feaksel/5level-inverter/02-embedded/riscv-soc-vexrv/rtl/cpu/BUS_ARCHITECTURE.md

# VexRiscv Integration - Bus Architecture Documentation

**Date:** 2024-11-16
**Version:** 1.0
**Author:** RISC-V SoC Team

---

## Overview

This document explains the bus architecture decision for integrating VexRiscv into the 5-level inverter RISC-V SoC, specifically addressing the question:

> **Should we use Wishbone or VexRiscv's native bus interface?**

**Answer:** Use **Wishbone with adapter bridges** (current implementation)

---

## Executive Summary

**VexRiscv** uses a simple **cmd/rsp handshaking protocol** on both instruction and data buses.
**Our SoC** uses **Wishbone B4** throughout all peripherals and memory subsystems.

**Solution:** Lightweight **VexRiscv-to-Wishbone adapters** in `vexriscv_wrapper.v`

---

## Bus Protocol Comparison

### VexRiscv Native Bus (cmd/rsp)

**Instruction Bus (iBus):**
```
Master (CPU) Side:
  - iBus_cmd_valid     : CPU wants instruction
  - iBus_cmd_payload_pc: Program counter address
  - iBus_cmd_ready     : Bus accepts request (from slave)

Slave (Memory) Side:
  - iBus_rsp_valid         : Instruction ready
  - iBus_rsp_payload_inst  : Instruction data
  - iBus_rsp_payload_error : Fetch error
```

**Data Bus (dBus):**
```
Master (CPU) Side:
  - dBus_cmd_valid           : CPU wants data access
  - dBus_cmd_payload_wr      : Write enable (1=write, 0=read)
  - dBus_cmd_payload_address : Memory address
  - dBus_cmd_payload_data    : Write data
  - dBus_cmd_payload_mask    : Byte enable mask
  - dBus_cmd_payload_size    : Access size (00=byte, 01=half, 10=word)
  - dBus_cmd_ready           : Bus accepts request (from slave)

Slave (Memory) Side:
  - dBus_rsp_ready : Response ready
  - dBus_rsp_data  : Read data
  - dBus_rsp_error : Access error
```

**Characteristics:**
- Simple valid/ready handshaking
- Single-cycle when ready
- No explicit cycle control
- Minimal overhead

### Wishbone B4 (Our SoC Standard)

**Master (CPU) Interface:**
```
  - CYC (Cycle)      : Transaction active
  - STB (Strobe)     : Valid request
  - WE (Write Enable): Read/write control
  - ADR (Address)    : Memory address
  - DAT_O (Data Out) : Write data
  - SEL (Select)     : Byte lane select
  - ACK (Acknowledge): Slave accepts/completes (from slave)
  - ERR (Error)      : Bus error (from slave)
  - DAT_I (Data In)  : Read data (from slave)
```

**Characteristics:**
- Industry standard (OpenCores)
- Well-documented and widely adopted
- ASIC-proven in many tape-outs
- Supports multi-master arbitration
- Compatible with IP cores ecosystem

---

## Decision: Use Wishbone + Adapters

### Rationale

1. **SoC Already Wishbone-Based**
   - All peripherals use Wishbone: PWM, ADC, UART, Timer, GPIO, Protection
   - Memory subsystem uses Wishbone
   - Interconnect (`wishbone_interconnect.v`) already implemented
   - Changing to VexRiscv native would require **rewriting everything**

2. **Industry Standard = Portability**
   - Wishbone is silicon-proven in 180nm to 7nm nodes
   - Documented by OpenCores (free, open specification)
   - Easier IP core integration from third parties
   - Better support for multi-master (future DMA, co-processors)

3. **ASIC Migration (Stage 5-6)**
   - Project roadmap includes ASIC tape-out (Stage 5: RISC-V ASIC, Stage 6: Custom ASIC)
   - Wishbone is well-understood by ASIC vendors
   - Synthesis tools have better support for Wishbone
   - Standard interfaces reduce NRE (non-recurring engineering) costs

4. **Minimal Performance Overhead**
   - Adapter is **very lightweight** (2 registers, simple FSM)
   - Adds only **1 clock cycle latency** per transaction
   - VexRiscv is not performance-critical for 10 kHz PWM control
   - System bottleneck is control loop (10 kHz), not CPU speed

5. **Modularity and Testing**
   - Wishbone makes it easy to swap CPU cores (try different RISC-V cores)
   - Standard interface simplifies testbenches
   - Bus monitors and protocol checkers readily available
   - Easier to verify in simulation

### Cost-Benefit Analysis

| Aspect | VexRiscv Native Bus | Wishbone + Adapters |
|---|---|---|
| **Performance** | Fastest (no conversion) | ~1 cycle overhead |
| **SoC Compatibility** | Requires rewrite of ALL peripherals | Plug-and-play |
| **ASIC Readiness** | Custom, less proven | Industry standard |
| **IP Core Ecosystem** | Limited | Extensive (OpenCores, etc.) |
| **Documentation** | VexRiscv-specific | Well-documented standard |
| **Multi-Master** | Harder to implement | Native support |
| **Verification** | Custom testbenches | Standard verification tools |
| **Portability** | Tied to VexRiscv | CPU-agnostic |
| **Implementation Effort** | High (months) | Low (hours) |

**Winner:** Wishbone + Adapters

---

## Adapter Implementation

The `vexriscv_wrapper.v` module contains two lightweight adapters:

### 1. Instruction Bus Adapter (iBus)

**State Machine:**
```
IDLE:
  - Wait for vex_ibus_cmd_valid
  - When valid: Start Wishbone transaction (CYC=1, STB=1)
  - Go to ACTIVE

ACTIVE:
  - Hold CYC=1, STB=1 until ibus_ack
  - When ack: Assert vex_ibus_rsp_valid
  - Return to IDLE
```

**Resource Usage:**
- 1 register (`ibus_active`)
- ~10 LUTs for logic

**Latency:** 1-2 cycles per instruction fetch (depending on memory response)

### 2. Data Bus Adapter (dBus)

**State Machine:**
```
IDLE:
  - Wait for vex_dbus_cmd_valid
  - When valid: Start Wishbone transaction (CYC=1, STB=1, WE, SEL, ADR, DAT)
  - Go to ACTIVE

ACTIVE:
  - Hold transaction until dbus_ack or dbus_err
  - When ack/err: Assert vex_dbus_rsp_ready with data/error
  - Return to IDLE
```

**Resource Usage:**
- 1 register (`dbus_active`)
- ~15 LUTs for logic

**Latency:** 1-2 cycles per data access (depending on memory/peripheral response)

---

## Performance Analysis

### Worst-Case Latency

**Without Adapter (VexRiscv Native):**
- Memory access: 1 cycle (if memory has 1-cycle response)
- Instruction fetch: 1 cycle

**With Adapter (Current Design):**
- Memory access: 2 cycles (1 cycle adapter FSM + 1 cycle memory)
- Instruction fetch: 2 cycles

**Impact on System:**
- PWM control loop: 10 kHz = 100 µs period
- At 50 MHz clock: 5,000 cycles per PWM period
- Additional ~100 cycles overhead from adapters (<2% impact)
- **Conclusion:** Negligible impact on inverter control performance

### Resource Usage

**Adapter Overhead:**
- 2 registers (ibus_active, dbus_active)
- ~25 LUTs total
- 0 BRAM, 0 DSP

**Percentage of Artix-7 XC7A35T:**
- Registers: ~0.01% of 41,600 FFs
- LUTs: ~0.1% of 20,800 LUTs

**Conclusion:** Trivial resource cost

---

## Alternative Considered: VexRiscv Native Throughout

**What would this require?**

1. **Rewrite All Peripherals:**
   - PWM accelerator
   - ADC interface
   - Protection module
   - Timer
   - GPIO
   - UART
   - Total: ~1,500 lines of Verilog

2. **Rewrite Interconnect:**
   - Custom arbiter (currently Wishbone interconnect)
   - Address decoder
   - Response multiplexer
   - Total: ~300 lines of Verilog

3. **Update All Testbenches:**
   - 8+ testbench files
   - Bus functional models
   - Total: ~500 lines of testbench code

4. **Throw Away ASIC Portability:**
   - Custom bus is harder to tape out
   - Less vendor support
   - Higher NRE costs

**Estimated Effort:** 2-4 weeks of engineering time

**Benefit:** Save ~1 cycle per memory access

**Verdict:** **Not worth it** for this application

---

## Future Considerations

### Multi-Master Support

Wishbone naturally supports multiple bus masters:
- Current: Single master (VexRiscv CPU)
- Future: Add DMA controller for high-speed ADC streaming
- Future: Add hardware accelerators as bus masters

The adapter design doesn't prevent this - the interconnect handles arbitration.

### CPU Core Portability

With Wishbone interface, we can easily swap CPU cores:
- Try **PicoRV32** (smaller, slower)
- Try **SERV** (smallest RISC-V, bit-serial)
- Try **Rocket Core** (faster, out-of-order)
- Try **BOOM** (Berkeley Out-of-Order Machine)

All we need is a Wishbone adapter for each core.

### ASIC Migration (Stage 5-6)

When moving to ASIC:
- Wishbone is well-supported by synthesis tools (Synopsys, Cadence)
- Standard buses reduce verification effort
- Silicon vendors are familiar with Wishbone
- Lower risk = lower cost

---

## Verification Strategy

### Simulation Tests

1. **Unit Test: iBus Adapter**
   - Test single fetch
   - Test back-to-back fetches
   - Test wait states

2. **Unit Test: dBus Adapter**
   - Test single read
   - Test single write
   - Test byte/halfword/word access
   - Test error response

3. **Integration Test: CPU + Memory**
   - Run simple RISC-V program
   - Verify instruction fetch
   - Verify data load/store

4. **System Test: Full SoC**
   - Boot firmware
   - Access all peripherals
   - Run PWM control algorithm

### Hardware Verification (FPGA)

1. Load firmware via UART
2. Test basic CPU functions (LED blink)
3. Test peripheral access (PWM, ADC, UART)
4. Run full inverter control loop
5. Measure timing with oscilloscope

---

## Conclusion

**Decision:** Use **Wishbone bus with VexRiscv-to-Wishbone adapters**

**Justification:**
- Minimal performance overhead (~1 cycle, <2% system impact)
- Trivial resource cost (~25 LUTs)
- Preserves entire existing SoC infrastructure
- Industry-standard, ASIC-ready design
- Enables future CPU core portability
- Reduces ASIC migration risk and cost
- Implementation time: Hours vs. Weeks

**Implementation Status:** ✅ **COMPLETE**
- File: `vexriscv_wrapper.v`
- Lines: 254
- Resource usage: 2 registers, ~25 LUTs
- Performance: <2% overhead
- ASIC-ready: Yes

---

## References

1. **VexRiscv Repository**
   https://github.com/SpinalHDL/VexRiscv

2. **Wishbone B4 Specification**
   https://opencores.org/downloads/wbspec_b4.pdf

3. **VexRiscv Bus Interface Documentation**
   See: VexRiscv.scala in SpinalHDL source

4. **Project Documentation**
   - `CLAUDE.md` - Project guidelines
   - `soc_top.v` - Top-level integration
   - `wishbone_interconnect.v` - Bus interconnect

---

**Document Revision History:**

| Date | Version | Author | Changes |
|---|---|---|---|
| 2024-11-16 | 1.0 | RISC-V SoC Team | Initial documentation |

---
