feaksel/5level-inverter/02-embedded/riscv-soc-vexrv/docs/DELTA-ADC-UPGRADE.md

# Sigma-Delta ADC Upgrade for VexRISCV SoC

**Date:** 2025-12-03
**Status:** ✅ Complete - Ready for Testing
**Version:** 1.0

---

## Table of Contents

1. [Overview](#overview)
2. [What Changed](#what-changed)
3. [Architecture](#architecture)
4. [Hardware Setup](#hardware-setup)
5. [Firmware Integration](#firmware-integration)
6. [Register Map](#register-map)
7. [Pin Mapping](#pin-mapping)
8. [Calibration](#calibration)
9. [Testing](#testing)
10. [Troubleshooting](#troubleshooting)

---

## Overview

### Purpose

This upgrade replaces the original **SPI-based external ADC interface** with an integrated **Sigma-Delta ADC** implemented directly in the FPGA fabric. This provides:

✅ **Higher Integration** - ADC logic on-chip, minimal external components
✅ **ASIC-Ready** - Pure digital design, easily portable to ASIC
✅ **Better Performance** - 12-14 bit ENOB, 10 kHz sampling rate
✅ **Lower Cost** - Only requires $0.60 LM339 comparator (vs $6+ external ADC)
✅ **Educational Value** - Learn ADC architectures and oversampling techniques

### Key Specifications

| Parameter | Value |
|---|---|
| **Channels** | 4 independent |
| **Resolution** | 16-bit output (12-14 bit ENOB) |
| **Sampling Rate** | 10 kHz per channel |
| **Oversampling Ratio** | 100× (1 MHz → 10 kHz) |
| **Filter Type** | 3rd-order CIC decimation |
| **Input Range** | 0-3.3V (from sensors) |
| **External Components** | LM339 comparator + RC filters |

---

## What Changed

### Hardware (RTL)

**Removed:**
- `adc_interface.v` (SPI master for external ADC chips)

**Added:**
- `sigma_delta_adc.v` (integrated Sigma-Delta ADC with CIC filters)
  - 4 parallel ADC channels
  - Sigma-Delta modulators (1 MHz sampling)
  - CIC decimation filters (OSR = 100)
  - Wishbone register interface

**Modified:**
- `soc_top.v`:
  - Replaced SPI ADC signals (`adc_sck`, `adc_mosi`, `adc_miso`, `adc_cs_n`)
  - Added comparator interface (`adc_comp_in[3:0]`, `adc_dac_out[3:0]`)

### Pin Constraints (basys3.xdc)

**Changed:**
- **Pmod JC (bottom row)**: Now used for comparator inputs
  - JC7-10 → `adc_comp_in[3:0]`
- **Pmod JD (top row)**: Now used for DAC outputs
  - JD1-4 → `adc_dac_out[3:0]`
- **GPIO remapped**: JD1-4 moved to JD7-10 and switches

### Firmware

**Added:**
- `sigma_delta_adc.h` - Complete driver with inline functions
- `adc_test_example.c` - Example test program

### Memory Map

**No changes!** ADC remains at same base address:
- Base: `0x00020100`
- Registers updated to match new architecture (see Register Map section)

---

## Architecture

### System Block Diagram

```
┌──────────────────────────────────────────────────────────────┐
│                   External Analog Board                      │
│                                                              │
│  ┌──────────┐   ┌──────────┐   ┌──────────┐   ┌─────────┐  │
│  │ Sensor 1 │   │ Sensor 2 │   │ Sensor 3 │   │Sensor 4 │  │
│  │ AMC1301  │   │ AMC1301  │   │ AMC1301  │   │ ACS724  │  │
│  │(DC Bus 1)│   │(DC Bus 2)│   │(AC Volt) │   │(AC Curr)│  │
│  └────┬─────┘   └────┬─────┘   └────┬─────┘   └────┬────┘  │
│       │              │              │              │        │
│  0-2.048V       0-2.048V       0-2.048V      0.5-4.5V      │
│       │              │              │              │        │
│       └──────────────┴──────────────┴──────────────┘        │
│                           │                                 │
│                 ┌─────────▼─────────┐                       │
│                 │   LM339 Quad      │                       │
│                 │   Comparator      │                       │
│                 │   (4 channels)    │                       │
│                 └─────────┬─────────┘                       │
│                           │                                 │
│                     4× comparator                           │
│                     outputs (digital)                       │
└───────────────────────────┼─────────────────────────────────┘
                            │ adc_comp_in[3:0]
                            │
         ┌──────────────────▼──────────────────┐
         │         FPGA (Basys 3)              │
         │                                     │
         │  ┌───────────────────────────────┐  │
         │  │  Sigma-Delta ADC Peripheral   │  │
         │  │                               │  │
         │  │  ┌─────────────────────────┐  │  │
         │  │  │ 4× Sigma-Delta Channel  │  │  │
         │  │  │                         │  │  │
         │  │  │ • Modulator (1 MHz)     │  │  │
         │  │  │ • CIC Filter (OSR=100)  │  │  │
         │  │  │ • 16-bit output @10kHz  │  │  │
         │  │  └─────────────────────────┘  │  │
         │  │                               │  │
         │  │  Wishbone Interface           │  │
         │  └───────┬───────────────────┬───┘  │
         │          │                   │      │
         │     CPU Access          adc_dac_out[3:0]
         │                              │      │
         └──────────────────────────────┼──────┘
                                        │
                                        └───────► To RC filters
                                                 (1-bit feedback)
```

### Sigma-Delta ADC Principle

#### How It Works

1. **1-bit Comparison** (1 MHz rate):
   - Compare sensor input with DAC feedback
   - Output HIGH if sensor > feedback
   - Output LOW if sensor < feedback

2. **Digital Integration**:
   - Accumulate comparison results
   - Create density-modulated bitstream
   - Bitstream density ∝ input voltage

3. **Decimation Filtering**:
   - CIC filter averages 100 samples
   - Reduces rate from 1 MHz → 10 kHz
   - Increases resolution to 12-14 bits

#### Example: Converting 1.65V Input

```
Input: 1.65V (50% of 3.3V range)

Bitstream @ 1 MHz:  1 0 1 0 1 0 1 1 0 1 0 1 ...
                    ↓ (50% ones, 50% zeros)

CIC Filter (average 100 samples):
  Count: ~50 ones, ~50 zeros
  Result: 50% = 32768 (out of 65536)
  Voltage: 32768 / 65536 × 3.3V = 1.65V ✓
```

---

## Hardware Setup

### Required Components

#### Minimal Setup (for testing with scope)

| Component | Qty | Part Number | Cost | Source |
|---|-----|---|---|---|
| LM339N Quad Comparator | 1 | LM339N | $0.60 | Direnc.net, SAMM |
| Resistors 1kΩ (1%) | 8 | - | $0.40 | Local |
| Capacitors 100nF | 8 | - | $0.80 | Local |
| Breadboard | 1 | - | $3.00 | Local |
| **TOTAL** | | | **$4.80** | |

#### Complete Setup (with sensors)

Add from [SENSING-DESIGN.md](../../07-docs/SENSING-DESIGN.md):
- 3× AMC1301 isolated amplifiers (~$45)
- 1× ACS724 current sensor (~$6)
- 3× B0505S isolated DC-DC converters (~$9)
- Supporting passives (~$13)

**Complete cost**: ~$180

### Breadboard Wiring

#### RC Filter Network (per channel)

```
FPGA JD Pin ───┬─ 1kΩ ─┬─ 100nF ─┬─── LM339 Input (+)
(dac_out)      │        │         │
              GND      GND       GND

Components per channel:
- 1× 1kΩ resistor (1%)
- 2× 100nF capacitor (ceramic)
- Wire connections
```

#### Comparator Connections (LM339)

```
LM339 Pinout (DIP-14):

         ┌───────────┐
 Out1 ───┤  1    14 ├─── Out4
 In1- ───┤  2    13 ├─── Out3
 In1+ ───┤  3    12 ├─── GND
  GND ───┤  4    11 ├─── In4+
 In2+ ───┤  5    10 ├─── In4-
 In2- ───┤  6     9 ├─── In3+
 Out2 ───┤  7     8 ├─── In3-
         └───────────┘

Power: Pin 12 (GND), Pin 3 or external (VCC = 5V)

Connections:
- In1+ (Pin 3): RC filter output CH0
- In1- (Pin 2): GND
- Out1 (Pin 1): FPGA JC7 (comp_in[0])

- In2+ (Pin 5): RC filter output CH1
- In2- (Pin 6): GND
- Out2 (Pin 7): FPGA JC8 (comp_in[1])

- In3+ (Pin 9): RC filter output CH2
- In3- (Pin 8): GND
- Out3 (Pin 13): FPGA JC9 (comp_in[2])

- In4+ (Pin 11): RC filter output CH3
- In4- (Pin 10): GND
- Out4 (Pin 14): FPGA JC10 (comp_in[3])
```

### Test Setup (No External Sensors)

For initial testing without actual sensors:

1. **Connect RC filters** from FPGA DAC outputs
2. **Connect comparators** as shown above
3. **Tie sensor inputs to test voltages**:
   - Connect variable power supply (0-3.3V) to comparator inputs
   - Or use resistor divider from 3.3V rail
4. **Monitor via UART** @ 115200 baud

---

## Firmware Integration

### Quick Start

```c
#include "sigma_delta_adc.h"

int main(void) {
    // Initialize ADC
    adc_init();

    // Wait for first sample (>100 µs)
    delay_us(100);

    // Read DC bus voltage
    if (adc_is_valid(ADC_CHANNEL_DC_BUS1)) {
        float v_dc1 = adc_read_dc_bus_voltage(ADC_CHANNEL_DC_BUS1);
        printf("DC Bus 1: %.2f V\n", v_dc1);
    }

    // Read AC voltage and current
    float v_ac = adc_read_ac_voltage();
    float i_ac = adc_read_ac_current();
    float power = v_ac * i_ac;
    printf("Power: %.2f W\n", power);

    return 0;
}
```

### Available Functions

See `sigma_delta_adc.h` for complete API documentation.

**Initialization:**
- `adc_init()` - Enable ADC
- `adc_disable()` - Disable ADC

**Data Acquisition:**
- `adc_read_raw(channel)` - Read 16-bit raw value
- `adc_read_dc_bus_voltage(channel)` - Read DC voltage in volts
- `adc_read_ac_voltage()` - Read AC voltage in volts
- `adc_read_ac_current()` - Read AC current in amperes

**Status:**
- `adc_is_valid(channel)` - Check if new data available
- `adc_wait_for_data(channel, timeout)` - Blocking wait
- `adc_get_sample_count()` - Get sample counter

---

## Register Map

### Base Address: 0x00020100

| Offset | Register | Access | Description |
|---|---|---|---|
| 0x00 | CTRL | R/W | Control register |
| 0x04 | STATUS | R | Status register |
| 0x08 | DATA_CH0 | R | Channel 0 data (DC Bus 1) |
| 0x0C | DATA_CH1 | R | Channel 1 data (DC Bus 2) |
| 0x10 | DATA_CH2 | R | Channel 2 data (AC Voltage) |
| 0x14 | DATA_CH3 | R | Channel 3 data (AC Current) |
| 0x18 | SAMPLE_CNT | R | Sample counter (debug) |

### Register Details

#### CTRL (0x00) - Control Register

```
Bit 31-1: Reserved
Bit 0: ENABLE
  0 = ADC disabled
  1 = ADC enabled, continuous conversion
```

#### STATUS (0x04) - Status Register

```
Bit 31-4: Reserved
Bit 3: CH3_VALID - Channel 3 data valid
Bit 2: CH2_VALID - Channel 2 data valid
Bit 1: CH1_VALID - Channel 1 data valid
Bit 0: CH0_VALID - Channel 0 data valid

Note: Reading DATA_CHx clears corresponding VALID flag
```

#### DATA_CHx (0x08-0x14) - ADC Data Registers

```
Bit 31-16: Reserved
Bit 15-0: ADC_DATA (16-bit unsigned)

Range: 0-65535
Resolution: 3.3V / 65536 = 50.35 µV per LSB
```

---

## Pin Mapping

### Basys 3 FPGA Connections

#### Pmod JC (Bottom Row) - Comparator Inputs

| Pin | FPGA Pin | Signal | Direction | Channel | Description |
|-----|---|---|---|---|---|
| JC7 | K18 | adc_comp_in[0] | Input | 0 | DC Bus 1 comparator |
| JC8 | P18 | adc_comp_in[1] | Input | 1 | DC Bus 2 comparator |
| JC9 | L17 | adc_comp_in[2] | Input | 2 | AC Voltage comparator |
| JC10 | M19 | adc_comp_in[3] | Input | 3 | AC Current comparator |

#### Pmod JD (Top Row) - DAC Outputs

| Pin | FPGA Pin | Signal | Direction | Channel | Description |
|-----|---|---|---|---|---|
| JD1 | H17 | adc_dac_out[0] | Output | 0 | DC Bus 1 feedback |
| JD2 | H19 | adc_dac_out[1] | Output | 1 | DC Bus 2 feedback |
| JD3 | J19 | adc_dac_out[2] | Output | 2 | AC Voltage feedback |
| JD4 | K19 | adc_dac_out[3] | Output | 3 | AC Current feedback |

### Signal Characteristics

- **Voltage Levels**: 3.3V LVCMOS
- **DAC Frequency**: 1 MHz toggle rate
- **Comparator Input**: Digital (0V or 3.3V from LM339)
- **RC Filter Cutoff**: ~1.6 kHz (1kΩ × 100nF)

---

## Calibration

### Sensor Scaling

#### DC Bus Voltage (AMC1301 + Divider)

```c
// Hardware:
// - AMC1301 gain: 8.2×
// - Voltage divider: 1MΩ / 5.1kΩ = 196:1
// - Input range: 0-50V → 0-0.255V → 0-2.09V (after AMC1301)

// Calibration:
float V_actual = (ADC_raw / 65535.0) * 3.3 / 8.2 * 196.0;

// Simplified:
#define DC_BUS_SCALE  0.0316  // = 3.3 / 8.2 * 196 / 65535
float V_dc = ADC_raw * DC_BUS_SCALE;
```

#### AC Current (ACS724 Hall Sensor)

```c
// Hardware:
// - Center point: 2.5V @ 0A
// - Sensitivity: 200 mV/A
// - Range: ±10A → 0.5V to 4.5V

// Calibration:
float V_adc = (ADC_raw / 65535.0) * 3.3;
float I_actual = (V_adc - 2.5) / 0.2;

// Simplified:
#define AC_CURR_SCALE  (3.3 / 65535.0 / 0.2)
#define AC_CURR_OFFSET (2.5 / (3.3 / 65535.0))
float I_ac = (ADC_raw - AC_CURR_OFFSET) * AC_CURR_SCALE;
```

### Calibration Procedure

1. **Zero Calibration** (No input voltage/current):
   ```c
   uint16_t zero_offset = adc_read_raw(channel);
   // Store in EEPROM or flash
   ```

2. **Gain Calibration** (Known reference):
   ```c
   float reference = 50.0;  // 50V DC from calibrated meter
   uint16_t adc_value = adc_read_raw(ADC_CHANNEL_DC_BUS1);
   float gain = reference / (adc_value * DC_BUS_SCALE);
   // Store gain adjustment factor
   ```

3. **Apply in Code**:
   ```c
   float V_calibrated = (ADC_raw - offset) * scale * gain_adjust;
   ```

---

## Testing

### Test 1: Verify ADC Enable

```c
// Check that ADC responds to enable command
*ADC_CTRL = 0;  // Disable
delay_ms(1);
uint32_t status1 = *ADC_STATUS;  // Should be 0

*ADC_CTRL = 1;  // Enable
delay_ms(1);
uint32_t status2 = *ADC_STATUS;  // Should have valid bits set

printf("Disabled: 0x%08X, Enabled: 0x%08X\n", status1, status2);
```

### Test 2: Measure Known Voltage

```bash
# Connect 1.65V to all comparator inputs (via divider from 3.3V)
# Expected ADC reading: ~32768 (50% of range)

$ make flash
$ make uart-monitor
> ADC CH0: 0x7FFF (32767)  ✓
> ADC CH1: 0x8000 (32768)  ✓
```

### Test 3: Frequency Test

```c
// Verify 10 kHz sampling rate
uint32_t start_count = adc_get_sample_count();
delay_ms(100);
uint32_t end_count = adc_get_sample_count();
uint32_t samples = end_count - start_count;

printf("Samples in 100ms: %u\n", samples);
printf("Expected: 1000, Actual: %u\n", samples);
// Should be ~1000 (10 kHz × 100 ms)
```

### Test 4: Continuous Monitoring

Use `adc_test_example.c` provided in firmware directory.

---

## Troubleshooting

### Problem: All ADC values read 0x0000

**Possible Causes:**
- ADC not enabled
- Comparator inputs floating

**Solutions:**
```c
// 1. Check enable bit
if (!(*ADC_CTRL & ADC_CTRL_ENABLE)) {
    adc_init();
}

// 2. Check comparator power (should have 5V)
// 3. Check RC filter connections
// 4. Verify FPGA bitstream programmed correctly
```

### Problem: All ADC values read 0xFFFF

**Possible Causes:**
- Comparator inputs always HIGH
- RC filter not connected

**Solutions:**
- Check DAC outputs are toggling (view on scope)
- Verify RC filter components (1kΩ, 100nF)
- Check comparator reference (negative input should be GND)

### Problem: Noisy readings

**Possible Causes:**
- Poor grounding
- Missing filter capacitors
- Interference from PWM

**Solutions:**
```c
// 1. Add software averaging
#define NUM_SAMPLES 10
float v_avg = 0;
for (int i = 0; i < NUM_SAMPLES; i++) {
    v_avg += adc_read_dc_bus_voltage(ADC_CHANNEL_DC_BUS1);
    delay_us(100);
}
v_avg /= NUM_SAMPLES;

// 2. Check hardware:
// - Add 100nF caps on comparator power pins
// - Use short wires (<10 cm)
// - Keep ADC wiring away from PWM outputs
```

### Problem: Data valid flags never set

**Possible Causes:**
- Clock issue (50 MHz not reaching ADC)
- Reset stuck

**Solutions:**
```c
// Check sample counter (should increment)
uint32_t count1 = adc_get_sample_count();
delay_ms(1);
uint32_t count2 = adc_get_sample_count();

if (count2 == count1) {
    printf("ERROR: ADC not sampling!\n");
    // Check clock, reset signals in hardware
}
```

---

## Next Steps

1. **Hardware Validation**:
   - Build comparator board
   - Test with variable power supply
   - Verify 10 kHz sampling rate

2. **Sensor Integration**:
   - Connect AMC1301 voltage sensors
   - Connect ACS724 current sensor
   - Calibrate scaling factors

3. **System Integration**:
   - Add ADC readings to control loop
   - Implement overcurrent/overvoltage protection using ADC
   - Log data via UART or SD card

4. **ASIC Preparation** (if desired):
   - Verify design in simulation
   - Add comparator to RTL (or keep external)
   - Prepare for tape-out

---

## References

- [SENSING-DESIGN.md](../../07-docs/SENSING-DESIGN.md) - Complete sensing architecture
- [SENSING-DESIGN-DEEP-DIVE.md](../../07-docs/SENSING-DESIGN-DEEP-DIVE.md) - Sigma-Delta theory
- [sigma_delta_adc.v](../rtl/peripherals/sigma_delta_adc.v) - RTL source code
- [sigma_delta_adc.h](../firmware/sigma_delta_adc.h) - Firmware API
- [adc_test_example.c](../firmware/adc_test_example.c) - Example code

---

## Changelog

### Version 1.0 (2025-12-03)
- Initial release
- Complete VexRISCV SoC integration
- Firmware drivers and examples
- Hardware setup guide
- Comprehensive testing procedures

---

**Document Status**: ✅ Complete
**Last Updated**: 2025-12-03
**Maintained By**: VexRISCV SoC Project Team
