feaksel/5level-inverter/02-embedded/riscv-soc-vexrv/docs/PWM_SIGNAL_FLOW.md

# PWM Signal Flow Diagram

This document explains how PWM signals flow from the hardware generator to physical FPGA pins and ultimately to the H-bridge gate drivers.

---

## 🔄 Signal Flow Overview

```
RISC-V CPU → Wishbone Bus → PWM Accelerator → 8 PWM Channels → FPGA Pins → Gate Drivers → H-Bridge Switches
```

---

## 📊 Detailed Signal Flow

### 1. CPU Control (Firmware)

**Firmware writes PWM configuration:**
```
Base Address: 0x00020000

Register Writes:
  [0x04] FREQ_DIV  = 5000    → 5 kHz carrier
  [0x08] MOD_INDEX = 16384   → 50% modulation
  [0x10] SINE_FREQ = 100     → 76 kHz sine
  [0x14] DEADTIME  = 50      → 1 μs dead-time
  [0x00] CTRL      = 1       → Enable, Auto Sine mode
```

### 2. PWM Accelerator Internal Processing

```
┌─────────────────────────────────────────────────────────────┐
│                    PWM ACCELERATOR                          │
│                  (rtl/peripherals/pwm_accelerator.v)        │
├─────────────────────────────────────────────────────────────┤
│                                                             │
│  ┌──────────────────┐         ┌──────────────────┐         │
│  │ Carrier Generator│         │  Sine Generator  │         │
│  │  (carrier_gen)   │         │   (sine_gen)     │         │
│  └────────┬─────────┘         └────────┬─────────┘         │
│           │                            │                   │
│           │ carrier1: -32768 to -1     │ sine_ref          │
│           │ carrier2: 0 to +32767      │ -32768 to +32767  │
│           │                            │                   │
│           └────────────┬───────────────┘                   │
│                        ▼                                   │
│         ┌──────────────────────────────┐                   │
│         │    4× PWM Comparators        │                   │
│         │  (pwm_comp1..pwm_comp4)      │                   │
│         │  with Dead-time Insertion    │                   │
│         └──────────────┬───────────────┘                   │
│                        │                                   │
│                        ▼                                   │
│              pwm_out[7:0] (8 channels)                     │
│                                                             │
└─────────────────────────────────────────────────────────────┘
```

### 3. PWM Comparator Details

**Each comparator generates complementary pair with dead-time:**

```
┌─────────────────────────────────────────┐
│       PWM Comparator Instance           │
├─────────────────────────────────────────┤
│                                         │
│  Inputs:                                │
│    - reference (sine_ref)               │
│    - carrier (carrier1 or carrier2)     │
│    - deadtime (50 cycles)               │
│                                         │
│  Logic:                                 │
│    raw_pwm = (reference > carrier)      │
│                                         │
│    pwm_high = raw_pwm & !dead_time      │
│    pwm_low  = !raw_pwm & !dead_time     │
│                                         │
│  Outputs:                               │
│    - pwm_high (high-side switch)        │
│    - pwm_low  (low-side switch)         │
│                                         │
└─────────────────────────────────────────┘
```

### 4. Channel Assignment

```
┌────────────────────────────────────────────────────────────────┐
│                   PWM Channel Mapping                          │
├────┬──────┬────────┬──────────┬──────┬──────┬─────────────────┤
│Bit │Signal│Switch  │H-Bridge  │ Leg  │ Side │ Carrier Used    │
├────┼──────┼────────┼──────────┼──────┼──────┼─────────────────┤
│ 0  │ S1   │High    │    1     │  1   │ High │ carrier1        │
│ 1  │ S1'  │Low     │    1     │  1   │ Low  │ carrier1        │
│ 2  │ S3   │High    │    1     │  2   │ High │ carrier1        │
│ 3  │ S3'  │Low     │    1     │  2   │ Low  │ carrier1        │
│ 4  │ S5   │High    │    2     │  1   │ High │ carrier2        │
│ 5  │ S5'  │Low     │    2     │  1   │ Low  │ carrier2        │
│ 6  │ S7   │High    │    2     │  2   │ High │ carrier2        │
│ 7  │ S7'  │Low     │    2     │  2   │ Low  │ carrier2        │
└────┴──────┴────────┴──────────┴──────┴──────┴─────────────────┘
```

### 5. SOC Top-Level Connection

```
┌─────────────────────────────────────────┐
│        soc_top.v                        │
│                                         │
│  ┌───────────────────────────────────┐  │
│  │  pwm_peripheral (PWM Accelerator) │  │
│  │                                   │  │
│  │  .pwm_out[7:0] ──────────────────┼──┼──→ pwm_out[7:0]
│  │                                   │  │     (top-level output)
│  └───────────────────────────────────┘  │
│                                         │
└─────────────────────────────────────────┘
```

### 6. FPGA Pin Assignment (constraints/basys3.xdc)

```
┌────────────────────────────────────────────────────────────┐
│                  Basys 3 Pin Mapping                       │
├──────────┬─────────┬────────────┬───────────┬─────────────┤
│ Signal   │  Bit    │ Pmod Pin   │ FPGA Pin  │ Gate Driver │
├──────────┼─────────┼────────────┼───────────┼─────────────┤
│ pwm_out[0] (S1 )  │  JA1       │   J1      │  Driver 1+  │
│ pwm_out[1] (S1') │  JA2       │   L2      │  Driver 1-  │
│ pwm_out[2] (S3 )  │  JA3       │   J2      │  Driver 2+  │
│ pwm_out[3] (S3') │  JA4       │   G2      │  Driver 2-  │
│ pwm_out[4] (S5 )  │  JB1       │   A14     │  Driver 3+  │
│ pwm_out[5] (S5') │  JB2       │   A16     │  Driver 3-  │
│ pwm_out[6] (S7 )  │  JB3       │   B15     │  Driver 4+  │
│ pwm_out[7] (S7') │  JB4       │   B16     │  Driver 4-  │
└──────────┴─────────┴────────────┴───────────┴─────────────┘
```

---

## 🔌 Physical Connection Diagram

```
Basys 3 FPGA                 Pmod Connectors              Gate Drivers              H-Bridge Modules
┌─────────────┐              ┌──────────┐               ┌──────────┐              ┌──────────────┐
│             │              │  Pmod JA │               │          │              │  H-Bridge 1  │
│  pwm_out[0] ├─────────────►│   JA1    ├──────────────►│ Driver 1+├─────────────►│    Leg 1     │
│  (Pin J1)   │              │          │               │          │              │    S1 (High) │
│             │              │          │               │          │              │              │
│  pwm_out[1] ├─────────────►│   JA2    ├──────────────►│ Driver 1-├─────────────►│    S1' (Low) │
│  (Pin L2)   │              │          │               │          │              │              │
│             │              │          │               │          │              ├──────────────┤
│  pwm_out[2] ├─────────────►│   JA3    ├──────────────►│ Driver 2+├─────────────►│    Leg 2     │
│  (Pin J2)   │              │          │               │          │              │    S3 (High) │
│             │              │          │               │          │              │              │
│  pwm_out[3] ├─────────────►│   JA4    ├──────────────►│ Driver 2-├─────────────►│    S3' (Low) │
│  (Pin G2)   │              └──────────┘               └──────────┘              └──────────────┘
│             │
│             │              ┌──────────┐               ┌──────────┐              ┌──────────────┐
│             │              │  Pmod JB │               │          │              │  H-Bridge 2  │
│  pwm_out[4] ├─────────────►│   JB1    ├──────────────►│ Driver 3+├─────────────►│    Leg 1     │
│  (Pin A14)  │              │          │               │          │              │    S5 (High) │
│             │              │          │               │          │              │              │
│  pwm_out[5] ├─────────────►│   JB2    ├──────────────►│ Driver 3-├─────────────►│    S5' (Low) │
│  (Pin A16)  │              │          │               │          │              │              │
│             │              │          │               │          │              ├──────────────┤
│  pwm_out[6] ├─────────────►│   JB3    ├──────────────►│ Driver 4+├─────────────►│    Leg 2     │
│  (Pin B15)  │              │          │               │          │              │    S7 (High) │
│             │              │          │               │          │              │              │
│  pwm_out[7] ├─────────────►│   JB4    ├──────────────►│ Driver 4-├─────────────►│    S7' (Low) │
│  (Pin B16)  │              └──────────┘               └──────────┘              └──────────────┘
└─────────────┘
```

---

## ⚡ Signal Characteristics

### Timing Waveforms

```
Time (μs)      0        50       100      150      200
               │        │        │        │        │
carrier1    ───┘▔▔▔▔▔▔▔▔▔────────────────────▔▔▔▔▔▔▔▔▔───
               -32768   -1  -32768  -1  -32768   -1

carrier2    ───────────────▔▔▔▔▔▔▔▔▔────────────▔▔▔▔▔▔▔▔▔─
                     0    32767  0    32767  0   32767

sine_ref    ───▁▁▁▁▁▁▁▁▁▁▁▔▔▔▔▔▔▔▔▔▁▁▁▁▁▁▁▁▁▁▁▔▔▔▔▔▔▔▔▔───
               (76 kHz sinusoidal modulation)

S1 (bit 0)  ▔▔▔▔▁▁▁▁▁▁▔▔▔▔▔▔▔▔▔▔▁▁▁▁▁▁▔▔▔▔▔▔▔▔▔▔▁▁▁▁▁▁▔▔▔
               (PWM switching with varying duty cycle)

S1' (bit 1) ▁▁▁▁▔▔▔▔▔▔▁▁▁▁▁▁▁▁▁▁▔▔▔▔▔▔▁▁▁▁▁▁▁▁▁▁▔▔▔▔▔▔▁▁▁
               (Complementary to S1, with dead-time)
                  ↑
                  └─── Dead-time gap (1 μs)
```

### Level-Shifted Carriers Explained

**Why two carriers?**

For 5-level cascaded H-bridge inverters, we need phase-shifted PWM signals:
- **H-Bridge 1:** Uses carrier1 (-32768 to -1)
- **H-Bridge 2:** Uses carrier2 (0 to +32767)

This creates a **180° phase shift** between bridge modules, resulting in 5 distinct output voltage levels when combined.

```
Output Levels:
  +2V  = Both bridges positive
  +1V  = One bridge positive, one zero
   0V  = Both bridges zero
  -1V  = One bridge negative, one zero
  -2V  = Both bridges negative
```

---

## 🔧 Dead-Time Mechanism

Dead-time prevents **shoot-through** (both switches in one leg conducting simultaneously).

```
Without Dead-Time (DANGEROUS!):
────────────────────────────────
S1  (High) ▔▔▔▔▔▔▁▁▁▁▁▁▔▔▔▔▔▔    ← Switches instantly
S1' (Low)  ▁▁▁▁▁▁▔▔▔▔▔▔▁▁▁▁▁▁    ← OVERLAP! Short circuit!
              ↑↑ ← Both ON at same time!

With Dead-Time (SAFE):
────────────────────────────────
S1  (High) ▔▔▔▔▔▁▁▁▁▁▁▁▁▔▔▔▔▔▔   ← Turns OFF early
S1' (Low)  ▁▁▁▁▁▁▁▁▁▔▔▔▔▁▁▁▁▁▁   ← Turns ON late
              └──┘ ← Dead-time gap (50 cycles = 1 μs)
```

---

## 📈 Signal Verification

### Verilog Simulation Results

```
Channel Transitions in 100,000 clock cycles (2 ms @ 50 MHz):

CH0 (S1 ): 164 transitions  ✓ Switching
CH1 (S1'): 158 transitions  ✓ Complementary
CH2 (S3 ): 164 transitions  ✓ Switching
CH3 (S3'): 158 transitions  ✓ Complementary
CH4 (S5 ): 160 transitions  ✓ Switching
CH5 (S5'): 161 transitions  ✓ Complementary
CH6 (S7 ): 160 transitions  ✓ Switching
CH7 (S7'): 161 transitions  ✓ Complementary

PWM State Changes: 0x05 → 0xa5 → 0xa0 → 0x05 → ...
   Binary breakdown:
   0x05 = 00000101  (S1=1, S3=1, others=0)
   0xa5 = 10100101  (S1=1, S3=1, S5'=1, S7=1)
   0xa0 = 10100000  (S5'=1, S7=1, others=0)
```

### Expected Oscilloscope Measurements

When connected to actual hardware, you should observe:

**Carrier Frequency:**
- Period: 200 μs
- Frequency: 5 kHz

**PWM Switching:**
- Varying duty cycle following sine modulation
- Dead-time: ~1 μs visible between complementary transitions

**Complementary Pairs:**
- S1 and S1' never both high
- Dead-time gap visible at transitions

---

## 🎯 Summary

**Signal Path:**
1. CPU writes configuration → Wishbone registers
2. Carrier generator → Creates 5 kHz triangle wave
3. Sine generator → Creates 76 kHz modulation reference
4. PWM comparators → Generate 8 PWM channels with dead-time
5. FPGA pins (Pmod JA/JB) → Output 3.3V LVCMOS signals
6. Gate drivers → Isolate and amplify to gate voltage
7. H-bridge switches → Switch power to load

**Key Features:**
- ✅ 8 complementary channels with hardware dead-time
- ✅ Level-shifted carriers for 5-level output
- ✅ Hardware sine generation (no CPU intervention)
- ✅ Configurable via Wishbone registers
- ✅ Verified in Verilog simulation

**All signals are continuously cycling and ready for hardware deployment!**
