feaksel/5level-inverter/02-embedded/riscv/docs/THERMAL_MONITORING_GUIDE.md

# MOSFET Thermal Monitoring Implementation Guide

**Project:** 5-Level Cascaded H-Bridge Inverter
**Target Platform:** RISC-V Custom SoC
**Document Version:** 1.0
**Last Updated:** 2025-12-09
**Author:** Project Team

---

## Table of Contents

1. [Overview](#1-overview)
2. [Why Thermal Monitoring is Critical](#2-why-thermal-monitoring-is-critical)
3. [Hardware Design](#3-hardware-design)
4. [RTL Modifications](#4-rtl-modifications)
5. [Firmware Implementation](#5-firmware-implementation)
6. [Integration and Testing](#6-integration-and-testing)
7. [Calibration Procedures](#7-calibration-procedures)
8. [Troubleshooting](#8-troubleshooting)
9. [Performance Analysis](#9-performance-analysis)
10. [Appendix](#10-appendix)

---

## 1. Overview

### 1.1 Purpose

This document provides complete implementation instructions for adding MOSFET thermal monitoring to the 5-level inverter RISC-V control system. Thermal monitoring prevents catastrophic MOSFET failures due to overheating.

### 1.2 What Gets Added

**Hardware Components:**
- 2× NTC thermistors (one per H-bridge)
- 2× voltage divider circuits
- 1× dual comparator IC (optional but recommended)
- Supporting resistors and connections

**RTL Changes:**
- Expand ADC interface from 4 to 6 channels
- Add 2 thermal fault bits to protection module
- Wire thermal inputs to top-level SoC

**Firmware:**
- Temperature conversion algorithms (Steinhart-Hart equation)
- Thermal fault detection with hysteresis
- Integration with control loop ISR

### 1.3 Design Approach

We use a **hybrid dual-layer protection** approach:

1. **Layer 1: Hardware Comparator (Fast)**
   - External analog comparator monitors thermistor voltage
   - Triggers fault immediately when temperature exceeds threshold
   - Response time: <10 µs
   - Does not require CPU intervention

2. **Layer 2: Software Monitoring (Intelligent)**
   - ADC samples thermistor voltage every control cycle
   - CPU calculates precise temperature using Steinhart-Hart equation
   - Implements warning levels, trend analysis, and logging
   - Response time: ~100 µs (1 control cycle)

**Why Both?**
- Hardware layer provides fail-safe protection even if CPU crashes
- Software layer provides precise temperature readings and predictive warnings
- Redundancy is critical for safety-critical applications

### 1.4 Implementation Checklist

- [ ] Order components (see BOM in Section 3.2)
- [ ] Modify RTL files (Section 4)
- [ ] Synthesize and test in simulation
- [ ] Solder hardware circuits (Section 3.3)
- [ ] Write firmware (Section 5)
- [ ] Perform calibration (Section 7)
- [ ] Test with controlled heating (Section 6.4)
- [ ] Validate fault response times
- [ ] Document final threshold values

**Estimated Time:** 4-6 hours total (first-time implementation)

---

## 2. Why Thermal Monitoring is Critical

### 2.1 MOSFET Thermal Failure Modes

**Problem:** Power MOSFETs generate significant heat during operation:

```
P_loss = P_conduction + P_switching

P_conduction = I²_rms × R_ds(on)
P_switching = V_ds × I_ds × (t_rise + t_fall) × f_sw / 2

For our application:
- I_rms ≈ 7A (5A load + ripple)
- R_ds(on) ≈ 0.1Ω @ 25°C
- Switching: 100V × 5A × 1µs × 10kHz / 2 = 2.5W
- Conduction: 7² × 0.1 = 4.9W
- TOTAL: ~7.4W per MOSFET
```

**Thermal Runaway Process:**

1. **Initial Heating** (0-30 seconds)
   - Junction temperature rises from 25°C → 60°C
   - R_ds(on) increases by ~30% (positive temp coefficient)
   - Power dissipation increases slightly

2. **Accelerated Heating** (30-90 seconds)
   - Junction temp: 60°C → 100°C
   - R_ds(on) increases by ~75%
   - Power dissipation increases significantly
   - Thermal resistance from junction to heatsink matters

3. **Catastrophic Failure** (>90 seconds without protection)
   - Junction temp: >125°C (max rating)
   - Wire bond liftoff, die cracking, or package delamination
   - Permanent device failure
   - **Cost:** $2-5 per MOSFET + downtime + reputation

### 2.2 Current Protection Gaps

Your existing protection module has:

✅ **Overcurrent protection** - Catches electrical faults
✅ **Overvoltage protection** - Prevents insulation breakdown
✅ **E-stop** - Emergency shutdown
✅ **Watchdog** - Catches software hangs

❌ **Missing: Thermal monitoring**

**Why Existing Protection Isn't Enough:**

- **Overcurrent doesn't catch thermal issues:**
  - MOSFETs can overheat at normal currents with poor heatsinking
  - Ambient temperature variations (25°C vs 45°C room temp)
  - Aging effects (thermal paste degradation over time)

- **Watchdog doesn't help:**
  - Thermal failures are gradual (30-90 seconds)
  - CPU continues running normally during thermal buildup

### 2.3 Cost-Benefit Analysis

| Metric | Without Thermal Monitoring | With Thermal Monitoring |
|---|---|---|
| **MOSFET Failure Rate** | ~5-10% per year (estimated) | <0.1% per year |
| **Failure Cost** | $50-100 per incident | $0 (prevented) |
| **Implementation Cost** | $0 | $1.22 BOM + 4 hours labor |
| **ROI Period** | N/A | <1 failure prevented |
| **Safety Rating** | Moderate risk | High safety |

**Verdict:** Return on investment after preventing just ONE MOSFET failure. Essential for production systems.

---

## 3. Hardware Design

### 3.1 Thermistor Selection

**Recommended Part:** Murata NCP15XH103F03RC

**Specifications:**
```
Resistance @ 25°C:  10kΩ ±1%
β-parameter:        3380K ±1%
Operating range:    -40°C to +125°C
Thermal time const: ~5 seconds (in air)
Power dissipation:  0.15mW @ 25°C (self-heating negligible)
Package:            Radial leaded, 2.5mm diameter
Cost:               ~$0.30 USD (qty 100)
```

**Why This Part?**
- **10kΩ nominal:** Standard value, easy to design voltage divider
- **High β-value (3380K):** Good sensitivity in 25-100°C range
- **±1% tolerance:** Accurate readings without individual calibration
- **Small thermal mass:** Fast response to temperature changes
- **Leaded package:** Easy to attach to heatsink with thermal paste

**Alternative Parts:**
- Vishay NTCLE100E3103JB0: Similar specs, slightly cheaper
- TDK B57891M0103K000: Higher power rating, slower response
- Generic 10kΩ NTC: Works but requires individual calibration

### 3.2 Bill of Materials

| Qty | Component | Part Number | Description | Unit Cost | Total |
|-----|---|---|---|---|---|
| 2 | NTC Thermistor | NCP15XH103F03RC | 10kΩ @ 25°C, β=3380K | $0.30 | $0.60 |
| 2 | Resistor | Generic 10kΩ 1% | 0805 SMD, voltage divider | $0.02 | $0.04 |
| 1 | Comparator IC | LM393DR (dual) | Dual comparator, SOT-8 | $0.25 | $0.25 |
| 4 | Resistor | Generic 10kΩ | Comparator hysteresis | $0.02 | $0.08 |
| 2 | Resistor | Generic 1kΩ | Comparator pull-up | $0.02 | $0.04 |
| 2 | Capacitor | Generic 100nF | Noise filtering, 0805 | $0.02 | $0.04 |
| 1 | Voltage Reference | TL431 | 2.5V reference (optional) | $0.15 | $0.15 |
| - | Thermal Paste | Arctic MX-4 | For thermistor mounting | - | $0.02 |
| **TOTAL** | | | | | **$1.22** |

**Where to Buy:**
- Mouser, Digikey, LCSC (for small quantities)
- Alibaba/Taobao (for production volumes >1000)

### 3.3 Hardware Circuit Design

#### 3.3.1 Voltage Divider for ADC

**Circuit per H-Bridge:**

```
                    ADC Input to SoC
                    (CH4 or CH5)
                         ↓
    +3.3V ───┬──────────┼───────────┐
             │          │           │
          [R1: 10kΩ]    │        [C1: 100nF]  ← Noise filter
             │          │           │
             ├──────────┘           │
             │                      │
        [NTC: 10kΩ]                GND
             │     ↑ Thermal paste
             │     │ On MOSFET heatsink
            GND
```

**Design Equations:**

```
V_adc = V_ref × (R_ntc / (R1 + R_ntc))

Where:
- V_ref = 3.3V (system voltage)
- R1 = 10kΩ (fixed resistor)
- R_ntc = Temperature-dependent resistance

At key temperatures:
┌──────────┬────────────┬─────────────┬────────────┐
│ Temp (°C)│ R_ntc (Ω)  │ V_adc (V)   │ ADC Counts │
├──────────┼────────────┼─────────────┼────────────┤
│   0      │   32,600   │   2.52      │   50,000   │
│  25      │   10,000   │   1.65      │   32,768   │
│  50      │    3,600   │   0.87      │   17,500   │
│  60      │    2,490   │   0.66      │   13,000   │
│  75      │    1,390   │   0.40      │    8,000   │
│ 100      │      606   │   0.19      │    3,700   │
│ 125      │      289   │   0.09      │    1,800   │
└──────────┴────────────┴─────────────┴────────────┘

Note: ADC counts assume 16-bit ADC with 3.3V reference
```

**Component Tolerances:**

- R1 tolerance: Use 1% resistor for accuracy
- NTC tolerance: 1% (specified by manufacturer)
- Combined error: ~±2% = ±1-2°C error

**Self-Heating Check:**

```
Power in NTC = V² / R
At 25°C: P = (1.65V)² / 10kΩ = 0.27 mW
Self-heating: 0.27mW × 1°C/mW = 0.27°C ← Negligible ✓
```

#### 3.3.2 Hardware Comparator Circuit (Optional but Recommended)

**Circuit per H-Bridge:**

```
                          +3.3V
                            │
                         [1kΩ] Pull-up
                            │
                            ├──→ fault_thermal_hX (to FPGA)
                            │
                         LM393
                         Comparator
                            │
    V_divider ──────→ (+)  │
                            │
    V_threshold ────→ (-)  │
                         [OUT]

    Threshold Generation (using voltage divider):

    +3.3V ───┬───────→ V_threshold (to comparator -)
             │
          [10kΩ]
             │
             ├─────── Adjustable (or fixed)
             │
          [10kΩ]
             │
            GND

    For 75°C threshold:
    - V_adc @ 75°C = 0.40V (from table above)
    - Set V_threshold = 0.40V using divider
    - When temp > 75°C: V_adc < 0.40V → Comparator output goes HIGH
```

**Hysteresis for Stability:**

```
Add positive feedback resistor:

             +3.3V
               │
            [100kΩ] ← Hysteresis resistor
               │
               ├──────→ To comparator (+)
               │
          [Comparator OUT]

Hysteresis amount: ~5°C
- Turns ON at 75°C
- Turns OFF at 70°C (prevents oscillation)
```

**Why Hardware Comparator?**
- **Independence:** Works even if CPU crashes or firmware hangs
- **Speed:** <10 µs response time (vs 100 µs for software)
- **Simplicity:** No software bugs can disable it
- **Redundancy:** Second layer of protection

**Cost vs Benefit:**
- Added cost: $0.25 (LM393) + $0.15 (resistors)
- Added complexity: Minimal (simple analog circuit)
- Safety improvement: Significant (independent protection layer)
- **Recommendation: Include for production systems**

### 3.4 Physical Mounting

#### 3.4.1 Thermistor Placement

**Option A: Direct Die Contact (Best Accuracy)**

```
                   [Thermistor]
                        ↓
                   Thermal Paste
    ┌─────────────────────────────────┐
    │    [MOSFET Die Inside Package]  │  ← Measure here
    └─────────────────────────────────┘
              [PCB Copper]
```

**Method:**
1. Clean MOSFET package surface with isopropyl alcohol
2. Apply thin layer of thermal paste (Arctic MX-4)
3. Press thermistor body onto package
4. Secure with Kapton tape or small zip tie
5. Ensure electrical insulation (Kapton tape between thermistor and PCB)

**Option B: Heatsink Mounting (Easier, Slightly Slower)**

```
         [Heatsink Fin]
              ↓
         [Thermistor] ← Drill 2.5mm hole for thermistor body
              ↓
         Thermal Paste
              ↓
    ┌─────────────────────┐
    │  [MOSFET Package]   │
    └─────────────────────┘
         [PCB]
```

**Method:**
1. Drill 2.5mm hole in heatsink near MOSFET mounting area
2. Insert thermistor body into hole
3. Apply thermal paste around thermistor
4. Secure with thermal epoxy or retaining clip
5. Response time: ~10 seconds (vs ~5 seconds for direct mounting)

#### 3.4.2 Wiring

**Twisted-Pair Cable:**
- Use 24-28 AWG wire (low current, voltage sensing only)
- Twist wires together to reduce EMI pickup
- Keep cable length <20 cm to minimize noise

**Routing Guidelines:**
- Route AWAY from switching nodes (gate drive signals)
- Run parallel to ground plane if possible
- Add 100nF capacitor at ADC input (already in circuit above)
- Use shielded cable if EMI issues persist (shield to ground)

**Connector:**
- JST-XH 2.54mm pitch connector (standard, cheap)
- Pin 1: +3.3V (red wire)
- Pin 2: Thermistor sense (white wire)
- Note: One pin of NTC is connected to GND directly on PCB

#### 3.4.3 Installation Photos (Reference)

```
Top View of H-Bridge PCB:
┌─────────────────────────────────────┐
│  [Q1]    [Q2]      [Q3]    [Q4]    │
│   │       │         │       │       │
│  [Thermistor A]   [Thermistor B]   │ ← One per H-bridge
│         ↓               ↓           │
│   H-Bridge 1      H-Bridge 2       │
└─────────────────────────────────────┘

Each thermistor placed between high-side and low-side MOSFETs
(hottest location during operation)
```

---

## 4. RTL Modifications

### 4.1 Overview

Three files need modification:

1. **adc_interface.v** - Expand from 4 to 6 channels
2. **protection.v** - Add 2 thermal fault bits
3. **Top-level SoC** - Wire thermal inputs

**Total Changes:**
- Lines added: ~40
- Lines modified: ~20
- New signals: 2 (fault_thermal_h1, fault_thermal_h2)

### 4.2 ADC Interface Modifications

**File:** `02-embedded/riscv/rtl/peripherals/adc_interface.v`

**Changes Required:**

```verilog
// ============================================================================
// CHANGE 1: Module documentation (add to header comment)
// ============================================================================
/**
 * Register Map (Base: 0x00020100):
 * 0x00: CTRL        - Control register (enable, start conversion)
 * 0x04: CLK_DIV     - SPI clock divider
 * 0x08: CH_SELECT   - Channel selection (0-5)  ← Changed from (0-3)
 * 0x0C: DATA_CH0    - Channel 0 ADC data
 * 0x10: DATA_CH1    - Channel 1 ADC data
 * 0x14: DATA_CH2    - Channel 2 ADC data
 * 0x18: DATA_CH3    - Channel 3 ADC data
 * 0x1C: DATA_CH4    - Channel 4 ADC data (THERMAL H1) ← NEW
 * 0x20: DATA_CH5    - Channel 5 ADC data (THERMAL H2) ← NEW
 * 0x24: STATUS      - Status register (busy, valid flags) ← Address changed
 */

// ============================================================================
// CHANGE 2: Control registers (around line 70)
// ============================================================================

// OLD:
//     reg [1:0]  channel_select;
//     reg [15:0] adc_data [0:3];
//     reg [3:0]  data_valid;

// NEW:
    reg [2:0]  channel_select;      // 3 bits for 0-5 channels
    reg [15:0] adc_data [0:5];      // 6 channels instead of 4
    reg [5:0]  data_valid;          // 6 valid flags

// ============================================================================
// CHANGE 3: Initialization block (around line 76)
// ============================================================================

// OLD:
//     initial begin
//         ...
//         channel_select = 2'd0;
//         adc_data[0] = 16'd0;
//         adc_data[1] = 16'd0;
//         adc_data[2] = 16'd0;
//         adc_data[3] = 16'd0;
//         data_valid = 4'h0;
//         ...
//     end

// NEW:
    initial begin
        enable = 1'b0;
        start = 1'b0;
        auto_mode = 1'b0;
        clk_div = DEFAULT_CLK_DIV;
        channel_select = 3'd0;          // 3-bit initialization
        adc_data[0] = 16'd0;
        adc_data[1] = 16'd0;
        adc_data[2] = 16'd0;
        adc_data[3] = 16'd0;
        adc_data[4] = 16'd0;            // NEW
        adc_data[5] = 16'd0;            // NEW
        data_valid = 6'h0;              // 6-bit initialization
        spi_sck = 1'b0;
        spi_mosi = 1'b0;
        spi_cs_n = 1'b1;
        irq = 1'b0;
    end

// ============================================================================
// CHANGE 4: Command byte generation (around line 140)
// ============================================================================

// OLD:
//     tx_shift_reg <= {1'b1, channel_select, 5'b00000};

// NEW:
    // Prepare command byte: 0b1CCCxxxx where CCC is 3-bit channel (0-5)
    // Bit allocation: [7]=start, [6:4]=channel, [3:0]=don't care
    tx_shift_reg <= {1'b1, 1'b0, channel_select, 3'b000};

// ============================================================================
// CHANGE 5: Wishbone write logic (around line 254)
// ============================================================================

// OLD:
//     6'h02: channel_select <= wb_dat_i[1:0];

// NEW:
    6'h02: channel_select <= wb_dat_i[2:0];  // 3-bit channel select

// ============================================================================
// CHANGE 6: Wishbone read logic (around line 259)
// ============================================================================

// OLD:
//     case (wb_addr[7:2])
//         6'h00: wb_dat_o <= {29'd0, auto_mode, start, enable};
//         6'h01: wb_dat_o <= {24'd0, clk_div};
//         6'h02: wb_dat_o <= {30'd0, channel_select};
//         6'h03: wb_dat_o <= {16'd0, adc_data[0]};
//         6'h04: wb_dat_o <= {16'd0, adc_data[1]};
//         6'h05: wb_dat_o <= {16'd0, adc_data[2]};
//         6'h06: wb_dat_o <= {16'd0, adc_data[3]};
//         6'h07: wb_dat_o <= {24'd0, data_valid, 3'd0, spi_busy};
//         default: wb_dat_o <= 32'h0;
//     endcase

// NEW:
    case (wb_addr[7:2])
        6'h00: wb_dat_o <= {29'd0, auto_mode, start, enable};  // CTRL
        6'h01: wb_dat_o <= {24'd0, clk_div};                   // CLK_DIV
        6'h02: wb_dat_o <= {29'd0, channel_select};            // CH_SELECT (3-bit)
        6'h03: wb_dat_o <= {16'd0, adc_data[0]};               // DATA_CH0
        6'h04: wb_dat_o <= {16'd0, adc_data[1]};               // DATA_CH1
        6'h05: wb_dat_o <= {16'd0, adc_data[2]};               // DATA_CH2
        6'h06: wb_dat_o <= {16'd0, adc_data[3]};               // DATA_CH3
        6'h07: wb_dat_o <= {16'd0, adc_data[4]};               // DATA_CH4 (NEW)
        6'h08: wb_dat_o <= {16'd0, adc_data[5]};               // DATA_CH5 (NEW)
        6'h09: wb_dat_o <= {26'd0, data_valid, 2'd0, spi_busy}; // STATUS
        default: wb_dat_o <= 32'h0;
    endcase
```

**Summary of Changes:**
- `channel_select`: 2-bit → 3-bit
- `adc_data` array: 4 elements → 6 elements
- `data_valid`: 4-bit → 6-bit
- Register map: Added 0x1C (CH4) and 0x20 (CH5)
- STATUS register moved from 0x1C to 0x24

### 4.3 Protection Module Modifications

**File:** `02-embedded/riscv/rtl/peripherals/protection.v`

**Changes Required:**

```verilog
// ============================================================================
// CHANGE 1: Module documentation (update header comment)
// ============================================================================
/**
 * FAULT_STATUS bits:
 * [0]: OCP (overcurrent protection)
 * [1]: OVP (overvoltage protection)
 * [2]: E-STOP
 * [3]: Watchdog timeout
 * [4]: Thermal H-bridge 1  ← NEW
 * [5]: Thermal H-bridge 2  ← NEW
 * [31:6]: Reserved         ← Updated
 */

// ============================================================================
// CHANGE 2: Module ports (add thermal inputs)
// ============================================================================

module protection #(
    parameter ADDR_WIDTH = 8,
    parameter WATCHDOG_DEFAULT = 50_000_000
)(
    // ... existing ports ...

    // External fault inputs (active HIGH)
    input  wire                    fault_ocp,
    input  wire                    fault_ovp,
    input  wire                    estop_n,
    input  wire                    fault_thermal_h1,    // NEW
    input  wire                    fault_thermal_h2,    // NEW

    // ... rest of ports ...
);

// ============================================================================
// CHANGE 3: Fault bit definitions (around line 61)
// ============================================================================

// OLD:
//     localparam FAULT_OCP       = 0;
//     localparam FAULT_OVP       = 1;
//     localparam FAULT_ESTOP     = 2;
//     localparam FAULT_WATCHDOG  = 3;

// NEW:
    localparam FAULT_OCP        = 0;
    localparam FAULT_OVP        = 1;
    localparam FAULT_ESTOP      = 2;
    localparam FAULT_WATCHDOG   = 3;
    localparam FAULT_THERMAL_H1 = 4;  // NEW
    localparam FAULT_THERMAL_H2 = 5;  // NEW

// ============================================================================
// CHANGE 4: Register declarations (around line 70)
// ============================================================================

// OLD:
//     reg [3:0]  fault_enable;
//     reg [3:0]  fault_status;
//     reg [3:0]  fault_latch;

// NEW:
    reg [5:0]  fault_enable;        // Expanded to 6 bits
    reg [5:0]  fault_status;        // Expanded to 6 bits
    reg [5:0]  fault_latch;         // Expanded to 6 bits

// ============================================================================
// CHANGE 5: Initialization (around line 78)
// ============================================================================

// OLD:
//     initial begin
//         fault_enable = 4'hF;
//         fault_status = 4'h0;
//         fault_latch = 4'h0;
//         ...
//     end

// NEW:
    initial begin
        fault_enable = 6'h3F;  // All 6 faults enabled (0b111111)
        fault_status = 6'h0;
        fault_latch = 6'h0;
        watchdog_timeout = WATCHDOG_DEFAULT;
        watchdog_counter = 0;
        watchdog_expired = 1'b0;
        irq = 1'b0;
    end

// ============================================================================
// CHANGE 6: Fault detection logic (around line 93)
// ============================================================================

// OLD:
//     always @(posedge clk or negedge rst_n) begin
//         if (!rst_n) begin
//             fault_status <= 4'h0;
//         end else begin
//             fault_status[FAULT_OCP]      <= fault_ocp && fault_enable[FAULT_OCP];
//             fault_status[FAULT_OVP]      <= fault_ovp && fault_enable[FAULT_OVP];
//             fault_status[FAULT_ESTOP]    <= !estop_n && fault_enable[FAULT_ESTOP];
//             fault_status[FAULT_WATCHDOG] <= watchdog_expired && fault_enable[FAULT_WATCHDOG];
//         end
//     end

// NEW:
    always @(posedge clk or negedge rst_n) begin
        if (!rst_n) begin
            fault_status <= 6'h0;  // 6-bit reset
        end else begin
            fault_status[FAULT_OCP]        <= fault_ocp && fault_enable[FAULT_OCP];
            fault_status[FAULT_OVP]        <= fault_ovp && fault_enable[FAULT_OVP];
            fault_status[FAULT_ESTOP]      <= !estop_n && fault_enable[FAULT_ESTOP];
            fault_status[FAULT_WATCHDOG]   <= watchdog_expired && fault_enable[FAULT_WATCHDOG];
            fault_status[FAULT_THERMAL_H1] <= fault_thermal_h1 && fault_enable[FAULT_THERMAL_H1];  // NEW
            fault_status[FAULT_THERMAL_H2] <= fault_thermal_h2 && fault_enable[FAULT_THERMAL_H2];  // NEW
        end
    end

// ============================================================================
// CHANGE 7: Fault latching (around line 105)
// ============================================================================

// OLD:
//     always @(posedge clk or negedge rst_n) begin
//         if (!rst_n) begin
//             fault_latch <= 4'h0;
//         end else begin
//             if (fault_status[FAULT_OCP])      fault_latch[FAULT_OCP] <= 1'b1;
//             if (fault_status[FAULT_OVP])      fault_latch[FAULT_OVP] <= 1'b1;
//             if (fault_status[FAULT_ESTOP])    fault_latch[FAULT_ESTOP] <= 1'b1;
//             if (fault_status[FAULT_WATCHDOG]) fault_latch[FAULT_WATCHDOG] <= 1'b1;
//         end
//     end

// NEW:
    always @(posedge clk or negedge rst_n) begin
        if (!rst_n) begin
            fault_latch <= 6'h0;  // 6-bit reset
        end else begin
            if (fault_status[FAULT_OCP])        fault_latch[FAULT_OCP] <= 1'b1;
            if (fault_status[FAULT_OVP])        fault_latch[FAULT_OVP] <= 1'b1;
            if (fault_status[FAULT_ESTOP])      fault_latch[FAULT_ESTOP] <= 1'b1;
            if (fault_status[FAULT_WATCHDOG])   fault_latch[FAULT_WATCHDOG] <= 1'b1;
            if (fault_status[FAULT_THERMAL_H1]) fault_latch[FAULT_THERMAL_H1] <= 1'b1;  // NEW
            if (fault_status[FAULT_THERMAL_H2]) fault_latch[FAULT_THERMAL_H2] <= 1'b1;  // NEW
        end
    end

// ============================================================================
// CHANGE 8: Wishbone interface (around line 152)
// ============================================================================

// OLD:
//     always @(posedge clk or negedge rst_n) begin
//         if (!rst_n) begin
//             fault_enable <= 4'hF;
//             ...
//         end else begin
//             ...
//             if (wb_stb && wb_we && !wb_ack) begin
//                 case (wb_addr[7:2])
//                     6'h01: fault_enable <= wb_dat_i[3:0];
//                     6'h02: fault_latch <= fault_latch & ~wb_dat_i[3:0];
//                     ...
//                 endcase
//             end else if (wb_stb && !wb_we && !wb_ack) begin
//                 case (wb_addr[7:2])
//                     6'h00: wb_dat_o <= {28'd0, fault_status};
//                     6'h01: wb_dat_o <= {28'd0, fault_enable};
//                     6'h05: wb_dat_o <= {28'd0, fault_latch};
//                     ...
//                 endcase
//             end
//         end
//     end

// NEW:
    always @(posedge clk or negedge rst_n) begin
        if (!rst_n) begin
            fault_enable <= 6'h3F;  // 6-bit initialization
            watchdog_timeout <= WATCHDOG_DEFAULT;
            wb_ack <= 1'b0;
            wb_dat_o <= 32'd0;
        end else begin
            wb_ack <= wb_stb && !wb_ack;

            if (wb_stb && wb_we && !wb_ack) begin
                // Write
                case (wb_addr[7:2])
                    6'h01: fault_enable <= wb_dat_i[5:0];                    // 6-bit write
                    6'h02: fault_latch <= fault_latch & ~wb_dat_i[5:0];     // 6-bit clear
                    6'h03: watchdog_timeout <= wb_dat_i;
                    6'h04: begin
                        watchdog_counter <= 0;
                        watchdog_expired <= 1'b0;
                    end
                endcase
            end else if (wb_stb && !wb_we && !wb_ack) begin
                // Read
                case (wb_addr[7:2])
                    6'h00: wb_dat_o <= {26'd0, fault_status};      // 6-bit read
                    6'h01: wb_dat_o <= {26'd0, fault_enable};      // 6-bit read
                    6'h03: wb_dat_o <= watchdog_timeout;
                    6'h05: wb_dat_o <= {26'd0, fault_latch};       // 6-bit read
                    default: wb_dat_o <= 32'h0;
                endcase
            end
        end
    end
```

**Summary of Changes:**
- Added 2 thermal fault input ports
- Added 2 thermal fault bit definitions (4 and 5)
- Expanded fault registers from 4-bit to 6-bit
- Updated initialization to 6'h3F (all 6 faults enabled)
- Added thermal fault detection and latching
- Updated Wishbone read data width from 28'd0 to 26'd0

### 4.4 Top-Level SoC Integration

**File:** `02-embedded/riscv/rtl/soc_top.v` (or similar)

**Changes Required:**

```verilog
// ============================================================================
// CHANGE 1: Add thermal fault inputs to module ports
// ============================================================================

module soc_top (
    input  wire        clk,
    input  wire        rst_n,

    // ... existing ports ...

    // Protection inputs
    input  wire        fault_ocp,
    input  wire        fault_ovp,
    input  wire        estop_n,
    input  wire        fault_thermal_h1,    // NEW
    input  wire        fault_thermal_h2,    // NEW

    // ... rest of ports ...
);

// ============================================================================
// CHANGE 2: Connect thermal inputs to protection module instance
// ============================================================================

// OLD:
//     protection u_protection (
//         .clk(clk),
//         .rst_n(rst_n),
//         .wb_addr(wb_addr_prot),
//         .wb_dat_i(wb_dat_i),
//         .wb_dat_o(wb_dat_o_prot),
//         .wb_we(wb_we),
//         .wb_sel(wb_sel),
//         .wb_stb(wb_stb_prot),
//         .wb_ack(wb_ack_prot),
//         .fault_ocp(fault_ocp),
//         .fault_ovp(fault_ovp),
//         .estop_n(estop_n),
//         .pwm_disable(pwm_disable),
//         .irq(irq_protection)
//     );

// NEW:
    protection u_protection (
        .clk(clk),
        .rst_n(rst_n),
        .wb_addr(wb_addr_prot),
        .wb_dat_i(wb_dat_i),
        .wb_dat_o(wb_dat_o_prot),
        .wb_we(wb_we),
        .wb_sel(wb_sel),
        .wb_stb(wb_stb_prot),
        .wb_ack(wb_ack_prot),
        .fault_ocp(fault_ocp),
        .fault_ovp(fault_ovp),
        .estop_n(estop_n),
        .fault_thermal_h1(fault_thermal_h1),    // NEW
        .fault_thermal_h2(fault_thermal_h2),    // NEW
        .pwm_disable(pwm_disable),
        .irq(irq_protection)
    );
```

**Pin Assignment Considerations:**
- Route thermal fault inputs to dedicated FPGA pins
- Use pins close to ADC interface pins if possible (shared I/O bank)
- Ensure pins have pull-down capability (faults should be active-high)
- Consider using differential inputs if long cable runs (>50cm)

### 4.5 Verification Checklist

After making RTL changes, verify:

- [ ] Syntax check passes: `iverilog -t null -Wall adc_interface.v`
- [ ] Protection module compiles: `iverilog -t null -Wall protection.v`
- [ ] Top-level instantiation correct (port widths match)
- [ ] Register map documented in header comments
- [ ] Simulation testbench updated (if exists)
- [ ] Lint check passes: `verilator --lint-only soc_top.v`

---

## 5. Firmware Implementation

### 5.1 File Structure

Create the following new files:

```
02-embedded/riscv/firmware/
├── thermal_monitor.h       ← Header file (new)
├── thermal_monitor.c       ← Implementation (new)
└── main.c                  ← Modify to integrate thermal monitoring
```

### 5.2 Header File

**File:** `02-embedded/riscv/firmware/thermal_monitor.h`

```c
/**
 * @file thermal_monitor.h
 * @brief MOSFET thermal monitoring interface
 *
 * Provides temperature sensing for H-bridge MOSFETs using NTC thermistors.
 * Implements both hardware-triggered faults (via comparator) and software
 * monitoring with precise temperature calculation.
 */

#ifndef THERMAL_MONITOR_H
#define THERMAL_MONITOR_H

#include <stdint.h>

//=============================================================================
// Configuration Constants
//=============================================================================

// NTC Thermistor Parameters (Murata NCP15XH103F03RC)
#define THERMAL_NTC_BETA        3380.0f     ///< β-parameter (K)
#define THERMAL_NTC_R25         10000.0f    ///< Resistance @ 25°C (Ω)
#define THERMAL_T25_KELVIN      298.15f     ///< 25°C in Kelvin
#define THERMAL_SERIES_R        10000.0f    ///< Fixed resistor (Ω)

// ADC Configuration
#define THERMAL_ADC_VREF        3.3f        ///< ADC reference voltage (V)
#define THERMAL_ADC_RESOLUTION  65535.0f    ///< 16-bit ADC full scale

// ADC Channel Assignments
#define THERMAL_ADC_CH_H1       4           ///< H-bridge 1 temperature
#define THERMAL_ADC_CH_H2       5           ///< H-bridge 2 temperature

// Temperature Thresholds (°C)
#define THERMAL_TEMP_WARNING    60.0f       ///< Warning level
#define THERMAL_TEMP_CRITICAL   75.0f       ///< Critical (shutdown)
#define THERMAL_TEMP_MAX        85.0f       ///< Absolute maximum
#define THERMAL_TEMP_HYSTERESIS 5.0f        ///< Hysteresis for fault clearing

// Error Codes
#define THERMAL_ERROR_OPEN      150.0f      ///< Thermistor open/disconnected
#define THERMAL_ERROR_SHORT     -40.0f      ///< Thermistor shorted

//=============================================================================
// Data Structures
//=============================================================================

/**
 * @brief Thermal status for one H-bridge
 */
typedef struct {
    float    temperature_c;      ///< Current temperature (°C)
    uint16_t adc_raw;            ///< Raw ADC reading
    uint8_t  warning_active;     ///< 1 if temp > WARNING threshold
    uint8_t  critical_active;    ///< 1 if temp > CRITICAL threshold
    uint8_t  fault_latched;      ///< 1 if fault has been latched
    uint32_t fault_timestamp;    ///< Time when fault occurred (ms)
} thermal_status_t;

/**
 * @brief Overall thermal monitoring state
 */
typedef struct {
    thermal_status_t h1;         ///< H-bridge 1 status
    thermal_status_t h2;         ///< H-bridge 2 status
    uint8_t          system_fault; ///< 1 if any critical fault
} thermal_monitor_t;

//=============================================================================
// Function Prototypes
//=============================================================================

/**
 * @brief Initialize thermal monitoring system
 *
 * Sets up ADC channels for temperature sensing and initializes thresholds.
 * Must be called once at system startup before thermal_monitor_update().
 */
void thermal_init(void);

/**
 * @brief Update thermal monitoring (call from ISR)
 *
 * Reads ADC channels, calculates temperatures, and checks thresholds.
 * Should be called every control cycle (10 kHz).
 *
 * @param monitor Pointer to thermal monitor state structure
 * @return 1 if critical fault detected, 0 otherwise
 */
int thermal_update(thermal_monitor_t *monitor);

/**
 * @brief Convert ADC reading to temperature
 *
 * Uses Steinhart-Hart equation to convert voltage divider reading
 * to temperature in degrees Celsius.
 *
 * @param adc_raw 16-bit ADC value
 * @return Temperature in °C (or error code if out of range)
 */
float thermal_adc_to_celsius(uint16_t adc_raw);

/**
 * @brief Clear latched thermal faults
 *
 * Clears both software and hardware fault latches. Use after
 * fault condition has been resolved and user acknowledges.
 */
void thermal_clear_faults(void);

/**
 * @brief Get thermal status string (for debugging)
 *
 * @param monitor Pointer to thermal monitor state
 * @param buffer Output buffer (min 128 bytes)
 */
void thermal_get_status_string(thermal_monitor_t *monitor, char *buffer);

#endif // THERMAL_MONITOR_H
```

### 5.3 Implementation File

**File:** `02-embedded/riscv/firmware/thermal_monitor.c`

```c
/**
 * @file thermal_monitor.c
 * @brief MOSFET thermal monitoring implementation
 */

#include "thermal_monitor.h"
#include "adc_interface.h"
#include "protection.h"
#include "uart.h"
#include <math.h>
#include <stdio.h>

//=============================================================================
// Private Variables
//=============================================================================

static thermal_monitor_t g_thermal_state;

//=============================================================================
// Public Functions
//=============================================================================

void thermal_init(void) {
    // Initialize state structure
    g_thermal_state.h1.temperature_c = 25.0f;
    g_thermal_state.h1.adc_raw = 0;
    g_thermal_state.h1.warning_active = 0;
    g_thermal_state.h1.critical_active = 0;
    g_thermal_state.h1.fault_latched = 0;
    g_thermal_state.h1.fault_timestamp = 0;

    g_thermal_state.h2.temperature_c = 25.0f;
    g_thermal_state.h2.adc_raw = 0;
    g_thermal_state.h2.warning_active = 0;
    g_thermal_state.h2.critical_active = 0;
    g_thermal_state.h2.fault_latched = 0;
    g_thermal_state.h2.fault_timestamp = 0;

    g_thermal_state.system_fault = 0;

    // ADC initialization is done in adc_interface.c
    // Just verify channels 4 and 5 are configured

    uart_puts("Thermal monitoring initialized\r\n");
}

float thermal_adc_to_celsius(uint16_t adc_raw) {
    // Step 1: ADC counts → Voltage
    float v_adc = ((float)adc_raw / THERMAL_ADC_RESOLUTION) * THERMAL_ADC_VREF;

    // Step 2: Voltage divider → NTC resistance
    // Circuit: +Vref --[R_series]-- V_adc --[NTC]-- GND
    // V_adc = V_ref × (R_ntc / (R_series + R_ntc))
    // Solving for R_ntc:
    // R_ntc = (V_adc × R_series) / (V_ref - V_adc)

    // Check for sensor faults
    if (v_adc >= THERMAL_ADC_VREF * 0.99f) {
        // V_adc ≈ V_ref means NTC has very high resistance
        // Either disconnected or temperature < -40°C
        return THERMAL_ERROR_OPEN;
    }

    if (v_adc <= 0.01f) {
        // V_adc ≈ 0V means NTC has very low resistance
        // Either shorted or temperature > 150°C (unlikely)
        return THERMAL_ERROR_SHORT;
    }

    float r_ntc = (v_adc * THERMAL_SERIES_R) / (THERMAL_ADC_VREF - v_adc);

    // Step 3: Apply Steinhart-Hart equation (simplified β-parameter form)
    // 1/T = 1/T₀ + (1/β) × ln(R/R₀)
    // Where:
    //   T = Temperature in Kelvin
    //   T₀ = Reference temperature (25°C = 298.15K)
    //   R = Current NTC resistance
    //   R₀ = NTC resistance at T₀ (10kΩ)
    //   β = Beta parameter (3380K)

    float ln_ratio = logf(r_ntc / THERMAL_NTC_R25);
    float inv_temp = (1.0f / THERMAL_T25_KELVIN) + (ln_ratio / THERMAL_NTC_BETA);
    float temp_kelvin = 1.0f / inv_temp;
    float temp_celsius = temp_kelvin - 273.15f;

    return temp_celsius;
}

/**
 * @brief Check thresholds for one H-bridge
 */
static int thermal_check_thresholds(thermal_status_t *status, float temp, uint32_t timestamp) {
    int fault_occurred = 0;

    // Critical temperature check (with hysteresis)
    if (temp > THERMAL_TEMP_CRITICAL) {
        if (!status->critical_active) {
            // Fault just occurred
            status->critical_active = 1;
            status->fault_latched = 1;
            status->fault_timestamp = timestamp;
            fault_occurred = 1;
        }
    } else if (temp < (THERMAL_TEMP_CRITICAL - THERMAL_TEMP_HYSTERESIS)) {
        // Temperature dropped below threshold (with hysteresis)
        status->critical_active = 0;
    }

    // Warning temperature check
    if (temp > THERMAL_TEMP_WARNING) {
        status->warning_active = 1;
    } else if (temp < (THERMAL_TEMP_WARNING - THERMAL_TEMP_HYSTERESIS)) {
        status->warning_active = 0;
    }

    return fault_occurred;
}

int thermal_update(thermal_monitor_t *monitor) {
    // Read ADC channels
    uint16_t adc_h1 = adc_read_channel(THERMAL_ADC_CH_H1);
    uint16_t adc_h2 = adc_read_channel(THERMAL_ADC_CH_H2);

    // Store raw ADC values
    monitor->h1.adc_raw = adc_h1;
    monitor->h2.adc_raw = adc_h2;

    // Convert to temperature
    float temp_h1 = thermal_adc_to_celsius(adc_h1);
    float temp_h2 = thermal_adc_to_celsius(adc_h2);

    monitor->h1.temperature_c = temp_h1;
    monitor->h2.temperature_c = temp_h2;

    // Get current timestamp (implement get_time_ms() in your system)
    extern uint32_t get_time_ms(void);
    uint32_t timestamp = get_time_ms();

    // Check thresholds
    int fault_h1 = thermal_check_thresholds(&monitor->h1, temp_h1, timestamp);
    int fault_h2 = thermal_check_thresholds(&monitor->h2, temp_h2, timestamp);

    // Update system fault flag
    monitor->system_fault = monitor->h1.critical_active || monitor->h2.critical_active;

    // Log new faults
    if (fault_h1) {
        char msg[64];
        sprintf(msg, "THERMAL FAULT H1: %.1f°C\r\n", temp_h1);
        uart_puts(msg);
    }

    if (fault_h2) {
        char msg[64];
        sprintf(msg, "THERMAL FAULT H2: %.1f°C\r\n", temp_h2);
        uart_puts(msg);
    }

    // Return 1 if any critical fault active
    return monitor->system_fault;
}

void thermal_clear_faults(void) {
    // Clear software fault latches
    g_thermal_state.h1.fault_latched = 0;
    g_thermal_state.h2.fault_latched = 0;
    g_thermal_state.system_fault = 0;

    // Clear hardware fault latches in protection module
    // Read-modify-write to FAULT_CLEAR register (0x00020208)
    volatile uint32_t *fault_clear_reg = (uint32_t *)0x00020208;
    *fault_clear_reg = (1 << 4) | (1 << 5);  // Clear thermal fault bits

    uart_puts("Thermal faults cleared\r\n");
}

void thermal_get_status_string(thermal_monitor_t *monitor, char *buffer) {
    sprintf(buffer,
        "Thermal Status:\r\n"
        "  H1: %.1f°C (ADC: %u) %s%s\r\n"
        "  H2: %.1f°C (ADC: %u) %s%s\r\n",
        monitor->h1.temperature_c,
        monitor->h1.adc_raw,
        monitor->h1.warning_active ? "[WARN]" : "",
        monitor->h1.critical_active ? "[CRIT]" : "",
        monitor->h2.temperature_c,
        monitor->h2.adc_raw,
        monitor->h2.warning_active ? "[WARN]" : "",
        monitor->h2.critical_active ? "[CRIT]" : ""
    );
}

//=============================================================================
// Lookup Table Alternative (for MCUs without FPU)
//=============================================================================

#ifdef USE_LOOKUP_TABLE

// Pre-calculated temperature lookup table (faster, no floating-point math)
// Index: ADC value / 256 (8-bit lookup)
// Value: Temperature in tenths of degrees (e.g., 250 = 25.0°C)
static const int16_t thermal_lut[256] = {
    -400, -350, -300, -250, -200, -150, -100,  -50,    0,   50,
     100,  150,  200,  250,  300,  350,  400,  450,  500,  550,
     600,  650,  700,  750,  800,  850,  900,  950, 1000, 1050,
    // ... (full table would have 256 entries)
    // Generate using: temp = thermal_adc_to_celsius(adc * 256)
};

float thermal_adc_to_celsius_lut(uint16_t adc_raw) {
    uint8_t index = adc_raw >> 8;  // Divide by 256
    return (float)thermal_lut[index] / 10.0f;
}

#endif // USE_LOOKUP_TABLE
```

### 5.4 Integration with Control Loop

**File:** `02-embedded/riscv/firmware/main.c`

Modify your existing ISR to include thermal monitoring:

```c
#include "thermal_monitor.h"

// Global thermal state
static thermal_monitor_t g_thermal;

/**
 * @brief Main initialization
 */
int main(void) {
    // ... existing initialization ...

    // Initialize thermal monitoring
    thermal_init();

    // ... rest of initialization ...

    while (1) {
        // Main loop

        // Optional: Print thermal status every second
        static uint32_t last_print = 0;
        uint32_t now = get_time_ms();
        if (now - last_print > 1000) {
            char status[128];
            thermal_get_status_string(&g_thermal, status);
            uart_puts(status);
            last_print = now;
        }
    }
}

/**
 * @brief 10 kHz control loop ISR
 *
 * Timing budget: 50 µs @ 50 MHz = 2500 cycles
 */
void pwm_isr(void) __attribute__((interrupt));

void pwm_isr(void) {
    // 1. Read ADC (4 channels: current, voltage)
    //    Time: ~0.4 µs (20 cycles)
    uint16_t adc_i1 = adc_read_channel(0);
    uint16_t adc_i2 = adc_read_channel(1);
    uint16_t adc_v_out = adc_read_channel(2);
    uint16_t adc_v_dc = adc_read_channel(3);

    // 2. Convert to engineering units
    //    Time: ~4 µs (200 cycles)
    float i1 = adc_to_current(adc_i1);
    float i2 = adc_to_current(adc_i2);
    float v_out = adc_to_voltage(adc_v_out);
    float v_dc = adc_to_dc_voltage(adc_v_dc);

    // 3. Digital filtering
    //    Time: ~8 µs (400 cycles)
    i1 = lowpass_filter(&lpf_i1, i1);
    i2 = lowpass_filter(&lpf_i2, i2);

    // 4. Safety checks
    //    Time: ~3 µs (150 cycles)
    if (fabs(i1) > MAX_CURRENT || fabs(i2) > MAX_CURRENT) {
        pwm_disable_all();
        return;
    }

    // 5. **NEW: Thermal monitoring**
    //    Time: ~5 µs (250 cycles) - includes ADC read + conversion
    int thermal_fault = thermal_update(&g_thermal);
    if (thermal_fault) {
        // Critical thermal fault - shutdown immediately
        pwm_disable_all();
        uart_puts("THERMAL SHUTDOWN\r\n");
        return;
    }

    // Optional: Reduce power if warning level reached
    float power_derating = 1.0f;
    if (g_thermal.h1.warning_active || g_thermal.h2.warning_active) {
        // Reduce to 80% power to cool down
        power_derating = 0.8f;
    }

    // 6. Generate reference
    //    Time: ~4 µs (200 cycles)
    float ref = generate_sine_reference(frequency, time);
    ref *= power_derating;  // Apply derating if needed

    // 7. PR controller
    //    Time: ~12 µs (600 cycles)
    float control_output = pr_controller(&pr, ref, i1 + i2);

    // 8. 5-level modulation
    //    Time: ~8 µs (400 cycles)
    five_level_modulator(control_output, duty_cycles);

    // 9. Update PWM
    //    Time: ~0.6 µs (30 cycles)
    pwm_update_duty_cycles(duty_cycles);

    // 10. Logging
    //     Time: ~2 µs (100 cycles)
    log_data(i1, v_out, g_thermal.h1.temperature_c);

    // TOTAL: ~47 µs (within 50 µs budget) ✓
}
```

**Timing Analysis with Thermal Monitoring:**

```
Component               | Cycles | Time @ 50MHz | Cumulative
------------------------|--------|--------------|------------
ADC read (4 ch)         |     20 |      0.4 µs |      0.4 µs
Engineering units       |    200 |      4.0 µs |      4.4 µs
Digital filtering       |    400 |      8.0 µs |     12.4 µs
Safety checks           |    150 |      3.0 µs |     15.4 µs
THERMAL MONITORING NEW  |    250 |      5.0 µs |     20.4 µs  ← Added
Generate reference      |    200 |      4.0 µs |     24.4 µs
PR controller           |    600 |     12.0 µs |     36.4 µs
5-level modulation      |    400 |      8.0 µs |     44.4 µs
Update PWM              |     30 |      0.6 µs |     45.0 µs
Logging                 |    100 |      2.0 µs |     47.0 µs
------------------------|--------|--------------|------------
TOTAL                   |  2,350 |     47.0 µs |  (94% of budget)
```

**Verdict:** Thermal monitoring adds 5 µs to ISR, still within 50 µs budget ✅

---

## 6. Integration and Testing

### 6.1 Build System Updates

**File:** `02-embedded/riscv/firmware/Makefile`

Add thermal_monitor.c to source list:

```makefile
# Source files
SRCS = main.c \
       startup.s \
       adc_interface.c \
       pwm_control.c \
       protection.c \
       uart.c \
       thermal_monitor.c

# ... rest of Makefile ...
```

### 6.2 Simulation Testing

Before hardware testing, verify in simulation:

**File:** `02-embedded/riscv/testbench/tb_thermal.v`

```verilog
`timescale 1ns/1ps

module tb_thermal;
    reg clk;
    reg rst_n;

    // Thermal fault signals
    reg fault_thermal_h1;
    reg fault_thermal_h2;

    // Instantiate protection module
    wire pwm_disable;
    wire irq;

    protection #(
        .WATCHDOG_DEFAULT(1000)
    ) dut (
        .clk(clk),
        .rst_n(rst_n),
        .fault_thermal_h1(fault_thermal_h1),
        .fault_thermal_h2(fault_thermal_h2),
        .pwm_disable(pwm_disable),
        .irq(irq),
        // ... other ports ...
    );

    // Clock generation
    initial clk = 0;
    always #10 clk = ~clk;  // 50 MHz

    // Test sequence
    initial begin
        $dumpfile("thermal_test.vcd");
        $dumpvars(0, tb_thermal);

        // Reset
        rst_n = 0;
        fault_thermal_h1 = 0;
        fault_thermal_h2 = 0;
        #100;
        rst_n = 1;
        #100;

        // Test 1: No fault
        $display("Test 1: Normal operation");
        #1000;
        assert(pwm_disable == 0) else $error("PWM should be enabled");

        // Test 2: H1 thermal fault
        $display("Test 2: H1 thermal fault");
        fault_thermal_h1 = 1;
        #20;
        assert(pwm_disable == 1) else $error("PWM should be disabled");
        assert(irq == 1) else $error("IRQ should be raised");
        #100;
        fault_thermal_h1 = 0;
        #20;
        assert(pwm_disable == 1) else $error("Fault should be latched");

        // Test 3: Clear fault
        $display("Test 3: Clear fault");
        // Write to FAULT_CLEAR register (simulate via bus write)
        // ... (implement Wishbone write transaction) ...

        $display("All tests passed!");
        $finish;
    end
endmodule
```

Run simulation:
```bash
cd 02-embedded/riscv/testbench
iverilog -o thermal_test tb_thermal.v ../rtl/peripherals/protection.v
vvp thermal_test
gtkwave thermal_test.vcd
```

### 6.3 Bench Testing Without Power

**Test 1: Room Temperature Reading**

1. Power up FPGA/SoC
2. Connect thermistor circuits (at room temp ~25°C)
3. Run firmware
4. Check UART output:

```
Expected output:
Thermal Status:
  H1: 24.8°C (ADC: 32500)
  H2: 25.2°C (ADC: 32900)
```

**Troubleshooting:**
- If temp shows 150°C: Thermistor disconnected (check solder joints)
- If temp shows -40°C: Thermistor shorted (check for solder bridges)
- If temp wildly fluctuates: Add 100nF capacitor at ADC input

**Test 2: Manual Heating**

1. Use soldering iron or heat gun
2. Carefully warm thermistor (don't exceed 100°C!)
3. Watch temperature reading increase
4. Verify fault triggers at 75°C

```
Expected UART output:
Thermal Status:
  H1: 45.2°C (ADC: 22000)
...
Thermal Status:
  H1: 74.8°C (ADC: 8100)
...
THERMAL FAULT H1: 75.3°C
PWM DISABLED
```

### 6.4 Hardware-in-Loop Testing

**Test Setup:**

```
                     [Oscilloscope]
                          ↓
    [FPGA] ──PWM──→ [Gate Driver] ──→ [H-Bridge with NTC]
      ↑                                       ↓
      └────── ADC/Comparator ────────────────┘
```

**Test Procedure:**

1. **Initial Power-Up (5V DC, No Load)**
   - Start with reduced voltage (5V instead of 50V)
   - Enable PWM at 50% duty cycle
   - Monitor temperatures for 1 minute
   - Expected: <30°C rise (minimal power dissipation)

2. **Moderate Power (12V DC, Resistive Load)**
   - Increase to 12V DC input
   - Add resistive load (10Ω, 50W)
   - Run for 5 minutes
   - Expected: 30-50°C rise depending on heatsink

3. **Thermal Fault Injection**
   - Remove heatsink from one H-bridge
   - Enable PWM with moderate load
   - Watch temperature rise
   - Expected: Fault should trigger within 60 seconds

4. **Fault Response Time Measurement**
   - Use oscilloscope to measure time from comparator trip to PWM disable
   - Channel 1: Comparator output
   - Channel 2: PWM output
   - Expected: <10 µs response time

**Acceptance Criteria:**

- [ ] Room temperature reading accurate to ±2°C
- [ ] Temperature increases with load (sanity check)
- [ ] Hardware comparator triggers at 75°C ±3°C
- [ ] Software fault triggers at 75°C ±1°C
- [ ] PWM disables within 10 µs of comparator trip
- [ ] Fault latches until cleared by firmware
- [ ] No false triggers during normal operation (1 hour soak test)

---

## 7. Calibration Procedures

### 7.1 Why Calibration?

Even with 1% tolerance components, real-world accuracy is affected by:
- PCB trace resistance
- ADC non-linearity
- Self-heating effects
- Thermistor tolerance stackup

**Calibration improves accuracy from ±3°C to ±0.5°C.**

### 7.2 Two-Point Calibration Method

**Equipment Needed:**
- Precision thermometer (±0.1°C accuracy)
- Controlled temperature chamber OR ice water + boiling water
- UART terminal for reading ADC values

**Procedure:**

**Point 1: Ice Water (0°C)**
1. Fill container with ice water (let sit 5 min to equilibrate)
2. Insert reference thermometer: should read 0°C ±0.5°C
3. Submerge NTC thermistor in ice water (wait 30 seconds)
4. Record ADC reading from UART: `adc_0c = ?????`

**Point 2: Body Temperature (37°C) or Room Temp (25°C)**
1. For body temp: Hold thermistor between fingers for 1 minute
2. For room temp: Let thermistor sit in stable room for 5 minutes
3. Measure reference temperature with precision thermometer
4. Record ADC reading: `adc_ref = ?????` and `temp_ref = ???`

**Calculate Calibration Factors:**

```c
// Measure these values
#define ADC_AT_0C     50000    // Example value
#define ADC_AT_25C    32768    // Example value

// Calculate calibration
float adc_to_celsius_calibrated(uint16_t adc_raw) {
    // Step 1: Raw ADC to uncalibrated temp
    float temp_uncal = thermal_adc_to_celsius(adc_raw);

    // Step 2: Apply two-point correction
    // Assume linear correction: T_cal = gain × T_uncal + offset
    float temp_cal = temp_uncal * CAL_GAIN + CAL_OFFSET;

    return temp_cal;
}

// Gain and offset calculated from calibration points:
// At 0°C:  temp_uncal_0c  = thermal_adc_to_celsius(ADC_AT_0C)
// At 25°C: temp_uncal_25c = thermal_adc_to_celsius(ADC_AT_25C)
//
// CAL_GAIN = (25 - 0) / (temp_uncal_25c - temp_uncal_0c)
// CAL_OFFSET = 0 - CAL_GAIN × temp_uncal_0c
```

**Store Calibration in Flash:**

See Section 10.3 for flash storage format.

### 7.3 Verification

After calibration, verify accuracy at multiple points:

| Reference Temp | Measured Temp | Error | Acceptance |
|---|---|---|---|
| 0°C (ice) | 0.2°C | +0.2°C | ✓ < 0.5°C |
| 25°C (room) | 24.8°C | -0.2°C | ✓ < 0.5°C |
| 37°C (body) | 37.1°C | +0.1°C | ✓ < 0.5°C |
| 50°C (heater)  | 50.3°C | +0.3°C | ✓ < 0.5°C |

---

## 8. Troubleshooting

### 8.1 Common Hardware Issues

**Problem: Temperature reads 150°C constantly**

**Cause:** Thermistor disconnected or open circuit

**Debug Steps:**
1. Measure resistance of thermistor with multimeter
   - Should read ~10kΩ at room temp
   - If open (infinite resistance): Bad thermistor or broken wire
2. Check ADC voltage at FPGA pin
   - Should read ~1.65V at room temp
   - If reads 3.3V: Open circuit confirmed
3. Check solder joints on thermistor leads

**Fix:** Resolder connections or replace thermistor

---

**Problem: Temperature reads -40°C constantly**

**Cause:** Thermistor shorted to ground

**Debug Steps:**
1. Measure resistance: Should be ~10kΩ, not 0Ω
2. Check for solder bridges on PCB
3. Verify correct polarity (though NTC has no polarity)

**Fix:** Remove solder bridge or replace thermistor

---

**Problem: Temperature fluctuates wildly (±10°C swings)**

**Cause:** EMI pickup on ADC input or insufficient filtering

**Debug Steps:**
1. Check for 100nF capacitor at ADC input
2. Verify twisted-pair wiring
3. Check cable routing (away from switching nodes)
4. Measure ADC voltage with oscilloscope (should be stable)

**Fix:**
- Add/replace filter capacitor
- Use shielded cable
- Add ferrite bead on cable

---

**Problem: Fault triggers immediately at startup**

**Cause:** Comparator threshold set too low or inverted logic

**Debug Steps:**
1. Measure comparator threshold voltage
   - Should be ~0.40V for 75°C trip point
2. Check comparator output logic level
   - Should be LOW during normal operation
   - Should go HIGH when fault occurs
3. Verify FPGA pin is configured as active-high input

**Fix:**
- Adjust threshold voltage divider
- Check comparator connections (+ and - pins)
- Verify FPGA pin polarity

---

**Problem: PWM doesn't disable on thermal fault**

**Cause:** Fault signal not connected or protection module disabled

**Debug Steps:**
1. Check FPGA pin connections with multimeter
2. Verify protection module instantiation in RTL
3. Read FAULT_STATUS register via UART
   - Should show bit [4] or [5] set when fault occurs
4. Check pwm_disable signal reaches PWM peripheral

**Fix:**
- Verify top-level wiring
- Check protection module enable bits
- Verify PWM peripheral respects pwm_disable signal

### 8.2 Common Software Issues

**Problem: `thermal_adc_to_celsius()` returns wrong values**

**Cause:** Incorrect NTC parameters or math errors

**Debug Steps:**
1. Verify NTC part number matches code constants
2. Test with known ADC values from datasheet table
3. Check for integer overflow (use float throughout)

**Example Test:**
```c
// At 25°C, NTC = 10kΩ, voltage divider should give 1.65V
// ADC reading: (1.65 / 3.3) × 65535 = 32768
uint16_t adc_test = 32768;
float temp = thermal_adc_to_celsius(adc_test);
// Should return ~25.0°C
```

**Fix:** Verify constants match your NTC datasheet

---

**Problem: Compilation error "undefined reference to `logf`"**

**Cause:** Math library not linked

**Fix:** Add `-lm` to linker flags in Makefile
```makefile
LDFLAGS = -lm
```

---

**Problem: ISR takes too long (>50 µs)**

**Cause:** Floating-point math is slow without FPU

**Solutions:**
1. **Use lookup table** (see Section 5.3, USE_LOOKUP_TABLE)
2. **Fixed-point math** (convert to integer operations)
3. **Reduce sampling rate** (check thermal every 10th cycle = 1 kHz)

**Example: Reduced Rate**
```c
void pwm_isr(void) {
    static uint8_t thermal_counter = 0;

    // Run thermal check every 10 cycles (1 kHz instead of 10 kHz)
    if (++thermal_counter >= 10) {
        thermal_counter = 0;
        thermal_update(&g_thermal);
    }

    // Rest of ISR...
}
```

### 8.3 Debugging Tools

**UART Debug Commands:**

Implement these commands for runtime debugging:

```c
// In main.c command parser
if (strcmp(cmd, "thermal") == 0) {
    char status[128];
    thermal_get_status_string(&g_thermal, status);
    uart_puts(status);
}

if (strcmp(cmd, "thermal_raw") == 0) {
    // Print raw ADC values
    uint16_t adc_h1 = adc_read_channel(4);
    uint16_t adc_h2 = adc_read_channel(5);
    sprintf(buf, "ADC H1: %u (0x%04X)\r\nADC H2: %u (0x%04X)\r\n",
            adc_h1, adc_h1, adc_h2, adc_h2);
    uart_puts(buf);
}

if (strcmp(cmd, "thermal_test") == 0) {
    // Test temperature calculation with known ADC value
    uint16_t test_adc = 32768;  // Should be ~25°C
    float test_temp = thermal_adc_to_celsius(test_adc);
    sprintf(buf, "Test: ADC %u → %.2f°C\r\n", test_adc, test_temp);
    uart_puts(buf);
}

if (strcmp(cmd, "thermal_clear") == 0) {
    thermal_clear_faults();
}
```

**Oscilloscope Monitoring:**

Monitor these signals during testing:

1. **Thermistor voltage** (at ADC input)
   - Should be stable (small ripple <10mV)
   - Changes slowly with temperature

2. **Comparator output**
   - LOW during normal operation
   - HIGH when temp > 75°C

3. **PWM signals**
   - Should disable within 10 µs of comparator trip

4. **Interrupt signal** (if exposed)
   - Pulse when fault occurs

---

## 9. Performance Analysis

### 9.1 Resource Utilization

**Silicon Area (FPGA/ASIC):**

```
Component             | Gates | LUTs (FPGA) | Impact
----------------------|-------|-------------|--------
ADC expansion (4→6ch) | +200  | +50         | +0.4%
Protection (4→6 bits) | +100  | +30         | +0.2%
Comparator logic      | +50   | +15         | +0.1%
----------------------|-------|-------------|--------
TOTAL                 | +350  | +95         | +0.7%
```

**Memory (RAM):**
- Per-channel state: 12 bytes × 2 = 24 bytes
- Total overhead: <50 bytes

**Code Size (Flash):**
- thermal_monitor.c: ~2 KB compiled
- Math library (logf): ~4 KB (if not already included)
- Total: ~6 KB

### 9.2 Timing Analysis

**ISR Timing Breakdown (50 MHz CPU):**

| Operation | Cycles | Time (µs) | % of Budget |
|---|---|---|---|
| ADC read (2 ch) | 40 | 0.8 | 1.6% |
| Voltage calc | 80 | 1.6 | 3.2% |
| NTC resistance calc | 60 | 1.2 | 2.4% |
| logf() function | 100 | 2.0 | 4.0% |
| Steinhart-Hart | 30 | 0.6 | 1.2% |
| Threshold checks | 40 | 0.8 | 1.6% |
| **TOTAL THERMAL** | **350** | **7.0 µs** | **14%** |

**Note:** logf() dominates timing. Use lookup table if performance critical.

### 9.3 Response Time Analysis

**Hardware Comparator Path:**

```
Temperature increase → NTC resistance decrease → Voltage drop
   → Comparator trip → FPGA fault input → Protection disable PWM

Total: <10 µs (dominated by thermistor thermal time constant)
```

**Software Path:**

```
Temperature increase → ADC sample → CPU read → Calculate temp
   → Compare threshold → Disable PWM → Gate driver off

Total: ~100 µs (one control cycle + gate driver turn-off)
```

**Worst-Case Thermal Runaway:**

Assuming 7W per MOSFET, 1°C/s rise rate without cooling:

```
Time to reach 75°C from 60°C = 15 seconds

With 10 µs response time:
- Temperature overshoot: 15°C / 15s × 10µs = 0.0001°C ← Negligible

Hardware response is effectively instantaneous compared to thermal dynamics.
```

### 9.4 Cost-Benefit Summary

| Metric | Value | Comment |
|---|---|---|
| **Hardware Cost** | $1.22 | Per board (2 H-bridges) |
| **Development Time** | 4-6 hours | One-time effort |
| **Silicon Area** | +350 gates | +0.7% increase |
| **Performance Impact** | +7 µs ISR | Still within budget |
| **MOSFET Failure Prevented** | $50-100 | Per incident |
| **ROI** | <1 failure | Pays for itself |
| **Safety Improvement** | Critical | Prevents fire hazard |

**Conclusion:** Essential addition with minimal cost and excellent ROI.

---

## 10. Appendix

### 10.1 NTC Thermistor Theory

**Steinhart-Hart Equation (Full Form):**

```
1/T = A + B×ln(R) + C×ln³(R)

Where:
  T = Temperature (Kelvin)
  R = Resistance (Ω)
  A, B, C = Steinhart-Hart coefficients (from datasheet)
```

**Simplified β-Parameter Form (Used in Our Code):**

```
1/T = 1/T₀ + (1/β)×ln(R/R₀)

Where:
  T₀ = Reference temperature (298.15K = 25°C)
  R₀ = Resistance at T₀ (10kΩ)
  β = Beta parameter (3380K for our NTC)

This form is accurate to ±1°C over 0-100°C range.
```

**Why β-Parameter is Sufficient:**

Full Steinhart-Hart provides ±0.01°C accuracy but requires:
- Three calibration points
- Solving 3×3 matrix for A, B, C coefficients
- More complex math (ln³ term)

For our application, ±1°C is adequate, so β-parameter form is preferred.

### 10.2 Voltage Divider Design Trade-offs

**Resistor Value Selection:**

| R_series | Pro | Con | Verdict |
|---|-----|-----|---|
| 1kΩ | Less ADC noise | More self-heating, lower sensitivity | ❌ |
| 10kΩ | Good balance | Standard choice | ✅ Recommended |
| 100kΩ | Minimal self-heating | More noise susceptible, high Z | ❌ |

**Our Choice: 10kΩ**
- Self-heating: 0.27 mW → 0.27°C (negligible)
- ADC noise: Acceptable with 100nF filter cap
- Sensitivity: 50 mV/°C @ 25°C (good resolution)

### 10.3 Flash Storage Format

For storing calibration data persistently:

```c
/**
 * @brief Thermal calibration data structure (stored in flash)
 */
typedef struct {
    uint32_t magic;              // 0xCAL1BRA7 (magic number for validation)
    float    cal_gain_h1;        // Calibration gain for H1
    float    cal_offset_h1;      // Calibration offset for H1 (°C)
    float    cal_gain_h2;        // Calibration gain for H2
    float    cal_offset_h2;      // Calibration offset for H2 (°C)
    uint32_t calibration_date;   // Unix timestamp when calibrated
    uint32_t crc32;              // CRC32 checksum for validation
} __attribute__((packed)) thermal_cal_data_t;

// Flash address (last sector of flash)
#define FLASH_CAL_ADDR  0x0000_7C00  // Last 1KB of 32KB flash

/**
 * @brief Load calibration from flash
 */
int thermal_load_calibration(thermal_cal_data_t *cal) {
    // Read from flash
    memcpy(cal, (void*)FLASH_CAL_ADDR, sizeof(thermal_cal_data_t));

    // Validate magic number
    if (cal->magic != 0xCAL1BRA7) {
        // Flash empty or corrupted, use defaults
        cal->cal_gain_h1 = 1.0f;
        cal->cal_offset_h1 = 0.0f;
        cal->cal_gain_h2 = 1.0f;
        cal->cal_offset_h2 = 0.0f;
        return -1;  // No valid calibration
    }

    // Validate CRC
    uint32_t crc_calc = crc32_calculate((uint8_t*)cal,
                                        sizeof(thermal_cal_data_t) - 4);
    if (crc_calc != cal->crc32) {
        return -2;  // CRC mismatch
    }

    return 0;  // Success
}

/**
 * @brief Save calibration to flash
 */
int thermal_save_calibration(thermal_cal_data_t *cal) {
    cal->magic = 0xCAL1BRA7;
    cal->calibration_date = get_unix_time();
    cal->crc32 = crc32_calculate((uint8_t*)cal,
                                 sizeof(thermal_cal_data_t) - 4);

    // Erase flash sector
    flash_erase_sector(FLASH_CAL_ADDR);

    // Write calibration data
    flash_write(FLASH_CAL_ADDR, (uint8_t*)cal, sizeof(thermal_cal_data_t));

    return 0;
}
```

### 10.4 Alternative Thermistor Circuits

**Circuit A: Single-Supply Rail-to-Rail Op-Amp Buffer**

For high-impedance ADC inputs, add buffer:

```
    +3.3V ──[10kΩ]──┬──→ To op-amp (+)
                    │
                  [NTC]     [Op-Amp Buffer]
                    │         ↓
                   GND    →  To ADC
```

Pro: Reduced ADC loading
Con: +$0.20, more components
Use when: ADC input impedance < 10kΩ

---

**Circuit B: Three-Wire Kelvin Connection**

For remote sensing (cable > 1m):

```
    +3.3V ──[10kΩ]──┬───[Wire 1: Force +]───┐
                    │                        │
                    └───[Wire 2: Sense +]───┼──→ To ADC (+)
                                             │
                                          [NTC]
                                             │
                        ┌───[Wire 3: GND]───┘
                        │
                       GND
```

Pro: Eliminates wire resistance errors
Con: Requires 3 wires instead of 2
Use when: Cable length > 1 meter

### 10.5 References and Further Reading

**Datasheets:**
- Murata NCP15XH103F03RC: [https://www.murata.com/ntc](https://www.murata.com/ntc)
- LM393 Comparator: [https://www.ti.com/product/LM393](https://www.ti.com/product/LM393)

**Application Notes:**
- AN3900: "Understanding NTC Thermistors" - Murata
- AN-1087: "Designing with Thermistors" - Analog Devices
- SLVA482: "Comparator Applications" - Texas Instruments

**Academic Papers:**
- Steinhart, J.S. & Hart, S.R. (1968). "Calibration curves for thermistors"
- IEEE Trans. on Power Electronics: "Thermal Management of Power Converters"

**Online Calculators:**
- NTC Thermistor Calculator: [https://www.murata.com/calculator](https://www.murata.com/calculator)
- Steinhart-Hart Coefficient Calculator: [https://www.thinksrs.com/downloads/programs/therm%20calc/ntccalibrator/ntccalculator.html](https://www.thinksrs.com/downloads/programs/therm%20calc/ntccalibrator/ntccalculator.html)

---

**End of Document**

For questions or clarifications, contact the project team or open an issue in the project repository.
