feaksel/5level-inverter/02-embedded/riscv-soc-vexrv/docs/COMPREHENSIVE_GUIDE.md

# RISC-V 5-Level Inverter Control SoC - Comprehensive Guide

**Complete Project Documentation: Architecture, Design Decisions, ASIC Flow, and Firmware Management**

---

## Table of Contents

1. [Project Overview](#1-project-overview)
2. [Complete Architecture Breakdown](#2-complete-architecture-breakdown)
3. [How Everything Connects](#3-how-everything-connects)
4. [Design Decisions and Alternatives](#4-design-decisions-and-alternatives)
5. [Optimization Opportunities](#5-optimization-opportunities)
6. [Modularity and Extensibility](#6-modularity-and-extensibility)
7. [FPGA Development Flow](#7-fpga-development-flow)
8. [ASIC Design Flow](#8-asic-design-flow)
9. [Firmware Management](#9-firmware-management)
10. [Next Steps and Recommendations](#10-next-steps-and-recommendations)

---

## 1. Project Overview

### What Is This Project?

This is a **complete System-on-Chip (SoC)** for controlling a 5-level cascaded H-bridge inverter, designed to convert DC power to high-quality AC power.

**Key Features:**
- **Soft-core CPU:** VexRiscv (RV32IMC) - runs custom firmware
- **Hardware Accelerator:** PWM generation with 4 level-shifted carriers
- **Real-time Control:** 50 MHz operation, 5 kHz PWM switching
- **Complete SoC:** Memory, peripherals, bus interconnect
- **ASIC-ready:** Technology-independent Verilog
- **Production-quality:** All bugs fixed, timing met, verified in simulation

**Target Application:** High-efficiency AC inverters for:
- Solar inverters (DC→AC conversion)
- Motor drives (variable frequency drives)
- UPS systems (uninterruptible power supplies)
- Grid-tied inverters

### Why 5-Level Cascaded H-Bridge?

**Traditional 2-Level Inverter:**
```
Output: +Vdc, 0, -Vdc (3 levels)
Waveform: Square wave
THD: ~40-60% (poor quality)
```

**5-Level Cascaded H-Bridge:**
```
Output: +4Vdc, +3Vdc, +2Vdc, +Vdc, 0, -Vdc, -2Vdc, -3Vdc, -4Vdc (9 levels!)
Waveform: Smooth staircase approximating sine
THD: <5% (excellent quality)
Switching frequency: 5 kHz (vs 50 kHz needed for 2-level)
Efficiency: Higher (lower switching losses)
```

---

## 2. Complete Architecture Breakdown

### System Block Diagram

```
┌─────────────────────────────────────────────────────────────────────┐
│                     RISC-V SoC (soc_top.v)                          │
│                                                                     │
│  ┌───────────────────┐                                             │
│  │ Clock Generation  │  100 MHz → 50 MHz                           │
│  └─────────┬─────────┘                                             │
│            │ clk_50mhz                                              │
│            ▼                                                        │
│  ┌─────────────────────────────────────────────────────────────┐   │
│  │                VexRiscv CPU Core (RV32IMC)                  │   │
│  │  • 32-bit RISC-V processor                                  │   │
│  │  • Instruction bus (IBus) + Data bus (DBus)                 │   │
│  │  • M extension: multiply/divide                             │   │
│  │  • C extension: compressed instructions (16-bit)            │   │
│  └───────────────┬─────────────┬───────────────────────────────┘   │
│                  │ IBus        │ DBus                              │
│                  ▼             ▼                                   │
│  ┌────────────────────────────────────────────────────────────┐   │
│  │           Wishbone Bus Arbiter / Interconnect              │   │
│  │  • Arbitrates IBus and DBus                                │   │
│  │  • Routes transactions to peripherals                      │   │
│  │  • Memory-mapped I/O                                       │   │
│  └───┬────┬────┬────┬────┬────┬────┬────┬─────────────────────┘   │
│      │    │    │    │    │    │    │    │                         │
│  ┌───▼──┐ │    │    │    │    │    │    │                         │
│  │ ROM  │ │    │    │    │    │    │    │   Memory Map:           │
│  │ 32KB │ │    │    │    │    │    │    │   0x00000000: ROM       │
│  └──────┘ │    │    │    │    │    │    │   0x00010000: RAM       │
│  ┌────▼───┐    │    │    │    │    │    │   0x00020000: PWM       │
│  │  RAM   │    │    │    │    │    │    │   0x00020100: ADC       │
│  │  64KB  │    │    │    │    │    │    │   0x00020200: Protection│
│  └────────┘    │    │    │    │    │    │   0x00020300: Timer     │
│  ┌─────────▼───┐    │    │    │    │    │   0x00020400: GPIO      │
│  │PWM Accel    │    │    │    │    │    │   0x00020500: UART      │
│  │• 4 Carriers │    │    │    │    │    │                         │
│  │• Sine Gen   │    │    │    │    │    │                         │
│  │• 8 PWM out  │    │    │    │    │    │                         │
│  └────┬────────┘    │    │    │    │    │                         │
│       │ pwm_out[7:0]│    │    │    │    │                         │
│       └─────────────┼────┼────┼────┼────┼──────────> Pmod JA, JB  │
│  ┌──────────▼───┐   │    │    │    │                              │
│  │ADC Interface │   │    │    │    │                              │
│  │(SPI Master)  ├───┼────┼────┼────┼──────────> ADC chips         │
│  └──────────────┘   │    │    │    │                              │
│  ┌──────────▼───────┐    │    │    │                              │
│  │Protection/Fault  │    │    │    │                              │
│  │• OCP, OVP        │◄───┼────┼────┼──────────< Fault inputs      │
│  │• Watchdog        │    │    │    │                              │
│  └──────────────────┘    │    │    │                              │
│  ┌──────────▼───┐        │    │    │                              │
│  │    Timer     │        │    │    │                              │
│  └──────────────┘        │    │    │                              │
│  ┌──────────▼───┐        │    │    │                              │
│  │    GPIO      ├────────┼────┼────┼──────────> LEDs, switches    │
│  │    32-bit    │        │    │    │                              │
│  └──────────────┘        │    │    │                              │
│  ┌──────────▼───┐        │    │    │                              │
│  │    UART      ├────────┴────┴────┴──────────> USB-UART          │
│  │   115200     │                                                 │
│  └──────────────┘                                                 │
└─────────────────────────────────────────────────────────────────────┘
```

### Component Details

#### A. VexRiscv CPU Core

**What it is:**
- Open-source 32-bit RISC-V processor
- Written in SpinalHDL, generates Verilog
- Configurable (we use RV32IMC variant)

**Why VexRiscv?**
- ✓ Small size (~2000 LUTs on FPGA, ~15k gates for ASIC)
- ✓ Good performance (1.44 DMIPS/MHz)
- ✓ Proven in production (used in many projects)
- ✓ Well-documented
- ✓ Free and open-source (MIT license)

**Alternatives Considered:**
- **PicoRV32:** Smaller but slower (0.86 DMIPS/MHz)
- **Ibex (lowRISC):** Larger, more complex, 2-stage pipeline
- **SERV:** Smallest (200 LUTs) but very slow (0.15 DMIPS/MHz)
- **Custom CPU:** Too much work, reinventing the wheel

**ISA Extensions:**
- **RV32I:** Base 32-bit integer instructions
- **M:** Multiply/divide (needed for control algorithms)
- **C:** Compressed 16-bit instructions (saves ROM space)

#### B. PWM Accelerator

**Architecture:**
```
┌───────────────────────────────────────────────────────────┐
│          PWM Accelerator (pwm_accelerator.v)              │
├───────────────────────────────────────────────────────────┤
│                                                           │
│  ┌──────────────────┐         ┌─────────────────────┐    │
│  │ Wishbone Regs    │         │  Carrier Generator  │    │
│  │ ──────────────   │         │  ─────────────────  │    │
│  │ CTRL             │         │  Phase Accumulator  │    │
│  │ FREQ_DIV = 5000  │────────▶│  ÷2 → 50 MHz        │    │
│  │ MOD_INDEX = 32767│         │         ÷5000        │    │
│  │ SINE_FREQ = 17   │         │    = 5 kHz carrier  │    │
│  │ DEADTIME = 50    │         │                     │    │
│  └──────────────────┘         │  Generates 4 waves: │    │
│                               │  • carrier1: -32k to -16k │
│                               │  • carrier2: -16k to 0    │
│                               │  • carrier3: 0 to +16k    │
│                               │  • carrier4: +16k to +32k │
│                               └──────┬──────────────┘    │
│  ┌──────────────────┐                │                   │
│  │  Sine Generator  │                │                   │
│  │  ───────────────│                │                   │
│  │  32-bit phase    │                │                   │
│  │  accumulator     │                │                   │
│  │  Increment:      │                │                   │
│  │  freq×256×50MHz  │                │                   │
│  │   ─────────────  │                │                   │
│  │       2^32       │                │                   │
│  │                  │                │                   │
│  │  SINE_FREQ=17:   │                │                   │
│  │  f = 50.664 Hz   │                │                   │
│  │                  │                │                   │
│  │  Output:         │                │                   │
│  │  -32768 to       │                │                   │
│  │  +32767 sine     │                │                   │
│  └────────┬─────────┘                │                   │
│           │ sine_ref                 │                   │
│           │                          │                   │
│  ┌────────▼──────────────────────────▼─────────────┐    │
│  │         4× PWM Comparators                      │    │
│  │         ─────────────────                       │    │
│  │  if (sine_ref > carrier) → HIGH                 │    │
│  │  if (sine_ref < carrier) → LOW                  │    │
│  │                                                  │    │
│  │  Comparator 1: sine vs carrier1 → pwm_out[0:1]  │    │
│  │  Comparator 2: sine vs carrier2 → pwm_out[2:3]  │    │
│  │  Comparator 3: sine vs carrier3 → pwm_out[4:5]  │    │
│  │  Comparator 4: sine vs carrier4 → pwm_out[6:7]  │    │
│  │                                                  │    │
│  │  Dead-time: 1 μs inserted between complementary │    │
│  │  pairs to prevent shoot-through                 │    │
│  └──────────────────┬───────────────────────────────┘    │
│                     │                                    │
│                     ▼                                    │
│           pwm_out[7:0] ────────────────▶ To H-bridges   │
└───────────────────────────────────────────────────────────┘
```

**Why Hardware Accelerator?**

**Option 1: Software PWM (Rejected)**
```c
// In interrupt handler every 20 μs
void timer_interrupt() {
    static int counter = 0;
    int sine = sin_table[counter];

    for (int i = 0; i < 4; i++) {
        if (sine > carrier[i]) {
            set_pwm_high(i);
        } else {
            set_pwm_low(i);
        }
    }
    counter++;
}
```
**Problems:**
- ✗ 50 MHz / 5000 = 10,000 Hz interrupt rate = every 100 cycles
- ✗ CPU spends 90% of time in ISR
- ✗ No dead-time precision (software delays unreliable)
- ✗ Jitter in PWM timing
- ✗ Can't do anything else

**Option 2: Hardware Accelerator (Chosen!)**
- ✓ PWM runs independently of CPU
- ✓ Precise dead-time (50 clock cycles = 1 μs exactly)
- ✓ No jitter
- ✓ CPU free to do control algorithms, communication, monitoring
- ✓ Only ~500 LUTs added

#### C. Memory System

**ROM (32 KB):**
- Stores firmware (compiled from C/assembly)
- Initialized from .hex file at synthesis
- Read-only (prevents accidental corruption)
- Located at 0x00000000 (reset vector)

**Why 32 KB?**
- Compressed instructions (RV32C) reduce code size by ~30%
- Current firmware: ~5 KB
- Leaves room for:
  - Advanced control algorithms (PI, PR, resonant controllers)
  - Communication protocols (Modbus, CANopen)
  - Diagnostics and logging
  - OTA update bootloader

**RAM (64 KB):**
- Stack, heap, variables
- Located at 0x00010000
- Read/write

**Why 64 KB?**
- Stack: ~4 KB typical
- Heap: ~8 KB for dynamic allocation
- Buffers: UART RX/TX, ADC samples, logs
- Future expansion: Room for larger datasets

**Alternatives:**
- **Smaller (16 KB RAM):** Possible but tight
- **Larger (128 KB):** Wastes silicon area for this application
- **External SRAM:** Adds complexity, cost, PCB routing

#### D. Wishbone Bus

**What it is:**
- Open-source bus protocol (like AXI, but simpler)
- Master-slave architecture
- Used to connect CPU to peripherals

**Bus Signals:**
```verilog
// Master → Slave
wb_addr[31:0]   // Address
wb_dat_i[31:0]  // Data to write
wb_we           // Write enable (1=write, 0=read)
wb_sel[3:0]     // Byte select
wb_stb          // Strobe (transaction valid)
wb_cyc          // Cycle (burst indicator)

// Slave → Master
wb_dat_o[31:0]  // Data read
wb_ack          // Acknowledge (transaction complete)
```

**Why Wishbone?**
- ✓ Simple to implement
- ✓ Low resource usage
- ✓ Well-documented
- ✓ Open standard (no licensing)
- ✓ Widely used in open-source projects

**Alternatives:**
- **AXI/AXI-Lite:** More complex, higher performance (overkill here)
- **APB:** Similar simplicity, but less widely supported
- **Custom bus:** More work, compatibility issues

---

## 3. How Everything Connects

### Power-On Reset Sequence

```
Time  Event
─────────────────────────────────────────────────
0 ms   │ FPGA powers on
       │ All flip-flops reset to 0
       │
10 ms  │ Configuration complete
       │ Clock starts: 100 MHz → 50 MHz divider
       │
12 ms  │ Reset released (rst_n = 1)
       │ CPU fetches instruction from 0x00000000 (ROM)
       │
       ▼
       Firmware execution begins
       │
       ├─ Initialize stack pointer
       ├─ Zero BSS section (uninitialized variables)
       ├─ Initialize data section
       ├─ Configure peripherals:
       │  ├─ UART: 115200 baud
       │  ├─ PWM:  5 kHz carrier, 50 Hz sine, DISABLED
       │  ├─ Timer: Setup but not started
       │  ├─ GPIO: Set LED directions
       │  └─ Protection: Enable watchdog, fault monitoring
       │
       ├─ Enable PWM (CTRL register = 1)
       │  └─ PWM accelerator starts generating signals
       │
       └─ Enter main loop:
          ├─ Kick watchdog
          ├─ Check fault status
          ├─ Read ADC values
          ├─ Update control (future: PI controller)
          ├─ Toggle heartbeat LED
          └─ Repeat every 10 ms
```

### Data Flow Example: Reading PWM Status

```
User wants to read PWM output state via UART

1. CPU executes: lw a0, 0x1C(t1)  // Read PWM_OUT register
   │
   ▼
2. CPU issues DBus read transaction:
   - wb_addr = 0x0002001C (PWM base + 0x1C offset)
   - wb_we = 0 (read)
   - wb_stb = 1
   │
   ▼
3. Wishbone arbiter routes to PWM peripheral
   │
   ▼
4. PWM peripheral decodes address:
   - Offset 0x1C = PWM_OUT register (address[7:2] == 6'h07)
   - Returns current pwm_out[7:0] value
   - Sets wb_ack = 1
   │
   ▼
5. CPU receives data in register a0
   - Example: a0 = 0x000000A5 (pwm_out = 10100101)
   │
   ▼
6. Firmware sends via UART:
   uart_putc('P');
   uart_putc('W');
   uart_putc('M');
   uart_putc(':');
   uart_putc(' ');
   uart_puthex(a0);
   │
   ▼
7. User sees: "PWM: A5" on terminal
```

### Clock Domain Structure

```
Primary Clock (100 MHz oscillator):
│
├─ sys_clk_pin (100 MHz)
│  - Used only for clock generation
│  - Not used directly by logic
│
└─ clk_50mhz (50 MHz, divided from 100 MHz)
   │
   ├─ CPU (VexRiscv)
   ├─ All Peripherals
   ├─ Bus interconnect
   └─ All I/O registers

Single clock domain → No CDC (Clock Domain Crossing) issues!
```

**Why Single Clock Domain?**
- ✓ Simple timing analysis
- ✓ No metastability issues
- ✓ No CDC synchronizers needed
- ✓ Easier to verify

### Physical Connections (FPGA Pins)

```
Basys 3 FPGA Board
┌─────────────────────────────────────────────────────┐
│                                                     │
│  ┌──────────────┐                                   │
│  │ Artix-7 FPGA │                                   │
│  │ XC7A35T      │                                   │
│  │              │  pwm_out[0:3] ──────▶ Pmod JA     │
│  │              │  pwm_out[4:7] ──────▶ Pmod JB     │
│  │              │  fault inputs ◄────── Pmod JC     │
│  │              │  adc_spi ────────────▶ Pmod JC    │
│  │              │  gpio[0:7] ──────────▶ Pmod JD    │
│  │              │  led[0:3] ────────────▶ LEDs      │
│  │              │  uart ────────────────▶ USB-UART  │
│  └──────────────┘                                   │
│                                                     │
│  External Connections:                             │
│  ┌────────────┐   Pmod JA/JB                       │
│  │ Gate       │◄────────────── pwm_out[7:0]        │
│  │ Drivers    │   (3.3V LVCMOS)                    │
│  │ (ISO)      │                                     │
│  │ (e.g.,     │   Isolated                         │
│  │  Si8261)   │   15V signals                      │
│  └─────┬──────┘                                     │
│        │                                            │
│        ▼                                            │
│  ┌────────────────┐                                 │
│  │ 4× H-Bridge    │                                 │
│  │ Power Modules  │                                 │
│  │ (e.g., SK30GB) │                                 │
│  │ Each 1200V,    │                                 │
│  │      30A       │                                 │
│  └────────┬───────┘                                 │
│           │                                         │
│           ▼                                         │
│      AC Output (5-level, 50 Hz)                     │
│      ~~~~~~~~~~~~~~~~~~~                            │
│      To load (motor, grid, etc.)                    │
└─────────────────────────────────────────────────────┘
```

---

## 4. Design Decisions and Alternatives

### Decision 1: Soft CPU vs Hard CPU

**Chosen: Soft CPU (VexRiscv in FPGA fabric)**

**Pros:**
- ✓ Flexible (can be modified, debugged)
- ✓ Portable (works on any FPGA, can go to ASIC)
- ✓ Free (no licensing)
- ✓ Integrated with accelerators on same die

**Cons:**
- ✗ Uses FPGA LUTs (~2000 LUTs = ~30% of Basys 3)
- ✗ Lower performance than hard ARM core

**Alternative: ARM Cortex-M on separate chip**
**Pros:**
- ✓ Higher performance
- ✓ Free up FPGA resources
- ✓ Easier firmware development (more tools)

**Cons:**
- ✗ Two chips instead of one
- ✗ PCB routing complexity
- ✗ Higher cost
- ✗ Latency in FPGA↔CPU communication
- ✗ Not truly a SoC

**For ASIC:** Soft CPU wins (integrated, single die)

### Decision 2: Fixed-Point vs Floating-Point

**Chosen: Fixed-Point (16-bit signed)**

**Sine reference:**
- Range: -32768 to +32767
- Resolution: 1 / 32768 = 0.003%
- More than sufficient for PWM

**Pros:**
- ✓ Simple hardware (no FPU needed)
- ✓ Fast (single-cycle operations)
- ✓ Small area
- ✓ Deterministic

**Cons:**
- ✗ Limited dynamic range (but fine for PWM)

**Alternative: 32-bit floating-point**
**Pros:**
- ✓ Easier firmware math
- ✓ Wider dynamic range

**Cons:**
- ✗ Requires FPU hardware (+5000 LUTs)
- ✗ Slower (multi-cycle operations)
- ✗ Overkill for this application

### Decision 3: Level-Shifted PWM vs Phase-Shifted PWM

**Chosen: Level-Shifted Carrier PWM**

**How it works:**
- 4 carriers at different DC levels
- Same frequency (5 kHz)
- Compare single sine reference against all carriers
- Creates natural 5-level output

**Pros:**
- ✓ Simple to implement
- ✓ Low THD (<5%)
- ✓ Natural balancing of H-bridge voltages

**Alternative: Phase-Shifted Carrier PWM**
- 4 carriers at same DC level
- Phase-shifted by 90° from each other
- More complex control logic

**Pros:**
- ✓ Better for certain load types

**Cons:**
- ✗ More complex
- ✗ Requires phase synchronization
- ✗ Not better for inverters

### Decision 4: ROM Initialization Method

**Chosen: $readmemh() from .hex file**

**How it works:**
```verilog
// In rom.v:
initial begin
    $readmemh("firmware/inverter_firmware_fixed_v2.hex", rom_mem);
end
```

**Pros:**
- ✓ Simple
- ✓ Works in both simulation and synthesis
- ✓ Standard practice

**Alternative 1: Block RAM initialization (Xilinx COE file)**
```
memory_initialization_radix=16;
memory_initialization_vector=
00000013,
00000513,
...
```

**Pros:**
- ✓ Vendor-optimized

**Cons:**
- ✗ Vendor-specific (not portable to ASIC)
- ✗ Different file format from simulator

**Alternative 2: SPI Flash boot**
- Load firmware from external flash on boot

**Pros:**
- ✓ Firmware updates without re-synthesizing

**Cons:**
- ✗ Adds complexity
- ✗ Boot time delay
- ✗ More expensive
- ✗ Not needed for this design

---

## 5. Optimization Opportunities

### Current Resource Usage (Basys 3 FPGA)

**Estimated (before implementation):**
```
Component          LUTs    FFs    BRAMs   DSPs
───────────────────────────────────────────────
VexRiscv          ~2000  ~1500      0      2-4
ROM (32 KB)           0      0      1      0
RAM (64 KB)           0      0      2      0
PWM Accelerator    ~500   ~200      0      0
Peripherals        ~800   ~600      0      0
Bus interconnect   ~200   ~100      0      0
───────────────────────────────────────────────
TOTAL             ~3500  ~2400    3-4     2-4

Basys 3 Available: 20800  41600     50     90
Utilization:        17%     6%      6%     3%
```

**Plenty of room for expansion!**

### Optimization 1: Reduce ROM/RAM Size

**Current:** 32 KB ROM + 64 KB RAM = 96 KB total

**Option: 16 KB ROM + 32 KB RAM**
- Saves 2 BRAMs
- Still sufficient for current firmware
- Limits future expansion

**Recommendation:** Keep current size (future-proof)

### Optimization 2: Use DSP Blocks for Multiply

**Current:** VexRiscv uses LUTs for multiply

**Option:** Force DSP block usage
```verilog
(* use_dsp = "yes" *)
wire [31:0] product = a * b;
```

**Pros:**
- ✓ Saves ~100-200 LUTs
- ✓ Faster multiply

**Cons:**
- ✗ Uses 1-2 DSPs (plenty available)
- ✗ May not be synthesized correctly by all tools

**Recommendation:** Let synthesizer decide (currently not a bottleneck)

### Optimization 3: Optimize Phase Accumulator

**Current:** 32-bit phase accumulator for sine and carrier

**Option:** Reduce to 24-bit or 28-bit
- Saves ~16-32 FFs per generator
- Slight reduction in frequency resolution

**Analysis:**
```
32-bit: Resolution = 50 MHz / 2^32 = 0.0116 Hz
24-bit: Resolution = 50 MHz / 2^24 = 2.98 Hz

For 50 Hz sine:
32-bit: Can hit 50.00 Hz exactly
24-bit: Closest = 47.68 Hz or 53.64 Hz (7.5% error!)
```

**Recommendation:** Keep 32-bit (resolution matters)

### Optimization 4: Simplify CPU Configuration

**Current:** RV32IMC (Integer + Multiply/Divide + Compressed)

**Option 1: Remove M extension** (RV32IC)
- Saves ~500 LUTs
- Software multiply/divide (much slower)
- Not recommended (control algorithms need multiply)

**Option 2: Remove C extension** (RV32IM)
- Saves ~300 LUTs
- Code size increases ~30%
- ROM would need to be 40 KB
- Wastes BRAM

**Recommendation:** Keep RV32IMC

### ASIC-Specific Optimizations

When going to ASIC, different trade-offs apply:

**FPGA:** Optimize for LUT/FF/BRAM usage
**ASIC:** Optimize for:
1. **Area (mm²)** - Smaller = cheaper
2. **Power (mW)** - Lower = better battery life
3. **Speed (MHz)** - Higher = better performance

**ASIC Optimizations:**

**1. Clock Gating:**
```verilog
// Add clock gates to reduce power
always @(posedge clk) begin
    if (enable) begin
        // Only toggle FFs when needed
    end
end

// Becomes in ASIC:
wire gated_clk = clk & enable;
always @(posedge gated_clk) begin
    // Logic here
end
```

**Saves:** ~30% dynamic power

**2. Memory Compiler:**
- Replace `reg [7:0] mem [0:8191]` with foundry SRAM macros
- Much smaller area
- Lower power
- Example: 32 KB ROM = ~0.2 mm² in 180nm

**3. Standard Cell Library:**
- Use optimized cells (AND, OR, MUX, DFF)
- Synthesis tool picks best gates
- Example: Skywater 130nm PDK (open-source!)

**4. Multi-Threshold Voltage:**
- Use High-Vt cells for non-critical paths (lower leakage)
- Use Low-Vt cells for critical paths (faster)
- Balances speed and power

**Area Estimate for 180nm ASIC:**
```
Component               Area (mm²)
─────────────────────────────────
VexRiscv CPU            0.15
ROM (32 KB)             0.20
RAM (64 KB)             0.40
PWM Accelerator         0.05
Peripherals             0.10
I/O pads (50 pads)      1.00
─────────────────────────────────
TOTAL CORE              0.90
TOTAL with pads         1.90 mm²

Die cost @ $2000/wafer:  ~$1-2 per chip
(Assumes 200mm wafer, ~5000 die/wafer, 80% yield)
```

---

## 6. Modularity and Extensibility

### Modular Components

Each peripheral is **self-contained** and **independent**:

**1. PWM Accelerator** (`rtl/peripherals/pwm_accelerator.v`)
- Interface: Wishbone bus + pwm_out pins
- Can be used in other projects
- Parameterized: CLK_FREQ, PWM_FREQ

**2. UART** (`rtl/peripherals/uart.v`)
- Reusable for any UART application
- Parameterized: CLK_FREQ, BAUD_RATE

**3. Timer** (`rtl/peripherals/timer.v`)
- Generic timer peripheral
- Can be used for scheduling, delays, PWM (if PWM accelerator not used)

**4. ADC Interface** (`rtl/peripherals/adc_spi.v`)
- SPI master
- Can talk to any SPI device
- Easy to replace with different ADC

### Adding New Peripherals

**Example: Add a CAN bus peripheral**

**Step 1: Create peripheral module**
```verilog
// rtl/peripherals/can_controller.v
module can_controller #(
    parameter ADDR_WIDTH = 8
)(
    input wire clk,
    input wire rst_n,

    // Wishbone interface
    input wire [ADDR_WIDTH-1:0] wb_addr,
    input wire [31:0] wb_dat_i,
    output reg [31:0] wb_dat_o,
    input wire wb_we,
    input wire wb_stb,
    output reg wb_ack,

    // CAN physical interface
    output wire can_tx,
    input wire can_rx
);
    // CAN logic here...
endmodule
```

**Step 2: Add to memory map** (in `soc_top.v`)
```verilog
localparam CAN_BASE = 32'h00020600;  // New address

// Add to address decoder
wire can_sel = (wb_addr >= CAN_BASE) && (wb_addr < CAN_BASE + 256);

// Instantiate
can_controller can_periph (
    .clk(clk),
    .rst_n(rst_n_sync),
    .wb_addr(wb_addr[7:0]),
    .wb_dat_i(wb_dat_i),
    .wb_dat_o(can_dat_o),
    .wb_we(wb_we && can_sel),
    .wb_stb(wb_stb && can_sel),
    .wb_ack(can_ack),
    .can_tx(can_tx),
    .can_rx(can_rx)
);

// Add to OR tree
assign wb_dat_o = rom_sel  ? rom_dat_o  :
                  ram_sel  ? ram_dat_o  :
                  pwm_sel  ? pwm_dat_o  :
                  can_sel  ? can_dat_o  : // NEW
                  32'h0;
```

**Step 3: Update constraints**
```tcl
# In basys3.xdc
set_property -dict { PACKAGE_PIN XX IOSTANDARD LVCMOS33 } [get_ports can_tx]
set_property -dict { PACKAGE_PIN YY IOSTANDARD LVCMOS33 } [get_ports can_rx]
```

**Step 4: Write driver in firmware**
```c
// In firmware/can_driver.c
#define CAN_BASE 0x00020600
#define CAN_CTRL (CAN_BASE + 0x00)
#define CAN_TX   (CAN_BASE + 0x04)
#define CAN_RX   (CAN_BASE + 0x08)

void can_init() {
    *(volatile uint32_t*)CAN_CTRL = 0x01;  // Enable
}

void can_send(uint32_t id, uint8_t* data, uint8_t len) {
    *(volatile uint32_t*)CAN_TX = (id << 16) | len;
    // ... send data bytes
}
```

**Step 5: Re-synthesize and test!**

### Replacing Components

**Example: Replace VexRiscv with PicoRV32**

**Current:**
```verilog
VexRiscv cpu (
    .iBus_cmd_valid(ibus_valid),
    .iBus_cmd_payload_pc(ibus_addr),
    // ... 50+ signals
);
```

**Replace with:**
```verilog
picorv32 #(
    .ENABLE_MUL(1),
    .ENABLE_DIV(1),
    .COMPRESSED_ISA(1)
) cpu (
    .clk(clk),
    .resetn(rst_n_sync),
    .mem_valid(mem_valid),
    .mem_addr(mem_addr),
    // ... different interface
);
```

**Bridge needed:**
- PicoRV32 uses "memory interface"
- VexRiscv uses separate IBus/DBus
- Write wrapper to convert

**Effort:** ~1 day
**Why do it?** Smaller size, simpler

---

## 7. FPGA Development Flow
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
