feaksel/5level-inverter/02-embedded/riscv/rtl/core/M_EXTENSION_GUIDE.md

# M Extension Implementation Guide — Unified MDU Approach

**Goal:** Implement multiply and divide instructions using a unified Multi-cycle Divide/Multiply Unit (MDU)
**Time:** 2-3 hours for full integration and testing
**Difficulty:** Medium (multi-cycle state machine + signed arithmetic handling)
**Benefit:** Native M-extension support (MUL, MULH, MULHSU, MULHU, DIV, DIVU, REM, REMU) with ~32-34 cycle latency per operation

---

## What is the M Extension?

The **M Extension** adds integer multiplication and division to RV32I:
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
