feaksel/5level-inverter/02-embedded/riscv-soc-vexrv/rtl/cpu/VexRiscv.v

// Generator : SpinalHDL v1.12.0    git head : 1aa7d7b5732f11cca2dd83bacc2a4cb92ca8e5c9
// Component : VexRiscv
// Git hash  : a5bfdc1f4c20adbce2d3ba9ad0974a4f65bbbf61

`timescale 1ns/1ps

module VexRiscv (
  output wire          iBus_cmd_valid,
  input  wire          iBus_cmd_ready,
  output wire [31:0]   iBus_cmd_payload_pc,
  input  wire          iBus_rsp_valid,
  input  wire          iBus_rsp_payload_error,
  input  wire [31:0]   iBus_rsp_payload_inst,
  input  wire          timerInterrupt,
  input  wire          externalInterrupt,
  input  wire          softwareInterrupt,
  output wire          dBus_cmd_valid,
  input  wire          dBus_cmd_ready,
  output wire          dBus_cmd_payload_wr,
  output wire [3:0]    dBus_cmd_payload_mask,
  output wire [31:0]   dBus_cmd_payload_address,
  output wire [31:0]   dBus_cmd_payload_data,
  output wire [1:0]    dBus_cmd_payload_size,
  input  wire          dBus_rsp_ready,
  input  wire          dBus_rsp_error,
  input  wire [31:0]   dBus_rsp_data,
  input  wire          clk,
  input  wire          reset
);
  localparam BranchCtrlEnum_INC = 2'd0;
  localparam BranchCtrlEnum_B = 2'd1;
  localparam BranchCtrlEnum_JAL = 2'd2;
  localparam BranchCtrlEnum_JALR = 2'd3;
  localparam ShiftCtrlEnum_DISABLE_1 = 2'd0;
  localparam ShiftCtrlEnum_SLL_1 = 2'd1;
  localparam ShiftCtrlEnum_SRL_1 = 2'd2;
  localparam ShiftCtrlEnum_SRA_1 = 2'd3;
  localparam AluBitwiseCtrlEnum_XOR_1 = 2'd0;
  localparam AluBitwiseCtrlEnum_OR_1 = 2'd1;
  localparam AluBitwiseCtrlEnum_AND_1 = 2'd2;
  localparam AluCtrlEnum_ADD_SUB = 2'd0;
  localparam AluCtrlEnum_SLT_SLTU = 2'd1;
  localparam AluCtrlEnum_BITWISE = 2'd2;
  localparam EnvCtrlEnum_NONE = 1'd0;
  localparam EnvCtrlEnum_XRET = 1'd1;
  localparam Src2CtrlEnum_RS = 2'd0;
  localparam Src2CtrlEnum_IMI = 2'd1;
  localparam Src2CtrlEnum_IMS = 2'd2;
  localparam Src2CtrlEnum_PC = 2'd3;
  localparam Src1CtrlEnum_RS = 2'd0;
  localparam Src1CtrlEnum_IMU = 2'd1;
  localparam Src1CtrlEnum_PC_INCREMENT = 2'd2;
  localparam Src1CtrlEnum_URS1 = 2'd3;

  wire                IBusSimplePlugin_rspJoin_rspBuffer_c_io_pop_ready;
  reg        [31:0]   RegFilePlugin_regFile_spinal_port0;
  reg        [31:0]   RegFilePlugin_regFile_spinal_port1;
  wire                IBusSimplePlugin_rspJoin_rspBuffer_c_io_push_ready;
  wire                IBusSimplePlugin_rspJoin_rspBuffer_c_io_pop_valid;
  wire                IBusSimplePlugin_rspJoin_rspBuffer_c_io_pop_payload_error;
  wire       [31:0]   IBusSimplePlugin_rspJoin_rspBuffer_c_io_pop_payload_inst;
  wire       [0:0]    IBusSimplePlugin_rspJoin_rspBuffer_c_io_occupancy;
  wire       [0:0]    IBusSimplePlugin_rspJoin_rspBuffer_c_io_availability;
  wire       [1:0]    _zz_IBusSimplePlugin_jump_pcLoad_payload_1;
  wire       [1:0]    _zz_IBusSimplePlugin_jump_pcLoad_payload_2;
  wire       [31:0]   _zz_IBusSimplePlugin_fetchPc_pc;
  wire       [2:0]    _zz_IBusSimplePlugin_fetchPc_pc_1;
  wire       [2:0]    _zz_IBusSimplePlugin_pending_next;
  wire       [2:0]    _zz_IBusSimplePlugin_pending_next_1;
  wire       [0:0]    _zz_IBusSimplePlugin_pending_next_2;
  wire       [2:0]    _zz_IBusSimplePlugin_pending_next_3;
  wire       [0:0]    _zz_IBusSimplePlugin_pending_next_4;
  wire       [2:0]    _zz_IBusSimplePlugin_rspJoin_rspBuffer_discardCounter;
  wire       [0:0]    _zz_IBusSimplePlugin_rspJoin_rspBuffer_discardCounter_1;
  wire       [2:0]    _zz_IBusSimplePlugin_rspJoin_rspBuffer_discardCounter_2;
  wire       [0:0]    _zz_IBusSimplePlugin_rspJoin_rspBuffer_discardCounter_3;
  wire       [31:0]   _zz__zz_decode_SRC_LESS_UNSIGNED;
  wire       [31:0]   _zz__zz_decode_SRC_LESS_UNSIGNED_1;
  wire       [31:0]   _zz__zz_decode_SRC_LESS_UNSIGNED_2;
  wire       [31:0]   _zz__zz_decode_SRC_LESS_UNSIGNED_3;
  wire                _zz__zz_decode_SRC_LESS_UNSIGNED_4;
  wire       [1:0]    _zz__zz_decode_SRC_LESS_UNSIGNED_5;
  wire       [31:0]   _zz__zz_decode_SRC_LESS_UNSIGNED_6;
  wire       [31:0]   _zz__zz_decode_SRC_LESS_UNSIGNED_7;
  wire       [31:0]   _zz__zz_decode_SRC_LESS_UNSIGNED_8;
  wire       [31:0]   _zz__zz_decode_SRC_LESS_UNSIGNED_9;
  wire                _zz__zz_decode_SRC_LESS_UNSIGNED_10;
  wire                _zz__zz_decode_SRC_LESS_UNSIGNED_11;
  wire                _zz__zz_decode_SRC_LESS_UNSIGNED_12;
  wire       [0:0]    _zz__zz_decode_SRC_LESS_UNSIGNED_13;
  wire                _zz__zz_decode_SRC_LESS_UNSIGNED_14;
  wire       [18:0]   _zz__zz_decode_SRC_LESS_UNSIGNED_15;
  wire       [0:0]    _zz__zz_decode_SRC_LESS_UNSIGNED_16;
  wire       [31:0]   _zz__zz_decode_SRC_LESS_UNSIGNED_17;
  wire                _zz__zz_decode_SRC_LESS_UNSIGNED_18;
  wire                _zz__zz_decode_SRC_LESS_UNSIGNED_19;
  wire                _zz__zz_decode_SRC_LESS_UNSIGNED_20;
  wire       [0:0]    _zz__zz_decode_SRC_LESS_UNSIGNED_21;
  wire       [0:0]    _zz__zz_decode_SRC_LESS_UNSIGNED_22;
  wire       [31:0]   _zz__zz_decode_SRC_LESS_UNSIGNED_23;
  wire       [0:0]    _zz__zz_decode_SRC_LESS_UNSIGNED_24;
  wire       [31:0]   _zz__zz_decode_SRC_LESS_UNSIGNED_25;
  wire       [15:0]   _zz__zz_decode_SRC_LESS_UNSIGNED_26;
  wire       [0:0]    _zz__zz_decode_SRC_LESS_UNSIGNED_27;
  wire                _zz__zz_decode_SRC_LESS_UNSIGNED_28;
  wire       [31:0]   _zz__zz_decode_SRC_LESS_UNSIGNED_29;
  wire       [31:0]   _zz__zz_decode_SRC_LESS_UNSIGNED_30;
  wire       [0:0]    _zz__zz_decode_SRC_LESS_UNSIGNED_31;
  wire       [0:0]    _zz__zz_decode_SRC_LESS_UNSIGNED_32;
  wire       [31:0]   _zz__zz_decode_SRC_LESS_UNSIGNED_33;
  wire       [0:0]    _zz__zz_decode_SRC_LESS_UNSIGNED_34;
  wire       [31:0]   _zz__zz_decode_SRC_LESS_UNSIGNED_35;
  wire       [12:0]   _zz__zz_decode_SRC_LESS_UNSIGNED_36;
  wire       [1:0]    _zz__zz_decode_SRC_LESS_UNSIGNED_37;
  wire       [31:0]   _zz__zz_decode_SRC_LESS_UNSIGNED_38;
  wire       [31:0]   _zz__zz_decode_SRC_LESS_UNSIGNED_39;
  wire       [31:0]   _zz__zz_decode_SRC_LESS_UNSIGNED_40;
  wire       [31:0]   _zz__zz_decode_SRC_LESS_UNSIGNED_41;
  wire                _zz__zz_decode_SRC_LESS_UNSIGNED_42;
  wire                _zz__zz_decode_SRC_LESS_UNSIGNED_43;
  wire       [0:0]    _zz__zz_decode_SRC_LESS_UNSIGNED_44;
  wire       [0:0]    _zz__zz_decode_SRC_LESS_UNSIGNED_45;
  wire       [31:0]   _zz__zz_decode_SRC_LESS_UNSIGNED_46;
  wire       [0:0]    _zz__zz_decode_SRC_LESS_UNSIGNED_47;
  wire                _zz__zz_decode_SRC_LESS_UNSIGNED_48;
  wire       [9:0]    _zz__zz_decode_SRC_LESS_UNSIGNED_49;
  wire       [0:0]    _zz__zz_decode_SRC_LESS_UNSIGNED_50;
  wire       [31:0]   _zz__zz_decode_SRC_LESS_UNSIGNED_51;
  wire                _zz__zz_decode_SRC_LESS_UNSIGNED_52;
  wire       [0:0]    _zz__zz_decode_SRC_LESS_UNSIGNED_53;
  wire       [0:0]    _zz__zz_decode_SRC_LESS_UNSIGNED_54;
  wire       [4:0]    _zz__zz_decode_SRC_LESS_UNSIGNED_55;
  wire       [31:0]   _zz__zz_decode_SRC_LESS_UNSIGNED_56;
  wire       [31:0]   _zz__zz_decode_SRC_LESS_UNSIGNED_57;
  wire                _zz__zz_decode_SRC_LESS_UNSIGNED_58;
  wire       [0:0]    _zz__zz_decode_SRC_LESS_UNSIGNED_59;
  wire       [1:0]    _zz__zz_decode_SRC_LESS_UNSIGNED_60;
  wire       [31:0]   _zz__zz_decode_SRC_LESS_UNSIGNED_61;
  wire       [31:0]   _zz__zz_decode_SRC_LESS_UNSIGNED_62;
  wire       [31:0]   _zz__zz_decode_SRC_LESS_UNSIGNED_63;
  wire       [31:0]   _zz__zz_decode_SRC_LESS_UNSIGNED_64;
  wire       [6:0]    _zz__zz_decode_SRC_LESS_UNSIGNED_65;
  wire       [1:0]    _zz__zz_decode_SRC_LESS_UNSIGNED_66;
  wire       [31:0]   _zz__zz_decode_SRC_LESS_UNSIGNED_67;
  wire       [31:0]   _zz__zz_decode_SRC_LESS_UNSIGNED_68;
  wire                _zz__zz_decode_SRC_LESS_UNSIGNED_69;
  wire                _zz__zz_decode_SRC_LESS_UNSIGNED_70;
  wire       [0:0]    _zz__zz_decode_SRC_LESS_UNSIGNED_71;
  wire       [0:0]    _zz__zz_decode_SRC_LESS_UNSIGNED_72;
  wire       [31:0]   _zz__zz_decode_SRC_LESS_UNSIGNED_73;
  wire       [2:0]    _zz__zz_decode_SRC_LESS_UNSIGNED_74;
  wire                _zz__zz_decode_SRC_LESS_UNSIGNED_75;
  wire       [3:0]    _zz__zz_decode_SRC_LESS_UNSIGNED_76;
  wire       [0:0]    _zz__zz_decode_SRC_LESS_UNSIGNED_77;
  wire       [31:0]   _zz__zz_decode_SRC_LESS_UNSIGNED_78;
  wire                _zz__zz_decode_SRC_LESS_UNSIGNED_79;
  wire                _zz__zz_decode_SRC_LESS_UNSIGNED_80;
  wire       [0:0]    _zz__zz_decode_SRC_LESS_UNSIGNED_81;
  wire       [0:0]    _zz__zz_decode_SRC_LESS_UNSIGNED_82;
  wire       [0:0]    _zz__zz_decode_SRC_LESS_UNSIGNED_83;
  wire       [0:0]    _zz__zz_decode_SRC_LESS_UNSIGNED_84;
  wire       [0:0]    _zz__zz_decode_SRC_LESS_UNSIGNED_85;
  wire       [0:0]    _zz__zz_decode_SRC_LESS_UNSIGNED_86;
  wire       [0:0]    _zz__zz_decode_SRC_LESS_UNSIGNED_87;
  wire       [0:0]    _zz__zz_decode_SRC_LESS_UNSIGNED_88;
  wire                _zz_RegFilePlugin_regFile_port;
  wire                _zz_decode_RegFilePlugin_rs1Data;
  wire                _zz_RegFilePlugin_regFile_port_1;
  wire                _zz_decode_RegFilePlugin_rs2Data;
  wire       [0:0]    _zz__zz_execute_REGFILE_WRITE_DATA;
  wire       [2:0]    _zz__zz_execute_SRC1;
  wire       [4:0]    _zz__zz_execute_SRC1_1;
  wire       [11:0]   _zz__zz_execute_SRC2_2;
  wire       [31:0]   _zz_execute_SrcPlugin_addSub;
  wire       [31:0]   _zz_execute_SrcPlugin_addSub_1;
  wire       [31:0]   _zz_execute_SrcPlugin_addSub_2;
  wire       [31:0]   _zz_execute_SrcPlugin_addSub_3;
  wire       [31:0]   _zz_execute_SrcPlugin_addSub_4;
  wire       [31:0]   _zz__zz_decode_RS2_3;
  wire       [32:0]   _zz__zz_decode_RS2_3_1;
  wire       [19:0]   _zz__zz_execute_BranchPlugin_branch_src2;
  wire       [11:0]   _zz__zz_execute_BranchPlugin_branch_src2_4;
  wire       [31:0]   memory_MEMORY_READ_DATA;
  wire       [31:0]   execute_BRANCH_CALC;
  wire                execute_BRANCH_DO;
  wire       [31:0]   writeBack_REGFILE_WRITE_DATA;
  wire       [31:0]   execute_REGFILE_WRITE_DATA;
  wire       [1:0]    memory_MEMORY_ADDRESS_LOW;
  wire       [1:0]    execute_MEMORY_ADDRESS_LOW;
  wire                decode_SRC2_FORCE_ZERO;
  wire       [1:0]    decode_BRANCH_CTRL;
  wire       [1:0]    _zz_decode_BRANCH_CTRL;
  wire       [1:0]    _zz_decode_to_execute_BRANCH_CTRL;
  wire       [1:0]    _zz_decode_to_execute_BRANCH_CTRL_1;
  wire       [1:0]    decode_SHIFT_CTRL;
  wire       [1:0]    _zz_decode_SHIFT_CTRL;
  wire       [1:0]    _zz_decode_to_execute_SHIFT_CTRL;
  wire       [1:0]    _zz_decode_to_execute_SHIFT_CTRL_1;
  wire       [1:0]    decode_ALU_BITWISE_CTRL;
  wire       [1:0]    _zz_decode_ALU_BITWISE_CTRL;
  wire       [1:0]    _zz_decode_to_execute_ALU_BITWISE_CTRL;
  wire       [1:0]    _zz_decode_to_execute_ALU_BITWISE_CTRL_1;
  wire                decode_SRC_LESS_UNSIGNED;
  wire       [1:0]    decode_ALU_CTRL;
  wire       [1:0]    _zz_decode_ALU_CTRL;
  wire       [1:0]    _zz_decode_to_execute_ALU_CTRL;
  wire       [1:0]    _zz_decode_to_execute_ALU_CTRL_1;
  wire       [0:0]    _zz_memory_to_writeBack_ENV_CTRL;
  wire       [0:0]    _zz_memory_to_writeBack_ENV_CTRL_1;
  wire       [0:0]    _zz_execute_to_memory_ENV_CTRL;
  wire       [0:0]    _zz_execute_to_memory_ENV_CTRL_1;
  wire       [0:0]    decode_ENV_CTRL;
  wire       [0:0]    _zz_decode_ENV_CTRL;
  wire       [0:0]    _zz_decode_to_execute_ENV_CTRL;
  wire       [0:0]    _zz_decode_to_execute_ENV_CTRL_1;
  wire                decode_IS_CSR;
  wire                decode_MEMORY_STORE;
  wire                execute_BYPASSABLE_MEMORY_STAGE;
  wire                decode_BYPASSABLE_MEMORY_STAGE;
  wire                decode_BYPASSABLE_EXECUTE_STAGE;
  wire       [1:0]    decode_SRC2_CTRL;
  wire       [1:0]    _zz_decode_SRC2_CTRL;
  wire       [1:0]    _zz_decode_to_execute_SRC2_CTRL;
  wire       [1:0]    _zz_decode_to_execute_SRC2_CTRL_1;
  wire                decode_MEMORY_ENABLE;
  wire       [1:0]    decode_SRC1_CTRL;
  wire       [1:0]    _zz_decode_SRC1_CTRL;
  wire       [1:0]    _zz_decode_to_execute_SRC1_CTRL;
  wire       [1:0]    _zz_decode_to_execute_SRC1_CTRL_1;
  wire                decode_CSR_READ_OPCODE;
  wire                decode_CSR_WRITE_OPCODE;
  wire       [31:0]   writeBack_FORMAL_PC_NEXT;
  wire       [31:0]   memory_FORMAL_PC_NEXT;
  wire       [31:0]   execute_FORMAL_PC_NEXT;
  wire       [31:0]   decode_FORMAL_PC_NEXT;
  wire       [31:0]   memory_PC;
  wire       [31:0]   memory_BRANCH_CALC;
  wire                memory_BRANCH_DO;
  wire       [31:0]   execute_PC;
  wire       [31:0]   execute_RS1;
  wire       [1:0]    execute_BRANCH_CTRL;
  wire       [1:0]    _zz_execute_BRANCH_CTRL;
  wire                decode_RS2_USE;
  wire                decode_RS1_USE;
  wire                execute_REGFILE_WRITE_VALID;
  wire                execute_BYPASSABLE_EXECUTE_STAGE;
  wire       [31:0]   _zz_decode_RS2;
  wire                memory_REGFILE_WRITE_VALID;
  wire       [31:0]   memory_INSTRUCTION;
  wire                memory_BYPASSABLE_MEMORY_STAGE;
  wire                writeBack_REGFILE_WRITE_VALID;
  reg        [31:0]   decode_RS2;
  reg        [31:0]   decode_RS1;
  wire       [31:0]   memory_REGFILE_WRITE_DATA;
  wire       [1:0]    execute_SHIFT_CTRL;
  wire       [1:0]    _zz_execute_SHIFT_CTRL;
  wire                execute_SRC_LESS_UNSIGNED;
  wire                execute_SRC2_FORCE_ZERO;
  wire                execute_SRC_USE_SUB_LESS;
  wire       [31:0]   _zz_execute_to_memory_PC;
  wire       [1:0]    execute_SRC2_CTRL;
  wire       [1:0]    _zz_execute_SRC2_CTRL;
  wire       [1:0]    execute_SRC1_CTRL;
  wire       [1:0]    _zz_execute_SRC1_CTRL;
  wire                decode_SRC_USE_SUB_LESS;
  wire                decode_SRC_ADD_ZERO;
  wire       [31:0]   execute_SRC_ADD_SUB;
  wire                execute_SRC_LESS;
  wire       [1:0]    execute_ALU_CTRL;
  wire       [1:0]    _zz_execute_ALU_CTRL;
  wire       [31:0]   execute_SRC2;
  wire       [1:0]    execute_ALU_BITWISE_CTRL;
  wire       [1:0]    _zz_execute_ALU_BITWISE_CTRL;
  wire       [31:0]   _zz_lastStageRegFileWrite_payload_address;
  wire                _zz_lastStageRegFileWrite_valid;
  reg                 _zz_1;
  wire       [31:0]   decode_INSTRUCTION_ANTICIPATED;
  reg                 decode_REGFILE_WRITE_VALID;
  wire       [1:0]    _zz_decode_BRANCH_CTRL_1;
  wire       [1:0]    _zz_decode_SHIFT_CTRL_1;
  wire       [1:0]    _zz_decode_ALU_BITWISE_CTRL_1;
  wire       [1:0]    _zz_decode_ALU_CTRL_1;
  wire       [0:0]    _zz_decode_ENV_CTRL_1;
  wire       [1:0]    _zz_decode_SRC2_CTRL_1;
  wire       [1:0]    _zz_decode_SRC1_CTRL_1;
  reg        [31:0]   _zz_decode_RS2_1;
  wire       [31:0]   execute_SRC1;
  wire                execute_CSR_READ_OPCODE;
  wire                execute_CSR_WRITE_OPCODE;
  wire                execute_IS_CSR;
  wire       [0:0]    memory_ENV_CTRL;
  wire       [0:0]    _zz_memory_ENV_CTRL;
  wire       [0:0]    execute_ENV_CTRL;
  wire       [0:0]    _zz_execute_ENV_CTRL;
  wire       [0:0]    writeBack_ENV_CTRL;
  wire       [0:0]    _zz_writeBack_ENV_CTRL;
  reg        [31:0]   _zz_decode_RS2_2;
  wire                writeBack_MEMORY_ENABLE;
  wire       [1:0]    writeBack_MEMORY_ADDRESS_LOW;
  wire       [31:0]   writeBack_MEMORY_READ_DATA;
  wire                memory_MEMORY_STORE;
  wire                memory_MEMORY_ENABLE;
  wire       [31:0]   execute_SRC_ADD;
  wire       [31:0]   execute_RS2;
  wire       [31:0]   execute_INSTRUCTION;
  wire                execute_MEMORY_STORE;
  wire                execute_MEMORY_ENABLE;
  wire                execute_ALIGNEMENT_FAULT;
  reg        [31:0]   _zz_memory_to_writeBack_FORMAL_PC_NEXT;
  wire       [31:0]   decode_PC;
  wire       [31:0]   decode_INSTRUCTION;
  wire       [31:0]   writeBack_PC;
  wire       [31:0]   writeBack_INSTRUCTION;
  wire                decode_arbitration_haltItself;
  reg                 decode_arbitration_haltByOther;
  reg                 decode_arbitration_removeIt;
  wire                decode_arbitration_flushIt;
  wire                decode_arbitration_flushNext;
  reg                 decode_arbitration_isValid;
  wire                decode_arbitration_isStuck;
  wire                decode_arbitration_isStuckByOthers;
  wire                decode_arbitration_isFlushed;
  wire                decode_arbitration_isMoving;
  wire                decode_arbitration_isFiring;
  reg                 execute_arbitration_haltItself;
  wire                execute_arbitration_haltByOther;
  reg                 execute_arbitration_removeIt;
  wire                execute_arbitration_flushIt;
  wire                execute_arbitration_flushNext;
  reg                 execute_arbitration_isValid;
  wire                execute_arbitration_isStuck;
  wire                execute_arbitration_isStuckByOthers;
  wire                execute_arbitration_isFlushed;
  wire                execute_arbitration_isMoving;
  wire                execute_arbitration_isFiring;
  reg                 memory_arbitration_haltItself;
  wire                memory_arbitration_haltByOther;
  reg                 memory_arbitration_removeIt;
  wire                memory_arbitration_flushIt;
  reg                 memory_arbitration_flushNext;
  reg                 memory_arbitration_isValid;
  wire                memory_arbitration_isStuck;
  wire                memory_arbitration_isStuckByOthers;
  wire                memory_arbitration_isFlushed;
  wire                memory_arbitration_isMoving;
  wire                memory_arbitration_isFiring;
  wire                writeBack_arbitration_haltItself;
  wire                writeBack_arbitration_haltByOther;
  reg                 writeBack_arbitration_removeIt;
  wire                writeBack_arbitration_flushIt;
  reg                 writeBack_arbitration_flushNext;
  reg                 writeBack_arbitration_isValid;
  wire                writeBack_arbitration_isStuck;
  wire                writeBack_arbitration_isStuckByOthers;
  wire                writeBack_arbitration_isFlushed;
  wire                writeBack_arbitration_isMoving;
  wire                writeBack_arbitration_isFiring;
  wire       [31:0]   lastStageInstruction /* verilator public */ ;
  wire       [31:0]   lastStagePc /* verilator public */ ;
  wire                lastStageIsValid /* verilator public */ ;
  wire                lastStageIsFiring /* verilator public */ ;
  reg                 IBusSimplePlugin_fetcherHalt;
  wire                IBusSimplePlugin_forceNoDecodeCond;
  reg                 IBusSimplePlugin_incomingInstruction;
  wire                IBusSimplePlugin_pcValids_0;
  wire                IBusSimplePlugin_pcValids_1;
  wire                IBusSimplePlugin_pcValids_2;
  wire                IBusSimplePlugin_pcValids_3;
  wire       [31:0]   CsrPlugin_csrMapping_readDataSignal;
  wire       [31:0]   CsrPlugin_csrMapping_readDataInit;
  wire       [31:0]   CsrPlugin_csrMapping_writeDataSignal;
  reg                 CsrPlugin_csrMapping_allowCsrSignal;
  wire                CsrPlugin_csrMapping_hazardFree;
  wire                CsrPlugin_csrMapping_doForceFailCsr;
  wire                CsrPlugin_inWfi /* verilator public */ ;
  wire                CsrPlugin_thirdPartyWake;
  reg                 CsrPlugin_jumpInterface_valid;
  reg        [31:0]   CsrPlugin_jumpInterface_payload;
  wire                CsrPlugin_exceptionPendings_0;
  wire                CsrPlugin_exceptionPendings_1;
  wire                CsrPlugin_exceptionPendings_2;
  wire                CsrPlugin_exceptionPendings_3;
  wire                contextSwitching;
  reg        [1:0]    CsrPlugin_privilege;
  wire                CsrPlugin_forceMachineWire;
  wire                CsrPlugin_allowInterrupts;
  wire                CsrPlugin_allowException;
  wire                CsrPlugin_allowEbreakException;
  wire                CsrPlugin_xretAwayFromMachine;
  wire                BranchPlugin_jumpInterface_valid;
  wire       [31:0]   BranchPlugin_jumpInterface_payload;
  wire                BranchPlugin_inDebugNoFetchFlag;
  wire                IBusSimplePlugin_externalFlush;
  wire                IBusSimplePlugin_jump_pcLoad_valid;
  wire       [31:0]   IBusSimplePlugin_jump_pcLoad_payload;
  wire       [1:0]    _zz_IBusSimplePlugin_jump_pcLoad_payload;
  wire                IBusSimplePlugin_fetchPc_output_valid;
  wire                IBusSimplePlugin_fetchPc_output_ready;
  wire       [31:0]   IBusSimplePlugin_fetchPc_output_payload;
  reg        [31:0]   IBusSimplePlugin_fetchPc_pcReg /* verilator public */ ;
  reg                 IBusSimplePlugin_fetchPc_correction;
  reg                 IBusSimplePlugin_fetchPc_correctionReg;
  wire                IBusSimplePlugin_fetchPc_output_fire;
  wire                IBusSimplePlugin_fetchPc_corrected;
  reg                 IBusSimplePlugin_fetchPc_pcRegPropagate;
  reg                 IBusSimplePlugin_fetchPc_booted;
  reg                 IBusSimplePlugin_fetchPc_inc;
  wire                when_Fetcher_l133;
  wire                when_Fetcher_l133_1;
  reg        [31:0]   IBusSimplePlugin_fetchPc_pc;
  reg                 IBusSimplePlugin_fetchPc_flushed;
  wire                when_Fetcher_l160;
  wire                IBusSimplePlugin_iBusRsp_redoFetch;
  wire                IBusSimplePlugin_iBusRsp_stages_0_input_valid;
  wire                IBusSimplePlugin_iBusRsp_stages_0_input_ready;
  wire       [31:0]   IBusSimplePlugin_iBusRsp_stages_0_input_payload;
  wire                IBusSimplePlugin_iBusRsp_stages_0_output_valid;
  wire                IBusSimplePlugin_iBusRsp_stages_0_output_ready;
  wire       [31:0]   IBusSimplePlugin_iBusRsp_stages_0_output_payload;
  reg                 IBusSimplePlugin_iBusRsp_stages_0_halt;
  wire                IBusSimplePlugin_iBusRsp_stages_1_input_valid;
  wire                IBusSimplePlugin_iBusRsp_stages_1_input_ready;
  wire       [31:0]   IBusSimplePlugin_iBusRsp_stages_1_input_payload;
  wire                IBusSimplePlugin_iBusRsp_stages_1_output_valid;
  wire                IBusSimplePlugin_iBusRsp_stages_1_output_ready;
  wire       [31:0]   IBusSimplePlugin_iBusRsp_stages_1_output_payload;
  wire                IBusSimplePlugin_iBusRsp_stages_1_halt;
  wire                _zz_IBusSimplePlugin_iBusRsp_stages_0_input_ready;
  wire                IBusSimplePlugin_iBusRsp_stages_0_input_haltWhen_valid;
  wire                IBusSimplePlugin_iBusRsp_stages_0_input_haltWhen_ready;
  wire       [31:0]   IBusSimplePlugin_iBusRsp_stages_0_input_haltWhen_payload;
  wire                _zz_IBusSimplePlugin_iBusRsp_stages_1_input_ready;
  wire                IBusSimplePlugin_iBusRsp_stages_1_input_haltWhen_valid;
  wire                IBusSimplePlugin_iBusRsp_stages_1_input_haltWhen_ready;
  wire       [31:0]   IBusSimplePlugin_iBusRsp_stages_1_input_haltWhen_payload;
  wire                IBusSimplePlugin_iBusRsp_flush;
  wire                IBusSimplePlugin_iBusRsp_stages_0_output_toEvent_valid;
  wire                IBusSimplePlugin_iBusRsp_stages_0_output_toEvent_ready;
  wire                IBusSimplePlugin_iBusRsp_stages_0_output_toEvent_m2sPipe_valid;
  wire                IBusSimplePlugin_iBusRsp_stages_0_output_toEvent_m2sPipe_ready;
  reg                 _zz_IBusSimplePlugin_iBusRsp_stages_0_output_toEvent_m2sPipe_valid;
  reg                 IBusSimplePlugin_iBusRsp_readyForError;
  wire                IBusSimplePlugin_iBusRsp_output_valid;
  wire                IBusSimplePlugin_iBusRsp_output_ready;
  wire       [31:0]   IBusSimplePlugin_iBusRsp_output_payload_pc;
  wire                IBusSimplePlugin_iBusRsp_output_payload_rsp_error;
  wire       [31:0]   IBusSimplePlugin_iBusRsp_output_payload_rsp_inst;
  wire                IBusSimplePlugin_iBusRsp_output_payload_isRvc;
  wire                IBusSimplePlugin_injector_decodeInput_valid;
  wire                IBusSimplePlugin_injector_decodeInput_ready;
  wire       [31:0]   IBusSimplePlugin_injector_decodeInput_payload_pc;
  wire                IBusSimplePlugin_injector_decodeInput_payload_rsp_error;
  wire       [31:0]   IBusSimplePlugin_injector_decodeInput_payload_rsp_inst;
  wire                IBusSimplePlugin_injector_decodeInput_payload_isRvc;
  reg                 _zz_IBusSimplePlugin_injector_decodeInput_valid;
  reg        [31:0]   _zz_IBusSimplePlugin_injector_decodeInput_payload_pc;
  reg                 _zz_IBusSimplePlugin_injector_decodeInput_payload_rsp_error;
  reg        [31:0]   _zz_IBusSimplePlugin_injector_decodeInput_payload_rsp_inst;
  reg                 _zz_IBusSimplePlugin_injector_decodeInput_payload_isRvc;
  wire                when_Fetcher_l322;
  reg                 IBusSimplePlugin_injector_nextPcCalc_valids_0;
  wire                when_Fetcher_l331;
  reg                 IBusSimplePlugin_injector_nextPcCalc_valids_1;
  wire                when_Fetcher_l331_1;
  reg                 IBusSimplePlugin_injector_nextPcCalc_valids_2;
  wire                when_Fetcher_l331_2;
  reg                 IBusSimplePlugin_injector_nextPcCalc_valids_3;
  wire                when_Fetcher_l331_3;
  reg                 IBusSimplePlugin_injector_nextPcCalc_valids_4;
  wire                when_Fetcher_l331_4;
  reg        [31:0]   IBusSimplePlugin_injector_formal_rawInDecode;
  wire                IBusSimplePlugin_cmd_valid;
  wire                IBusSimplePlugin_cmd_ready;
  wire       [31:0]   IBusSimplePlugin_cmd_payload_pc;
  wire                IBusSimplePlugin_pending_inc;
  wire                IBusSimplePlugin_pending_dec;
  reg        [2:0]    IBusSimplePlugin_pending_value;
  wire       [2:0]    IBusSimplePlugin_pending_next;
  wire                IBusSimplePlugin_cmdFork_canEmit;
  wire                when_IBusSimplePlugin_l306;
  wire                IBusSimplePlugin_cmd_fire;
  wire                IBusSimplePlugin_rspJoin_rspBuffer_output_valid;
  wire                IBusSimplePlugin_rspJoin_rspBuffer_output_ready;
  wire                IBusSimplePlugin_rspJoin_rspBuffer_output_payload_error;
  wire       [31:0]   IBusSimplePlugin_rspJoin_rspBuffer_output_payload_inst;
  reg        [2:0]    IBusSimplePlugin_rspJoin_rspBuffer_discardCounter;
  wire                iBus_rsp_toStream_valid;
  wire                iBus_rsp_toStream_ready;
  wire                iBus_rsp_toStream_payload_error;
  wire       [31:0]   iBus_rsp_toStream_payload_inst;
  wire                IBusSimplePlugin_rspJoin_rspBuffer_flush;
  wire                io_pop_fire;
  wire       [31:0]   IBusSimplePlugin_rspJoin_fetchRsp_pc;
  reg                 IBusSimplePlugin_rspJoin_fetchRsp_rsp_error;
  wire       [31:0]   IBusSimplePlugin_rspJoin_fetchRsp_rsp_inst;
  wire                IBusSimplePlugin_rspJoin_fetchRsp_isRvc;
  wire                when_IBusSimplePlugin_l378;
  wire                IBusSimplePlugin_rspJoin_join_valid;
  wire                IBusSimplePlugin_rspJoin_join_ready;
  wire       [31:0]   IBusSimplePlugin_rspJoin_join_payload_pc;
  wire                IBusSimplePlugin_rspJoin_join_payload_rsp_error;
  wire       [31:0]   IBusSimplePlugin_rspJoin_join_payload_rsp_inst;
  wire                IBusSimplePlugin_rspJoin_join_payload_isRvc;
  wire                IBusSimplePlugin_rspJoin_exceptionDetected;
  wire                IBusSimplePlugin_rspJoin_join_fire;
  wire                _zz_IBusSimplePlugin_rspJoin_join_ready;
  wire                IBusSimplePlugin_rspJoin_join_haltWhen_valid;
  wire                IBusSimplePlugin_rspJoin_join_haltWhen_ready;
  wire       [31:0]   IBusSimplePlugin_rspJoin_join_haltWhen_payload_pc;
  wire                IBusSimplePlugin_rspJoin_join_haltWhen_payload_rsp_error;
  wire       [31:0]   IBusSimplePlugin_rspJoin_join_haltWhen_payload_rsp_inst;
  wire                IBusSimplePlugin_rspJoin_join_haltWhen_payload_isRvc;
  wire                _zz_dBus_cmd_valid;
  reg                 execute_DBusSimplePlugin_skipCmd;
  reg        [31:0]   _zz_dBus_cmd_payload_data;
  wire                when_DBusSimplePlugin_l435;
  reg        [3:0]    _zz_execute_DBusSimplePlugin_formalMask;
  wire       [3:0]    execute_DBusSimplePlugin_formalMask;
  wire                when_DBusSimplePlugin_l490;
  reg        [31:0]   writeBack_DBusSimplePlugin_rspShifted;
  wire       [1:0]    switch_Misc_l245;
  wire                _zz_writeBack_DBusSimplePlugin_rspFormated;
  reg        [31:0]   _zz_writeBack_DBusSimplePlugin_rspFormated_1;
  wire                _zz_writeBack_DBusSimplePlugin_rspFormated_2;
  reg        [31:0]   _zz_writeBack_DBusSimplePlugin_rspFormated_3;
  reg        [31:0]   writeBack_DBusSimplePlugin_rspFormated;
  wire                when_DBusSimplePlugin_l566;
  wire       [1:0]    CsrPlugin_misa_base;
  wire       [25:0]   CsrPlugin_misa_extensions;
  wire       [1:0]    CsrPlugin_mtvec_mode;
  wire       [29:0]   CsrPlugin_mtvec_base;
  reg        [31:0]   CsrPlugin_mepc;
  reg                 CsrPlugin_mstatus_MIE;
  reg                 CsrPlugin_mstatus_MPIE;
  reg        [1:0]    CsrPlugin_mstatus_MPP;
  reg                 CsrPlugin_mip_MEIP;
  reg                 CsrPlugin_mip_MTIP;
  reg                 CsrPlugin_mip_MSIP;
  reg                 CsrPlugin_mie_MEIE;
  reg                 CsrPlugin_mie_MTIE;
  reg                 CsrPlugin_mie_MSIE;
  reg                 CsrPlugin_mcause_interrupt;
  reg        [3:0]    CsrPlugin_mcause_exceptionCode;
  reg        [31:0]   CsrPlugin_mtval;
  reg        [63:0]   CsrPlugin_mcycle;
  reg        [63:0]   CsrPlugin_minstret;
  wire                _zz_when_CsrPlugin_l1302;
  wire                _zz_when_CsrPlugin_l1302_1;
  wire                _zz_when_CsrPlugin_l1302_2;
  reg                 CsrPlugin_interrupt_valid;
  reg        [3:0]    CsrPlugin_interrupt_code /* verilator public */ ;
  reg        [1:0]    CsrPlugin_interrupt_targetPrivilege;
  wire                when_CsrPlugin_l1296;
  wire                when_CsrPlugin_l1302;
  wire                when_CsrPlugin_l1302_1;
  wire                when_CsrPlugin_l1302_2;
  wire                CsrPlugin_exception;
  wire                CsrPlugin_lastStageWasWfi;
  reg                 CsrPlugin_pipelineLiberator_pcValids_0;
  reg                 CsrPlugin_pipelineLiberator_pcValids_1;
  reg                 CsrPlugin_pipelineLiberator_pcValids_2;
  wire                CsrPlugin_pipelineLiberator_active;
  wire                when_CsrPlugin_l1335;
  wire                when_CsrPlugin_l1335_1;
  wire                when_CsrPlugin_l1335_2;
  wire                when_CsrPlugin_l1340;
  reg                 CsrPlugin_pipelineLiberator_done;
  wire                CsrPlugin_interruptJump /* verilator public */ ;
  reg                 CsrPlugin_hadException /* verilator public */ ;
  wire       [1:0]    CsrPlugin_targetPrivilege;
  wire       [3:0]    CsrPlugin_trapCause;
  wire                CsrPlugin_trapCauseEbreakDebug;
  reg        [1:0]    CsrPlugin_xtvec_mode;
  reg        [29:0]   CsrPlugin_xtvec_base;
  wire                CsrPlugin_trapEnterDebug;
  wire                when_CsrPlugin_l1390;
  wire                when_CsrPlugin_l1398;
  wire                when_CsrPlugin_l1456;
  wire       [1:0]    switch_CsrPlugin_l1460;
  reg                 execute_CsrPlugin_wfiWake;
  wire                when_CsrPlugin_l1527;
  wire                execute_CsrPlugin_blockedBySideEffects;
  reg                 execute_CsrPlugin_illegalAccess;
  reg                 execute_CsrPlugin_illegalInstruction;
  wire                when_CsrPlugin_l1547;
  wire                when_CsrPlugin_l1548;
  reg                 execute_CsrPlugin_writeInstruction;
  reg                 execute_CsrPlugin_readInstruction;
  wire                execute_CsrPlugin_writeEnable;
  wire                execute_CsrPlugin_readEnable;
  wire       [31:0]   execute_CsrPlugin_readToWriteData;
  wire                switch_Misc_l245_1;
  reg        [31:0]   _zz_CsrPlugin_csrMapping_writeDataSignal;
  wire                when_CsrPlugin_l1587;
  wire                when_CsrPlugin_l1591;
  wire       [11:0]   execute_CsrPlugin_csrAddress;
  wire       [24:0]   _zz_decode_SRC_LESS_UNSIGNED;
  wire                _zz_decode_SRC_LESS_UNSIGNED_1;
  wire                _zz_decode_SRC_LESS_UNSIGNED_2;
  wire                _zz_decode_SRC_LESS_UNSIGNED_3;
  wire                _zz_decode_SRC_LESS_UNSIGNED_4;
  wire                _zz_decode_SRC_LESS_UNSIGNED_5;
  wire                _zz_decode_SRC_LESS_UNSIGNED_6;
  wire       [1:0]    _zz_decode_SRC1_CTRL_2;
  wire       [1:0]    _zz_decode_SRC2_CTRL_2;
  wire       [0:0]    _zz_decode_ENV_CTRL_2;
  wire       [1:0]    _zz_decode_ALU_CTRL_2;
  wire       [1:0]    _zz_decode_ALU_BITWISE_CTRL_2;
  wire       [1:0]    _zz_decode_SHIFT_CTRL_2;
  wire       [1:0]    _zz_decode_BRANCH_CTRL_2;
  wire                when_RegFilePlugin_l63;
  wire       [4:0]    decode_RegFilePlugin_regFileReadAddress1;
  wire       [4:0]    decode_RegFilePlugin_regFileReadAddress2;
  wire       [31:0]   decode_RegFilePlugin_rs1Data;
  wire       [31:0]   decode_RegFilePlugin_rs2Data;
  reg                 lastStageRegFileWrite_valid /* verilator public */ ;
  reg        [4:0]    lastStageRegFileWrite_payload_address /* verilator public */ ;
  reg        [31:0]   lastStageRegFileWrite_payload_data /* verilator public */ ;
  reg                 _zz_5;
  reg        [31:0]   execute_IntAluPlugin_bitwise;
  reg        [31:0]   _zz_execute_REGFILE_WRITE_DATA;
  reg        [31:0]   _zz_execute_SRC1;
  wire                _zz_execute_SRC2;
  reg        [19:0]   _zz_execute_SRC2_1;
  wire                _zz_execute_SRC2_2;
  reg        [19:0]   _zz_execute_SRC2_3;
  reg        [31:0]   _zz_execute_SRC2_4;
  reg        [31:0]   execute_SrcPlugin_addSub;
  wire                execute_SrcPlugin_less;
  reg                 execute_LightShifterPlugin_isActive;
  wire                execute_LightShifterPlugin_isShift;
  reg        [4:0]    execute_LightShifterPlugin_amplitudeReg;
  wire       [4:0]    execute_LightShifterPlugin_amplitude;
  wire       [31:0]   execute_LightShifterPlugin_shiftInput;
  wire                execute_LightShifterPlugin_done;
  wire                when_ShiftPlugins_l169;
  reg        [31:0]   _zz_decode_RS2_3;
  wire                when_ShiftPlugins_l175;
  wire                when_ShiftPlugins_l184;
  reg                 HazardSimplePlugin_src0Hazard;
  reg                 HazardSimplePlugin_src1Hazard;
  wire                HazardSimplePlugin_writeBackWrites_valid;
  wire       [4:0]    HazardSimplePlugin_writeBackWrites_payload_address;
  wire       [31:0]   HazardSimplePlugin_writeBackWrites_payload_data;
  reg                 HazardSimplePlugin_writeBackBuffer_valid;
  reg        [4:0]    HazardSimplePlugin_writeBackBuffer_payload_address;
  reg        [31:0]   HazardSimplePlugin_writeBackBuffer_payload_data;
  wire                HazardSimplePlugin_addr0Match;
  wire                HazardSimplePlugin_addr1Match;
  wire                when_HazardSimplePlugin_l47;
  wire                when_HazardSimplePlugin_l48;
  wire                when_HazardSimplePlugin_l51;
  wire                when_HazardSimplePlugin_l45;
  wire                when_HazardSimplePlugin_l57;
  wire                when_HazardSimplePlugin_l58;
  wire                when_HazardSimplePlugin_l48_1;
  wire                when_HazardSimplePlugin_l51_1;
  wire                when_HazardSimplePlugin_l45_1;
  wire                when_HazardSimplePlugin_l57_1;
  wire                when_HazardSimplePlugin_l58_1;
  wire                when_HazardSimplePlugin_l48_2;
  wire                when_HazardSimplePlugin_l51_2;
  wire                when_HazardSimplePlugin_l45_2;
  wire                when_HazardSimplePlugin_l57_2;
  wire                when_HazardSimplePlugin_l58_2;
  wire                when_HazardSimplePlugin_l105;
  wire                when_HazardSimplePlugin_l108;
  wire                when_HazardSimplePlugin_l113;
  wire                execute_BranchPlugin_eq;
  wire       [2:0]    switch_Misc_l245_2;
  reg                 _zz_execute_BRANCH_DO;
  reg                 _zz_execute_BRANCH_DO_1;
  wire       [31:0]   execute_BranchPlugin_branch_src1;
  wire                _zz_execute_BranchPlugin_branch_src2;
  reg        [10:0]   _zz_execute_BranchPlugin_branch_src2_1;
  wire                _zz_execute_BranchPlugin_branch_src2_2;
  reg        [19:0]   _zz_execute_BranchPlugin_branch_src2_3;
  wire                _zz_execute_BranchPlugin_branch_src2_4;
  reg        [18:0]   _zz_execute_BranchPlugin_branch_src2_5;
  reg        [31:0]   _zz_execute_BranchPlugin_branch_src2_6;
  wire       [31:0]   execute_BranchPlugin_branch_src2;
  wire       [31:0]   execute_BranchPlugin_branchAdder;
  wire                when_Pipeline_l124;
  reg        [31:0]   decode_to_execute_PC;
  wire                when_Pipeline_l124_1;
  reg        [31:0]   execute_to_memory_PC;
  wire                when_Pipeline_l124_2;
  reg        [31:0]   memory_to_writeBack_PC;
  wire                when_Pipeline_l124_3;
  reg        [31:0]   decode_to_execute_INSTRUCTION;
  wire                when_Pipeline_l124_4;
  reg        [31:0]   execute_to_memory_INSTRUCTION;
  wire                when_Pipeline_l124_5;
  reg        [31:0]   memory_to_writeBack_INSTRUCTION;
  wire                when_Pipeline_l124_6;
  reg        [31:0]   decode_to_execute_FORMAL_PC_NEXT;
  wire                when_Pipeline_l124_7;
  reg        [31:0]   execute_to_memory_FORMAL_PC_NEXT;
  wire                when_Pipeline_l124_8;
  reg        [31:0]   memory_to_writeBack_FORMAL_PC_NEXT;
  wire                when_Pipeline_l124_9;
  reg                 decode_to_execute_CSR_WRITE_OPCODE;
  wire                when_Pipeline_l124_10;
  reg                 decode_to_execute_CSR_READ_OPCODE;
  wire                when_Pipeline_l124_11;
  reg        [1:0]    decode_to_execute_SRC1_CTRL;
  wire                when_Pipeline_l124_12;
  reg                 decode_to_execute_SRC_USE_SUB_LESS;
  wire                when_Pipeline_l124_13;
  reg                 decode_to_execute_MEMORY_ENABLE;
  wire                when_Pipeline_l124_14;
  reg                 execute_to_memory_MEMORY_ENABLE;
  wire                when_Pipeline_l124_15;
  reg                 memory_to_writeBack_MEMORY_ENABLE;
  wire                when_Pipeline_l124_16;
  reg        [1:0]    decode_to_execute_SRC2_CTRL;
  wire                when_Pipeline_l124_17;
  reg                 decode_to_execute_REGFILE_WRITE_VALID;
  wire                when_Pipeline_l124_18;
  reg                 execute_to_memory_REGFILE_WRITE_VALID;
  wire                when_Pipeline_l124_19;
  reg                 memory_to_writeBack_REGFILE_WRITE_VALID;
  wire                when_Pipeline_l124_20;
  reg                 decode_to_execute_BYPASSABLE_EXECUTE_STAGE;
  wire                when_Pipeline_l124_21;
  reg                 decode_to_execute_BYPASSABLE_MEMORY_STAGE;
  wire                when_Pipeline_l124_22;
  reg                 execute_to_memory_BYPASSABLE_MEMORY_STAGE;
  wire                when_Pipeline_l124_23;
  reg                 decode_to_execute_MEMORY_STORE;
  wire                when_Pipeline_l124_24;
  reg                 execute_to_memory_MEMORY_STORE;
  wire                when_Pipeline_l124_25;
  reg                 decode_to_execute_IS_CSR;
  wire                when_Pipeline_l124_26;
  reg        [0:0]    decode_to_execute_ENV_CTRL;
  wire                when_Pipeline_l124_27;
  reg        [0:0]    execute_to_memory_ENV_CTRL;
  wire                when_Pipeline_l124_28;
  reg        [0:0]    memory_to_writeBack_ENV_CTRL;
  wire                when_Pipeline_l124_29;
  reg        [1:0]    decode_to_execute_ALU_CTRL;
  wire                when_Pipeline_l124_30;
  reg                 decode_to_execute_SRC_LESS_UNSIGNED;
  wire                when_Pipeline_l124_31;
  reg        [1:0]    decode_to_execute_ALU_BITWISE_CTRL;
  wire                when_Pipeline_l124_32;
  reg        [1:0]    decode_to_execute_SHIFT_CTRL;
  wire                when_Pipeline_l124_33;
  reg        [1:0]    decode_to_execute_BRANCH_CTRL;
  wire                when_Pipeline_l124_34;
  reg        [31:0]   decode_to_execute_RS1;
  wire                when_Pipeline_l124_35;
  reg        [31:0]   decode_to_execute_RS2;
  wire                when_Pipeline_l124_36;
  reg                 decode_to_execute_SRC2_FORCE_ZERO;
  wire                when_Pipeline_l124_37;
  reg        [1:0]    execute_to_memory_MEMORY_ADDRESS_LOW;
  wire                when_Pipeline_l124_38;
  reg        [1:0]    memory_to_writeBack_MEMORY_ADDRESS_LOW;
  wire                when_Pipeline_l124_39;
  reg        [31:0]   execute_to_memory_REGFILE_WRITE_DATA;
  wire                when_Pipeline_l124_40;
  reg        [31:0]   memory_to_writeBack_REGFILE_WRITE_DATA;
  wire                when_Pipeline_l124_41;
  reg                 execute_to_memory_BRANCH_DO;
  wire                when_Pipeline_l124_42;
  reg        [31:0]   execute_to_memory_BRANCH_CALC;
  wire                when_Pipeline_l124_43;
  reg        [31:0]   memory_to_writeBack_MEMORY_READ_DATA;
  wire                when_Pipeline_l151;
  wire                when_Pipeline_l154;
  wire                when_Pipeline_l151_1;
  wire                when_Pipeline_l154_1;
  wire                when_Pipeline_l151_2;
  wire                when_Pipeline_l154_2;
  wire                when_CsrPlugin_l1669;
  reg                 execute_CsrPlugin_csr_768;
  wire                when_CsrPlugin_l1669_1;
  reg                 execute_CsrPlugin_csr_836;
  wire                when_CsrPlugin_l1669_2;
  reg                 execute_CsrPlugin_csr_772;
  wire                when_CsrPlugin_l1669_3;
  reg                 execute_CsrPlugin_csr_834;
  wire       [1:0]    switch_CsrPlugin_l1031;
  reg        [31:0]   _zz_CsrPlugin_csrMapping_readDataInit;
  reg        [31:0]   _zz_CsrPlugin_csrMapping_readDataInit_1;
  reg        [31:0]   _zz_CsrPlugin_csrMapping_readDataInit_2;
  reg        [31:0]   _zz_CsrPlugin_csrMapping_readDataInit_3;
  wire                when_CsrPlugin_l1702;
  wire       [11:0]   _zz_when_CsrPlugin_l1709;
  wire                when_CsrPlugin_l1709;
  reg                 when_CsrPlugin_l1719;
  wire                when_CsrPlugin_l1717;
  wire                when_CsrPlugin_l1725;
  `ifndef SYNTHESIS
  reg [31:0] decode_BRANCH_CTRL_string;
  reg [31:0] _zz_decode_BRANCH_CTRL_string;
  reg [31:0] _zz_decode_to_execute_BRANCH_CTRL_string;
  reg [31:0] _zz_decode_to_execute_BRANCH_CTRL_1_string;
  reg [71:0] decode_SHIFT_CTRL_string;
  reg [71:0] _zz_decode_SHIFT_CTRL_string;
  reg [71:0] _zz_decode_to_execute_SHIFT_CTRL_string;
  reg [71:0] _zz_decode_to_execute_SHIFT_CTRL_1_string;
  reg [39:0] decode_ALU_BITWISE_CTRL_string;
  reg [39:0] _zz_decode_ALU_BITWISE_CTRL_string;
  reg [39:0] _zz_decode_to_execute_ALU_BITWISE_CTRL_string;
  reg [39:0] _zz_decode_to_execute_ALU_BITWISE_CTRL_1_string;
  reg [63:0] decode_ALU_CTRL_string;
  reg [63:0] _zz_decode_ALU_CTRL_string;
  reg [63:0] _zz_decode_to_execute_ALU_CTRL_string;
  reg [63:0] _zz_decode_to_execute_ALU_CTRL_1_string;
  reg [31:0] _zz_memory_to_writeBack_ENV_CTRL_string;
  reg [31:0] _zz_memory_to_writeBack_ENV_CTRL_1_string;
  reg [31:0] _zz_execute_to_memory_ENV_CTRL_string;
  reg [31:0] _zz_execute_to_memory_ENV_CTRL_1_string;
  reg [31:0] decode_ENV_CTRL_string;
  reg [31:0] _zz_decode_ENV_CTRL_string;
  reg [31:0] _zz_decode_to_execute_ENV_CTRL_string;
  reg [31:0] _zz_decode_to_execute_ENV_CTRL_1_string;
  reg [23:0] decode_SRC2_CTRL_string;
  reg [23:0] _zz_decode_SRC2_CTRL_string;
  reg [23:0] _zz_decode_to_execute_SRC2_CTRL_string;
  reg [23:0] _zz_decode_to_execute_SRC2_CTRL_1_string;
  reg [95:0] decode_SRC1_CTRL_string;
  reg [95:0] _zz_decode_SRC1_CTRL_string;
  reg [95:0] _zz_decode_to_execute_SRC1_CTRL_string;
  reg [95:0] _zz_decode_to_execute_SRC1_CTRL_1_string;
  reg [31:0] execute_BRANCH_CTRL_string;
  reg [31:0] _zz_execute_BRANCH_CTRL_string;
  reg [71:0] execute_SHIFT_CTRL_string;
  reg [71:0] _zz_execute_SHIFT_CTRL_string;
  reg [23:0] execute_SRC2_CTRL_string;
  reg [23:0] _zz_execute_SRC2_CTRL_string;
  reg [95:0] execute_SRC1_CTRL_string;
  reg [95:0] _zz_execute_SRC1_CTRL_string;
  reg [63:0] execute_ALU_CTRL_string;
  reg [63:0] _zz_execute_ALU_CTRL_string;
  reg [39:0] execute_ALU_BITWISE_CTRL_string;
  reg [39:0] _zz_execute_ALU_BITWISE_CTRL_string;
  reg [31:0] _zz_decode_BRANCH_CTRL_1_string;
  reg [71:0] _zz_decode_SHIFT_CTRL_1_string;
  reg [39:0] _zz_decode_ALU_BITWISE_CTRL_1_string;
  reg [63:0] _zz_decode_ALU_CTRL_1_string;
  reg [31:0] _zz_decode_ENV_CTRL_1_string;
  reg [23:0] _zz_decode_SRC2_CTRL_1_string;
  reg [95:0] _zz_decode_SRC1_CTRL_1_string;
  reg [31:0] memory_ENV_CTRL_string;
  reg [31:0] _zz_memory_ENV_CTRL_string;
  reg [31:0] execute_ENV_CTRL_string;
  reg [31:0] _zz_execute_ENV_CTRL_string;
  reg [31:0] writeBack_ENV_CTRL_string;
  reg [31:0] _zz_writeBack_ENV_CTRL_string;
  reg [95:0] _zz_decode_SRC1_CTRL_2_string;
  reg [23:0] _zz_decode_SRC2_CTRL_2_string;
  reg [31:0] _zz_decode_ENV_CTRL_2_string;
  reg [63:0] _zz_decode_ALU_CTRL_2_string;
  reg [39:0] _zz_decode_ALU_BITWISE_CTRL_2_string;
  reg [71:0] _zz_decode_SHIFT_CTRL_2_string;
  reg [31:0] _zz_decode_BRANCH_CTRL_2_string;
  reg [95:0] decode_to_execute_SRC1_CTRL_string;
  reg [23:0] decode_to_execute_SRC2_CTRL_string;
  reg [31:0] decode_to_execute_ENV_CTRL_string;
  reg [31:0] execute_to_memory_ENV_CTRL_string;
  reg [31:0] memory_to_writeBack_ENV_CTRL_string;
  reg [63:0] decode_to_execute_ALU_CTRL_string;
  reg [39:0] decode_to_execute_ALU_BITWISE_CTRL_string;
  reg [71:0] decode_to_execute_SHIFT_CTRL_string;
  reg [31:0] decode_to_execute_BRANCH_CTRL_string;
  `endif

  reg [31:0] RegFilePlugin_regFile [0:31] /* verilator public */ ;

  assign _zz_IBusSimplePlugin_jump_pcLoad_payload_1 = (_zz_IBusSimplePlugin_jump_pcLoad_payload & (~ _zz_IBusSimplePlugin_jump_pcLoad_payload_2));
  assign _zz_IBusSimplePlugin_jump_pcLoad_payload_2 = (_zz_IBusSimplePlugin_jump_pcLoad_payload - 2'b01);
  assign _zz_IBusSimplePlugin_fetchPc_pc_1 = {IBusSimplePlugin_fetchPc_inc,2'b00};
  assign _zz_IBusSimplePlugin_fetchPc_pc = {29'd0, _zz_IBusSimplePlugin_fetchPc_pc_1};
  assign _zz_IBusSimplePlugin_pending_next = (IBusSimplePlugin_pending_value + _zz_IBusSimplePlugin_pending_next_1);
  assign _zz_IBusSimplePlugin_pending_next_2 = IBusSimplePlugin_pending_inc;
  assign _zz_IBusSimplePlugin_pending_next_1 = {2'd0, _zz_IBusSimplePlugin_pending_next_2};
  assign _zz_IBusSimplePlugin_pending_next_4 = IBusSimplePlugin_pending_dec;
  assign _zz_IBusSimplePlugin_pending_next_3 = {2'd0, _zz_IBusSimplePlugin_pending_next_4};
  assign _zz_IBusSimplePlugin_rspJoin_rspBuffer_discardCounter_1 = (IBusSimplePlugin_rspJoin_rspBuffer_c_io_pop_valid && (IBusSimplePlugin_rspJoin_rspBuffer_discardCounter != 3'b000));
  assign _zz_IBusSimplePlugin_rspJoin_rspBuffer_discardCounter = {2'd0, _zz_IBusSimplePlugin_rspJoin_rspBuffer_discardCounter_1};
  assign _zz_IBusSimplePlugin_rspJoin_rspBuffer_discardCounter_3 = IBusSimplePlugin_pending_dec;
  assign _zz_IBusSimplePlugin_rspJoin_rspBuffer_discardCounter_2 = {2'd0, _zz_IBusSimplePlugin_rspJoin_rspBuffer_discardCounter_3};
  assign _zz__zz_execute_REGFILE_WRITE_DATA = execute_SRC_LESS;
  assign _zz__zz_execute_SRC1 = 3'b100;
  assign _zz__zz_execute_SRC1_1 = execute_INSTRUCTION[19 : 15];
  assign _zz__zz_execute_SRC2_2 = {execute_INSTRUCTION[31 : 25],execute_INSTRUCTION[11 : 7]};
  assign _zz_execute_SrcPlugin_addSub = ($signed(_zz_execute_SrcPlugin_addSub_1) + $signed(_zz_execute_SrcPlugin_addSub_4));
  assign _zz_execute_SrcPlugin_addSub_1 = ($signed(_zz_execute_SrcPlugin_addSub_2) + $signed(_zz_execute_SrcPlugin_addSub_3));
  assign _zz_execute_SrcPlugin_addSub_2 = execute_SRC1;
  assign _zz_execute_SrcPlugin_addSub_3 = (execute_SRC_USE_SUB_LESS ? (~ execute_SRC2) : execute_SRC2);
  assign _zz_execute_SrcPlugin_addSub_4 = (execute_SRC_USE_SUB_LESS ? 32'h00000001 : 32'h0);
  assign _zz__zz_decode_RS2_3 = (_zz__zz_decode_RS2_3_1 >>> 1'd1);
  assign _zz__zz_decode_RS2_3_1 = {((execute_SHIFT_CTRL == ShiftCtrlEnum_SRA_1) && execute_LightShifterPlugin_shiftInput[31]),execute_LightShifterPlugin_shiftInput};
  assign _zz__zz_execute_BranchPlugin_branch_src2 = {{{execute_INSTRUCTION[31],execute_INSTRUCTION[19 : 12]},execute_INSTRUCTION[20]},execute_INSTRUCTION[30 : 21]};
  assign _zz__zz_execute_BranchPlugin_branch_src2_4 = {{{execute_INSTRUCTION[31],execute_INSTRUCTION[7]},execute_INSTRUCTION[30 : 25]},execute_INSTRUCTION[11 : 8]};
  assign _zz_decode_RegFilePlugin_rs1Data = 1'b1;
  assign _zz_decode_RegFilePlugin_rs2Data = 1'b1;
  assign _zz__zz_decode_SRC_LESS_UNSIGNED = (decode_INSTRUCTION & 32'h0000001c);
  assign _zz__zz_decode_SRC_LESS_UNSIGNED_1 = 32'h00000004;
  assign _zz__zz_decode_SRC_LESS_UNSIGNED_2 = (decode_INSTRUCTION & 32'h00000058);
  assign _zz__zz_decode_SRC_LESS_UNSIGNED_3 = 32'h00000040;
  assign _zz__zz_decode_SRC_LESS_UNSIGNED_4 = ((decode_INSTRUCTION & 32'h00007054) == 32'h00005010);
  assign _zz__zz_decode_SRC_LESS_UNSIGNED_5 = {(_zz__zz_decode_SRC_LESS_UNSIGNED_6 == _zz__zz_decode_SRC_LESS_UNSIGNED_7),(_zz__zz_decode_SRC_LESS_UNSIGNED_8 == _zz__zz_decode_SRC_LESS_UNSIGNED_9)};
  assign _zz__zz_decode_SRC_LESS_UNSIGNED_10 = (|{_zz__zz_decode_SRC_LESS_UNSIGNED_11,_zz__zz_decode_SRC_LESS_UNSIGNED_12});
  assign _zz__zz_decode_SRC_LESS_UNSIGNED_13 = (|_zz__zz_decode_SRC_LESS_UNSIGNED_14);
  assign _zz__zz_decode_SRC_LESS_UNSIGNED_15 = {(|_zz__zz_decode_SRC_LESS_UNSIGNED_16),{_zz__zz_decode_SRC_LESS_UNSIGNED_18,{_zz__zz_decode_SRC_LESS_UNSIGNED_21,_zz__zz_decode_SRC_LESS_UNSIGNED_26}}};
  assign _zz__zz_decode_SRC_LESS_UNSIGNED_6 = (decode_INSTRUCTION & 32'h40003054);
  assign _zz__zz_decode_SRC_LESS_UNSIGNED_7 = 32'h40001010;
  assign _zz__zz_decode_SRC_LESS_UNSIGNED_8 = (decode_INSTRUCTION & 32'h00007054);
  assign _zz__zz_decode_SRC_LESS_UNSIGNED_9 = 32'h00001010;
  assign _zz__zz_decode_SRC_LESS_UNSIGNED_11 = ((decode_INSTRUCTION & 32'h00000064) == 32'h00000024);
  assign _zz__zz_decode_SRC_LESS_UNSIGNED_12 = ((decode_INSTRUCTION & 32'h00003054) == 32'h00001010);
  assign _zz__zz_decode_SRC_LESS_UNSIGNED_14 = ((decode_INSTRUCTION & 32'h00001000) == 32'h00001000);
  assign _zz__zz_decode_SRC_LESS_UNSIGNED_16 = ((decode_INSTRUCTION & _zz__zz_decode_SRC_LESS_UNSIGNED_17) == 32'h00002000);
  assign _zz__zz_decode_SRC_LESS_UNSIGNED_18 = (|{_zz__zz_decode_SRC_LESS_UNSIGNED_19,_zz__zz_decode_SRC_LESS_UNSIGNED_20});
  assign _zz__zz_decode_SRC_LESS_UNSIGNED_21 = (|{_zz__zz_decode_SRC_LESS_UNSIGNED_22,_zz__zz_decode_SRC_LESS_UNSIGNED_24});
  assign _zz__zz_decode_SRC_LESS_UNSIGNED_26 = {(|_zz__zz_decode_SRC_LESS_UNSIGNED_27),{_zz__zz_decode_SRC_LESS_UNSIGNED_28,{_zz__zz_decode_SRC_LESS_UNSIGNED_31,_zz__zz_decode_SRC_LESS_UNSIGNED_36}}};
  assign _zz__zz_decode_SRC_LESS_UNSIGNED_17 = 32'h00003000;
  assign _zz__zz_decode_SRC_LESS_UNSIGNED_19 = ((decode_INSTRUCTION & 32'h00002010) == 32'h00002000);
  assign _zz__zz_decode_SRC_LESS_UNSIGNED_20 = ((decode_INSTRUCTION & 32'h00005000) == 32'h00001000);
  assign _zz__zz_decode_SRC_LESS_UNSIGNED_22 = ((decode_INSTRUCTION & _zz__zz_decode_SRC_LESS_UNSIGNED_23) == 32'h00006000);
  assign _zz__zz_decode_SRC_LESS_UNSIGNED_24 = ((decode_INSTRUCTION & _zz__zz_decode_SRC_LESS_UNSIGNED_25) == 32'h00004000);
  assign _zz__zz_decode_SRC_LESS_UNSIGNED_27 = _zz_decode_SRC_LESS_UNSIGNED_2;
  assign _zz__zz_decode_SRC_LESS_UNSIGNED_28 = (|(_zz__zz_decode_SRC_LESS_UNSIGNED_29 == _zz__zz_decode_SRC_LESS_UNSIGNED_30));
  assign _zz__zz_decode_SRC_LESS_UNSIGNED_31 = (|{_zz__zz_decode_SRC_LESS_UNSIGNED_32,_zz__zz_decode_SRC_LESS_UNSIGNED_34});
  assign _zz__zz_decode_SRC_LESS_UNSIGNED_36 = {(|_zz__zz_decode_SRC_LESS_UNSIGNED_37),{_zz__zz_decode_SRC_LESS_UNSIGNED_42,{_zz__zz_decode_SRC_LESS_UNSIGNED_47,_zz__zz_decode_SRC_LESS_UNSIGNED_49}}};
  assign _zz__zz_decode_SRC_LESS_UNSIGNED_23 = 32'h00006004;
  assign _zz__zz_decode_SRC_LESS_UNSIGNED_25 = 32'h00005004;
  assign _zz__zz_decode_SRC_LESS_UNSIGNED_29 = (decode_INSTRUCTION & 32'h00003050);
  assign _zz__zz_decode_SRC_LESS_UNSIGNED_30 = 32'h00000050;
  assign _zz__zz_decode_SRC_LESS_UNSIGNED_32 = ((decode_INSTRUCTION & _zz__zz_decode_SRC_LESS_UNSIGNED_33) == 32'h00001050);
  assign _zz__zz_decode_SRC_LESS_UNSIGNED_34 = ((decode_INSTRUCTION & _zz__zz_decode_SRC_LESS_UNSIGNED_35) == 32'h00002050);
  assign _zz__zz_decode_SRC_LESS_UNSIGNED_37 = {(_zz__zz_decode_SRC_LESS_UNSIGNED_38 == _zz__zz_decode_SRC_LESS_UNSIGNED_39),(_zz__zz_decode_SRC_LESS_UNSIGNED_40 == _zz__zz_decode_SRC_LESS_UNSIGNED_41)};
  assign _zz__zz_decode_SRC_LESS_UNSIGNED_42 = (|{_zz__zz_decode_SRC_LESS_UNSIGNED_43,{_zz__zz_decode_SRC_LESS_UNSIGNED_44,_zz__zz_decode_SRC_LESS_UNSIGNED_45}});
  assign _zz__zz_decode_SRC_LESS_UNSIGNED_47 = (|_zz__zz_decode_SRC_LESS_UNSIGNED_48);
  assign _zz__zz_decode_SRC_LESS_UNSIGNED_49 = {(|_zz__zz_decode_SRC_LESS_UNSIGNED_50),{_zz__zz_decode_SRC_LESS_UNSIGNED_52,{_zz__zz_decode_SRC_LESS_UNSIGNED_53,_zz__zz_decode_SRC_LESS_UNSIGNED_65}}};
  assign _zz__zz_decode_SRC_LESS_UNSIGNED_33 = 32'h00001050;
  assign _zz__zz_decode_SRC_LESS_UNSIGNED_35 = 32'h00002050;
  assign _zz__zz_decode_SRC_LESS_UNSIGNED_38 = (decode_INSTRUCTION & 32'h00000034);
  assign _zz__zz_decode_SRC_LESS_UNSIGNED_39 = 32'h00000020;
  assign _zz__zz_decode_SRC_LESS_UNSIGNED_40 = (decode_INSTRUCTION & 32'h00000064);
  assign _zz__zz_decode_SRC_LESS_UNSIGNED_41 = 32'h00000020;
  assign _zz__zz_decode_SRC_LESS_UNSIGNED_43 = ((decode_INSTRUCTION & 32'h00000050) == 32'h00000040);
  assign _zz__zz_decode_SRC_LESS_UNSIGNED_44 = _zz_decode_SRC_LESS_UNSIGNED_3;
  assign _zz__zz_decode_SRC_LESS_UNSIGNED_45 = ((decode_INSTRUCTION & _zz__zz_decode_SRC_LESS_UNSIGNED_46) == 32'h00000040);
  assign _zz__zz_decode_SRC_LESS_UNSIGNED_48 = ((decode_INSTRUCTION & 32'h00000020) == 32'h00000020);
  assign _zz__zz_decode_SRC_LESS_UNSIGNED_50 = ((decode_INSTRUCTION & _zz__zz_decode_SRC_LESS_UNSIGNED_51) == 32'h00000010);
  assign _zz__zz_decode_SRC_LESS_UNSIGNED_52 = (|_zz_decode_SRC_LESS_UNSIGNED_5);
  assign _zz__zz_decode_SRC_LESS_UNSIGNED_53 = (|{_zz__zz_decode_SRC_LESS_UNSIGNED_54,_zz__zz_decode_SRC_LESS_UNSIGNED_55});
  assign _zz__zz_decode_SRC_LESS_UNSIGNED_65 = {(|_zz__zz_decode_SRC_LESS_UNSIGNED_66),{_zz__zz_decode_SRC_LESS_UNSIGNED_69,{_zz__zz_decode_SRC_LESS_UNSIGNED_71,_zz__zz_decode_SRC_LESS_UNSIGNED_76}}};
  assign _zz__zz_decode_SRC_LESS_UNSIGNED_46 = 32'h00003040;
  assign _zz__zz_decode_SRC_LESS_UNSIGNED_51 = 32'h00000010;
  assign _zz__zz_decode_SRC_LESS_UNSIGNED_54 = _zz_decode_SRC_LESS_UNSIGNED_6;
  assign _zz__zz_decode_SRC_LESS_UNSIGNED_55 = {(_zz__zz_decode_SRC_LESS_UNSIGNED_56 == _zz__zz_decode_SRC_LESS_UNSIGNED_57),{_zz__zz_decode_SRC_LESS_UNSIGNED_58,{_zz__zz_decode_SRC_LESS_UNSIGNED_59,_zz__zz_decode_SRC_LESS_UNSIGNED_60}}};
  assign _zz__zz_decode_SRC_LESS_UNSIGNED_66 = {_zz_decode_SRC_LESS_UNSIGNED_4,(_zz__zz_decode_SRC_LESS_UNSIGNED_67 == _zz__zz_decode_SRC_LESS_UNSIGNED_68)};
  assign _zz__zz_decode_SRC_LESS_UNSIGNED_69 = (|{_zz_decode_SRC_LESS_UNSIGNED_4,_zz__zz_decode_SRC_LESS_UNSIGNED_70});
  assign _zz__zz_decode_SRC_LESS_UNSIGNED_71 = (|{_zz__zz_decode_SRC_LESS_UNSIGNED_72,_zz__zz_decode_SRC_LESS_UNSIGNED_74});
  assign _zz__zz_decode_SRC_LESS_UNSIGNED_76 = {(|_zz__zz_decode_SRC_LESS_UNSIGNED_77),{_zz__zz_decode_SRC_LESS_UNSIGNED_79,{_zz__zz_decode_SRC_LESS_UNSIGNED_83,_zz__zz_decode_SRC_LESS_UNSIGNED_86}}};
  assign _zz__zz_decode_SRC_LESS_UNSIGNED_56 = (decode_INSTRUCTION & 32'h00001010);
  assign _zz__zz_decode_SRC_LESS_UNSIGNED_57 = 32'h00001010;
  assign _zz__zz_decode_SRC_LESS_UNSIGNED_58 = ((decode_INSTRUCTION & 32'h00002010) == 32'h00002010);
  assign _zz__zz_decode_SRC_LESS_UNSIGNED_59 = _zz_decode_SRC_LESS_UNSIGNED_5;
  assign _zz__zz_decode_SRC_LESS_UNSIGNED_60 = {(_zz__zz_decode_SRC_LESS_UNSIGNED_61 == _zz__zz_decode_SRC_LESS_UNSIGNED_62),(_zz__zz_decode_SRC_LESS_UNSIGNED_63 == _zz__zz_decode_SRC_LESS_UNSIGNED_64)};
  assign _zz__zz_decode_SRC_LESS_UNSIGNED_67 = (decode_INSTRUCTION & 32'h00000070);
  assign _zz__zz_decode_SRC_LESS_UNSIGNED_68 = 32'h00000020;
  assign _zz__zz_decode_SRC_LESS_UNSIGNED_70 = ((decode_INSTRUCTION & 32'h00000020) == 32'h0);
  assign _zz__zz_decode_SRC_LESS_UNSIGNED_72 = ((decode_INSTRUCTION & _zz__zz_decode_SRC_LESS_UNSIGNED_73) == 32'h0);
  assign _zz__zz_decode_SRC_LESS_UNSIGNED_74 = {_zz_decode_SRC_LESS_UNSIGNED_3,{_zz_decode_SRC_LESS_UNSIGNED_2,_zz__zz_decode_SRC_LESS_UNSIGNED_75}};
  assign _zz__zz_decode_SRC_LESS_UNSIGNED_77 = ((decode_INSTRUCTION & _zz__zz_decode_SRC_LESS_UNSIGNED_78) == 32'h0);
  assign _zz__zz_decode_SRC_LESS_UNSIGNED_79 = (|{_zz__zz_decode_SRC_LESS_UNSIGNED_80,{_zz__zz_decode_SRC_LESS_UNSIGNED_81,_zz__zz_decode_SRC_LESS_UNSIGNED_82}});
  assign _zz__zz_decode_SRC_LESS_UNSIGNED_83 = (|{_zz__zz_decode_SRC_LESS_UNSIGNED_84,_zz__zz_decode_SRC_LESS_UNSIGNED_85});
  assign _zz__zz_decode_SRC_LESS_UNSIGNED_86 = (|{_zz__zz_decode_SRC_LESS_UNSIGNED_87,_zz__zz_decode_SRC_LESS_UNSIGNED_88});
  assign _zz__zz_decode_SRC_LESS_UNSIGNED_61 = (decode_INSTRUCTION & 32'h0000000c);
  assign _zz__zz_decode_SRC_LESS_UNSIGNED_62 = 32'h00000004;
  assign _zz__zz_decode_SRC_LESS_UNSIGNED_63 = (decode_INSTRUCTION & 32'h00000028);
  assign _zz__zz_decode_SRC_LESS_UNSIGNED_64 = 32'h0;
  assign _zz__zz_decode_SRC_LESS_UNSIGNED_73 = 32'h00000044;
  assign _zz__zz_decode_SRC_LESS_UNSIGNED_75 = ((decode_INSTRUCTION & 32'h00005004) == 32'h00001000);
  assign _zz__zz_decode_SRC_LESS_UNSIGNED_78 = 32'h00000058;
  assign _zz__zz_decode_SRC_LESS_UNSIGNED_80 = ((decode_INSTRUCTION & 32'h00000044) == 32'h00000040);
  assign _zz__zz_decode_SRC_LESS_UNSIGNED_81 = ((decode_INSTRUCTION & 32'h00002014) == 32'h00002010);
  assign _zz__zz_decode_SRC_LESS_UNSIGNED_82 = ((decode_INSTRUCTION & 32'h40004034) == 32'h40000030);
  assign _zz__zz_decode_SRC_LESS_UNSIGNED_84 = ((decode_INSTRUCTION & 32'h00000014) == 32'h00000004);
  assign _zz__zz_decode_SRC_LESS_UNSIGNED_85 = _zz_decode_SRC_LESS_UNSIGNED_1;
  assign _zz__zz_decode_SRC_LESS_UNSIGNED_87 = ((decode_INSTRUCTION & 32'h00000044) == 32'h00000004);
  assign _zz__zz_decode_SRC_LESS_UNSIGNED_88 = _zz_decode_SRC_LESS_UNSIGNED_1;
  always @(posedge clk) begin
    if(_zz_decode_RegFilePlugin_rs1Data) begin
      RegFilePlugin_regFile_spinal_port0 <= RegFilePlugin_regFile[decode_RegFilePlugin_regFileReadAddress1];
    end
  end

  always @(posedge clk) begin
    if(_zz_decode_RegFilePlugin_rs2Data) begin
      RegFilePlugin_regFile_spinal_port1 <= RegFilePlugin_regFile[decode_RegFilePlugin_regFileReadAddress2];
    end
  end

  always @(posedge clk) begin
    if(_zz_1) begin
      RegFilePlugin_regFile[lastStageRegFileWrite_payload_address] <= lastStageRegFileWrite_payload_data;
    end
  end

  StreamFifoLowLatency IBusSimplePlugin_rspJoin_rspBuffer_c (
    .io_push_valid         (iBus_rsp_toStream_valid                                       ), //i
    .io_push_ready         (IBusSimplePlugin_rspJoin_rspBuffer_c_io_push_ready            ), //o
    .io_push_payload_error (iBus_rsp_toStream_payload_error                               ), //i
    .io_push_payload_inst  (iBus_rsp_toStream_payload_inst[31:0]                          ), //i
    .io_pop_valid          (IBusSimplePlugin_rspJoin_rspBuffer_c_io_pop_valid             ), //o
    .io_pop_ready          (IBusSimplePlugin_rspJoin_rspBuffer_c_io_pop_ready             ), //i
    .io_pop_payload_error  (IBusSimplePlugin_rspJoin_rspBuffer_c_io_pop_payload_error     ), //o
    .io_pop_payload_inst   (IBusSimplePlugin_rspJoin_rspBuffer_c_io_pop_payload_inst[31:0]), //o
    .io_flush              (1'b0                                                          ), //i
    .io_occupancy          (IBusSimplePlugin_rspJoin_rspBuffer_c_io_occupancy             ), //o
    .io_availability       (IBusSimplePlugin_rspJoin_rspBuffer_c_io_availability          ), //o
    .clk                   (clk                                                           ), //i
    .reset                 (reset                                                         )  //i
  );
  `ifndef SYNTHESIS
  always @(*) begin
    case(decode_BRANCH_CTRL)
      BranchCtrlEnum_INC : decode_BRANCH_CTRL_string = "INC ";
      BranchCtrlEnum_B : decode_BRANCH_CTRL_string = "B   ";
      BranchCtrlEnum_JAL : decode_BRANCH_CTRL_string = "JAL ";
      BranchCtrlEnum_JALR : decode_BRANCH_CTRL_string = "JALR";
      default : decode_BRANCH_CTRL_string = "????";
    endcase
  end
  always @(*) begin
    case(_zz_decode_BRANCH_CTRL)
      BranchCtrlEnum_INC : _zz_decode_BRANCH_CTRL_string = "INC ";
      BranchCtrlEnum_B : _zz_decode_BRANCH_CTRL_string = "B   ";
      BranchCtrlEnum_JAL : _zz_decode_BRANCH_CTRL_string = "JAL ";
      BranchCtrlEnum_JALR : _zz_decode_BRANCH_CTRL_string = "JALR";
      default : _zz_decode_BRANCH_CTRL_string = "????";
    endcase
  end
  always @(*) begin
    case(_zz_decode_to_execute_BRANCH_CTRL)
      BranchCtrlEnum_INC : _zz_decode_to_execute_BRANCH_CTRL_string = "INC ";
      BranchCtrlEnum_B : _zz_decode_to_execute_BRANCH_CTRL_string = "B   ";
      BranchCtrlEnum_JAL : _zz_decode_to_execute_BRANCH_CTRL_string = "JAL ";
      BranchCtrlEnum_JALR : _zz_decode_to_execute_BRANCH_CTRL_string = "JALR";
      default : _zz_decode_to_execute_BRANCH_CTRL_string = "????";
    endcase
  end
  always @(*) begin
    case(_zz_decode_to_execute_BRANCH_CTRL_1)
      BranchCtrlEnum_INC : _zz_decode_to_execute_BRANCH_CTRL_1_string = "INC ";
      BranchCtrlEnum_B : _zz_decode_to_execute_BRANCH_CTRL_1_string = "B   ";
      BranchCtrlEnum_JAL : _zz_decode_to_execute_BRANCH_CTRL_1_string = "JAL ";
      BranchCtrlEnum_JALR : _zz_decode_to_execute_BRANCH_CTRL_1_string = "JALR";
      default : _zz_decode_to_execute_BRANCH_CTRL_1_string = "????";
    endcase
  end
  always @(*) begin
    case(decode_SHIFT_CTRL)
      ShiftCtrlEnum_DISABLE_1 : decode_SHIFT_CTRL_string = "DISABLE_1";
      ShiftCtrlEnum_SLL_1 : decode_SHIFT_CTRL_string = "SLL_1    ";
      ShiftCtrlEnum_SRL_1 : decode_SHIFT_CTRL_string = "SRL_1    ";
      ShiftCtrlEnum_SRA_1 : decode_SHIFT_CTRL_string = "SRA_1    ";
      default : decode_SHIFT_CTRL_string = "?????????";
    endcase
  end
  always @(*) begin
    case(_zz_decode_SHIFT_CTRL)
      ShiftCtrlEnum_DISABLE_1 : _zz_decode_SHIFT_CTRL_string = "DISABLE_1";
      ShiftCtrlEnum_SLL_1 : _zz_decode_SHIFT_CTRL_string = "SLL_1    ";
      ShiftCtrlEnum_SRL_1 : _zz_decode_SHIFT_CTRL_string = "SRL_1    ";
      ShiftCtrlEnum_SRA_1 : _zz_decode_SHIFT_CTRL_string = "SRA_1    ";
      default : _zz_decode_SHIFT_CTRL_string = "?????????";
    endcase
  end
  always @(*) begin
    case(_zz_decode_to_execute_SHIFT_CTRL)
      ShiftCtrlEnum_DISABLE_1 : _zz_decode_to_execute_SHIFT_CTRL_string = "DISABLE_1";
      ShiftCtrlEnum_SLL_1 : _zz_decode_to_execute_SHIFT_CTRL_string = "SLL_1    ";
      ShiftCtrlEnum_SRL_1 : _zz_decode_to_execute_SHIFT_CTRL_string = "SRL_1    ";
      ShiftCtrlEnum_SRA_1 : _zz_decode_to_execute_SHIFT_CTRL_string = "SRA_1    ";
      default : _zz_decode_to_execute_SHIFT_CTRL_string = "?????????";
    endcase
  end
  always @(*) begin
    case(_zz_decode_to_execute_SHIFT_CTRL_1)
      ShiftCtrlEnum_DISABLE_1 : _zz_decode_to_execute_SHIFT_CTRL_1_string = "DISABLE_1";
      ShiftCtrlEnum_SLL_1 : _zz_decode_to_execute_SHIFT_CTRL_1_string = "SLL_1    ";
      ShiftCtrlEnum_SRL_1 : _zz_decode_to_execute_SHIFT_CTRL_1_string = "SRL_1    ";
      ShiftCtrlEnum_SRA_1 : _zz_decode_to_execute_SHIFT_CTRL_1_string = "SRA_1    ";
      default : _zz_decode_to_execute_SHIFT_CTRL_1_string = "?????????";
    endcase
  end
  always @(*) begin
    case(decode_ALU_BITWISE_CTRL)
      AluBitwiseCtrlEnum_XOR_1 : decode_ALU_BITWISE_CTRL_string = "XOR_1";
      AluBitwiseCtrlEnum_OR_1 : decode_ALU_BITWISE_CTRL_string = "OR_1 ";
      AluBitwiseCtrlEnum_AND_1 : decode_ALU_BITWISE_CTRL_string = "AND_1";
      default : decode_ALU_BITWISE_CTRL_string = "?????";
    endcase
  end
  always @(*) begin
    case(_zz_decode_ALU_BITWISE_CTRL)
      AluBitwiseCtrlEnum_XOR_1 : _zz_decode_ALU_BITWISE_CTRL_string = "XOR_1";
      AluBitwiseCtrlEnum_OR_1 : _zz_decode_ALU_BITWISE_CTRL_string = "OR_1 ";
      AluBitwiseCtrlEnum_AND_1 : _zz_decode_ALU_BITWISE_CTRL_string = "AND_1";
      default : _zz_decode_ALU_BITWISE_CTRL_string = "?????";
    endcase
  end
  always @(*) begin
    case(_zz_decode_to_execute_ALU_BITWISE_CTRL)
      AluBitwiseCtrlEnum_XOR_1 : _zz_decode_to_execute_ALU_BITWISE_CTRL_string = "XOR_1";
      AluBitwiseCtrlEnum_OR_1 : _zz_decode_to_execute_ALU_BITWISE_CTRL_string = "OR_1 ";
      AluBitwiseCtrlEnum_AND_1 : _zz_decode_to_execute_ALU_BITWISE_CTRL_string = "AND_1";
      default : _zz_decode_to_execute_ALU_BITWISE_CTRL_string = "?????";
    endcase
  end
  always @(*) begin
    case(_zz_decode_to_execute_ALU_BITWISE_CTRL_1)
      AluBitwiseCtrlEnum_XOR_1 : _zz_decode_to_execute_ALU_BITWISE_CTRL_1_string = "XOR_1";
      AluBitwiseCtrlEnum_OR_1 : _zz_decode_to_execute_ALU_BITWISE_CTRL_1_string = "OR_1 ";
      AluBitwiseCtrlEnum_AND_1 : _zz_decode_to_execute_ALU_BITWISE_CTRL_1_string = "AND_1";
      default : _zz_decode_to_execute_ALU_BITWISE_CTRL_1_string = "?????";
    endcase
  end
  always @(*) begin
    case(decode_ALU_CTRL)
      AluCtrlEnum_ADD_SUB : decode_ALU_CTRL_string = "ADD_SUB ";
      AluCtrlEnum_SLT_SLTU : decode_ALU_CTRL_string = "SLT_SLTU";
      AluCtrlEnum_BITWISE : decode_ALU_CTRL_string = "BITWISE ";
      default : decode_ALU_CTRL_string = "????????";
    endcase
  end
  always @(*) begin
    case(_zz_decode_ALU_CTRL)
      AluCtrlEnum_ADD_SUB : _zz_decode_ALU_CTRL_string = "ADD_SUB ";
      AluCtrlEnum_SLT_SLTU : _zz_decode_ALU_CTRL_string = "SLT_SLTU";
      AluCtrlEnum_BITWISE : _zz_decode_ALU_CTRL_string = "BITWISE ";
      default : _zz_decode_ALU_CTRL_string = "????????";
    endcase
  end
  always @(*) begin
    case(_zz_decode_to_execute_ALU_CTRL)
      AluCtrlEnum_ADD_SUB : _zz_decode_to_execute_ALU_CTRL_string = "ADD_SUB ";
      AluCtrlEnum_SLT_SLTU : _zz_decode_to_execute_ALU_CTRL_string = "SLT_SLTU";
      AluCtrlEnum_BITWISE : _zz_decode_to_execute_ALU_CTRL_string = "BITWISE ";
      default : _zz_decode_to_execute_ALU_CTRL_string = "????????";
    endcase
  end
  always @(*) begin
    case(_zz_decode_to_execute_ALU_CTRL_1)
      AluCtrlEnum_ADD_SUB : _zz_decode_to_execute_ALU_CTRL_1_string = "ADD_SUB ";
      AluCtrlEnum_SLT_SLTU : _zz_decode_to_execute_ALU_CTRL_1_string = "SLT_SLTU";
      AluCtrlEnum_BITWISE : _zz_decode_to_execute_ALU_CTRL_1_string = "BITWISE ";
      default : _zz_decode_to_execute_ALU_CTRL_1_string = "????????";
    endcase
  end
  always @(*) begin
    case(_zz_memory_to_writeBack_ENV_CTRL)
      EnvCtrlEnum_NONE : _zz_memory_to_writeBack_ENV_CTRL_string = "NONE";
      EnvCtrlEnum_XRET : _zz_memory_to_writeBack_ENV_CTRL_string = "XRET";
      default : _zz_memory_to_writeBack_ENV_CTRL_string = "????";
    endcase
  end
  always @(*) begin
    case(_zz_memory_to_writeBack_ENV_CTRL_1)
      EnvCtrlEnum_NONE : _zz_memory_to_writeBack_ENV_CTRL_1_string = "NONE";
      EnvCtrlEnum_XRET : _zz_memory_to_writeBack_ENV_CTRL_1_string = "XRET";
      default : _zz_memory_to_writeBack_ENV_CTRL_1_string = "????";
    endcase
  end
  always @(*) begin
    case(_zz_execute_to_memory_ENV_CTRL)
      EnvCtrlEnum_NONE : _zz_execute_to_memory_ENV_CTRL_string = "NONE";
      EnvCtrlEnum_XRET : _zz_execute_to_memory_ENV_CTRL_string = "XRET";
      default : _zz_execute_to_memory_ENV_CTRL_string = "????";
    endcase
  end
  always @(*) begin
    case(_zz_execute_to_memory_ENV_CTRL_1)
      EnvCtrlEnum_NONE : _zz_execute_to_memory_ENV_CTRL_1_string = "NONE";
      EnvCtrlEnum_XRET : _zz_execute_to_memory_ENV_CTRL_1_string = "XRET";
      default : _zz_execute_to_memory_ENV_CTRL_1_string = "????";
    endcase
  end
  always @(*) begin
    case(decode_ENV_CTRL)
      EnvCtrlEnum_NONE : decode_ENV_CTRL_string = "NONE";
      EnvCtrlEnum_XRET : decode_ENV_CTRL_string = "XRET";
      default : decode_ENV_CTRL_string = "????";
    endcase
  end
  always @(*) begin
    case(_zz_decode_ENV_CTRL)
      EnvCtrlEnum_NONE : _zz_decode_ENV_CTRL_string = "NONE";
      EnvCtrlEnum_XRET : _zz_decode_ENV_CTRL_string = "XRET";
      default : _zz_decode_ENV_CTRL_string = "????";
    endcase
  end
  always @(*) begin
    case(_zz_decode_to_execute_ENV_CTRL)
      EnvCtrlEnum_NONE : _zz_decode_to_execute_ENV_CTRL_string = "NONE";
      EnvCtrlEnum_XRET : _zz_decode_to_execute_ENV_CTRL_string = "XRET";
      default : _zz_decode_to_execute_ENV_CTRL_string = "????";
    endcase
  end
  always @(*) begin
    case(_zz_decode_to_execute_ENV_CTRL_1)
      EnvCtrlEnum_NONE : _zz_decode_to_execute_ENV_CTRL_1_string = "NONE";
      EnvCtrlEnum_XRET : _zz_decode_to_execute_ENV_CTRL_1_string = "XRET";
      default : _zz_decode_to_execute_ENV_CTRL_1_string = "????";
    endcase
  end
  always @(*) begin
    case(decode_SRC2_CTRL)
      Src2CtrlEnum_RS : decode_SRC2_CTRL_string = "RS ";
      Src2CtrlEnum_IMI : decode_SRC2_CTRL_string = "IMI";
      Src2CtrlEnum_IMS : decode_SRC2_CTRL_string = "IMS";
      Src2CtrlEnum_PC : decode_SRC2_CTRL_string = "PC ";
      default : decode_SRC2_CTRL_string = "???";
    endcase
  end
  always @(*) begin
    case(_zz_decode_SRC2_CTRL)
      Src2CtrlEnum_RS : _zz_decode_SRC2_CTRL_string = "RS ";
      Src2CtrlEnum_IMI : _zz_decode_SRC2_CTRL_string = "IMI";
      Src2CtrlEnum_IMS : _zz_decode_SRC2_CTRL_string = "IMS";
      Src2CtrlEnum_PC : _zz_decode_SRC2_CTRL_string = "PC ";
      default : _zz_decode_SRC2_CTRL_string = "???";
    endcase
  end
  always @(*) begin
    case(_zz_decode_to_execute_SRC2_CTRL)
      Src2CtrlEnum_RS : _zz_decode_to_execute_SRC2_CTRL_string = "RS ";
      Src2CtrlEnum_IMI : _zz_decode_to_execute_SRC2_CTRL_string = "IMI";
      Src2CtrlEnum_IMS : _zz_decode_to_execute_SRC2_CTRL_string = "IMS";
      Src2CtrlEnum_PC : _zz_decode_to_execute_SRC2_CTRL_string = "PC ";
      default : _zz_decode_to_execute_SRC2_CTRL_string = "???";
    endcase
  end
  always @(*) begin
    case(_zz_decode_to_execute_SRC2_CTRL_1)
      Src2CtrlEnum_RS : _zz_decode_to_execute_SRC2_CTRL_1_string = "RS ";
      Src2CtrlEnum_IMI : _zz_decode_to_execute_SRC2_CTRL_1_string = "IMI";
      Src2CtrlEnum_IMS : _zz_decode_to_execute_SRC2_CTRL_1_string = "IMS";
      Src2CtrlEnum_PC : _zz_decode_to_execute_SRC2_CTRL_1_string = "PC ";
      default : _zz_decode_to_execute_SRC2_CTRL_1_string = "???";
    endcase
  end
  always @(*) begin
    case(decode_SRC1_CTRL)
      Src1CtrlEnum_RS : decode_SRC1_CTRL_string = "RS          ";
      Src1CtrlEnum_IMU : decode_SRC1_CTRL_string = "IMU         ";
      Src1CtrlEnum_PC_INCREMENT : decode_SRC1_CTRL_string = "PC_INCREMENT";
      Src1CtrlEnum_URS1 : decode_SRC1_CTRL_string = "URS1        ";
      default : decode_SRC1_CTRL_string = "????????????";
    endcase
  end
  always @(*) begin
    case(_zz_decode_SRC1_CTRL)
      Src1CtrlEnum_RS : _zz_decode_SRC1_CTRL_string = "RS          ";
      Src1CtrlEnum_IMU : _zz_decode_SRC1_CTRL_string = "IMU         ";
      Src1CtrlEnum_PC_INCREMENT : _zz_decode_SRC1_CTRL_string = "PC_INCREMENT";
      Src1CtrlEnum_URS1 : _zz_decode_SRC1_CTRL_string = "URS1        ";
      default : _zz_decode_SRC1_CTRL_string = "????????????";
    endcase
  end
  always @(*) begin
    case(_zz_decode_to_execute_SRC1_CTRL)
      Src1CtrlEnum_RS : _zz_decode_to_execute_SRC1_CTRL_string = "RS          ";
      Src1CtrlEnum_IMU : _zz_decode_to_execute_SRC1_CTRL_string = "IMU         ";
      Src1CtrlEnum_PC_INCREMENT : _zz_decode_to_execute_SRC1_CTRL_string = "PC_INCREMENT";
      Src1CtrlEnum_URS1 : _zz_decode_to_execute_SRC1_CTRL_string = "URS1        ";
      default : _zz_decode_to_execute_SRC1_CTRL_string = "????????????";
    endcase
  end
  always @(*) begin
    case(_zz_decode_to_execute_SRC1_CTRL_1)
      Src1CtrlEnum_RS : _zz_decode_to_execute_SRC1_CTRL_1_string = "RS          ";
      Src1CtrlEnum_IMU : _zz_decode_to_execute_SRC1_CTRL_1_string = "IMU         ";
      Src1CtrlEnum_PC_INCREMENT : _zz_decode_to_execute_SRC1_CTRL_1_string = "PC_INCREMENT";
      Src1CtrlEnum_URS1 : _zz_decode_to_execute_SRC1_CTRL_1_string = "URS1        ";
      default : _zz_decode_to_execute_SRC1_CTRL_1_string = "????????????";
    endcase
  end
  always @(*) begin
    case(execute_BRANCH_CTRL)
      BranchCtrlEnum_INC : execute_BRANCH_CTRL_string = "INC ";
      BranchCtrlEnum_B : execute_BRANCH_CTRL_string = "B   ";
      BranchCtrlEnum_JAL : execute_BRANCH_CTRL_string = "JAL ";
      BranchCtrlEnum_JALR : execute_BRANCH_CTRL_string = "JALR";
      default : execute_BRANCH_CTRL_string = "????";
    endcase
  end
  always @(*) begin
    case(_zz_execute_BRANCH_CTRL)
      BranchCtrlEnum_INC : _zz_execute_BRANCH_CTRL_string = "INC ";
      BranchCtrlEnum_B : _zz_execute_BRANCH_CTRL_string = "B   ";
      BranchCtrlEnum_JAL : _zz_execute_BRANCH_CTRL_string = "JAL ";
      BranchCtrlEnum_JALR : _zz_execute_BRANCH_CTRL_string = "JALR";
      default : _zz_execute_BRANCH_CTRL_string = "????";
    endcase
  end
  always @(*) begin
    case(execute_SHIFT_CTRL)
      ShiftCtrlEnum_DISABLE_1 : execute_SHIFT_CTRL_string = "DISABLE_1";
      ShiftCtrlEnum_SLL_1 : execute_SHIFT_CTRL_string = "SLL_1    ";
      ShiftCtrlEnum_SRL_1 : execute_SHIFT_CTRL_string = "SRL_1    ";
      ShiftCtrlEnum_SRA_1 : execute_SHIFT_CTRL_string = "SRA_1    ";
      default : execute_SHIFT_CTRL_string = "?????????";
    endcase
  end
  always @(*) begin
    case(_zz_execute_SHIFT_CTRL)
      ShiftCtrlEnum_DISABLE_1 : _zz_execute_SHIFT_CTRL_string = "DISABLE_1";
      ShiftCtrlEnum_SLL_1 : _zz_execute_SHIFT_CTRL_string = "SLL_1    ";
      ShiftCtrlEnum_SRL_1 : _zz_execute_SHIFT_CTRL_string = "SRL_1    ";
      ShiftCtrlEnum_SRA_1 : _zz_execute_SHIFT_CTRL_string = "SRA_1    ";
      default : _zz_execute_SHIFT_CTRL_string = "?????????";
    endcase
  end
  always @(*) begin
    case(execute_SRC2_CTRL)
      Src2CtrlEnum_RS : execute_SRC2_CTRL_string = "RS ";
      Src2CtrlEnum_IMI : execute_SRC2_CTRL_string = "IMI";
      Src2CtrlEnum_IMS : execute_SRC2_CTRL_string = "IMS";
      Src2CtrlEnum_PC : execute_SRC2_CTRL_string = "PC ";
      default : execute_SRC2_CTRL_string = "???";
    endcase
  end
  always @(*) begin
    case(_zz_execute_SRC2_CTRL)
      Src2CtrlEnum_RS : _zz_execute_SRC2_CTRL_string = "RS ";
      Src2CtrlEnum_IMI : _zz_execute_SRC2_CTRL_string = "IMI";
      Src2CtrlEnum_IMS : _zz_execute_SRC2_CTRL_string = "IMS";
      Src2CtrlEnum_PC : _zz_execute_SRC2_CTRL_string = "PC ";
      default : _zz_execute_SRC2_CTRL_string = "???";
    endcase
  end
  always @(*) begin
    case(execute_SRC1_CTRL)
      Src1CtrlEnum_RS : execute_SRC1_CTRL_string = "RS          ";
      Src1CtrlEnum_IMU : execute_SRC1_CTRL_string = "IMU         ";
      Src1CtrlEnum_PC_INCREMENT : execute_SRC1_CTRL_string = "PC_INCREMENT";
      Src1CtrlEnum_URS1 : execute_SRC1_CTRL_string = "URS1        ";
      default : execute_SRC1_CTRL_string = "????????????";
    endcase
  end
  always @(*) begin
    case(_zz_execute_SRC1_CTRL)
      Src1CtrlEnum_RS : _zz_execute_SRC1_CTRL_string = "RS          ";
      Src1CtrlEnum_IMU : _zz_execute_SRC1_CTRL_string = "IMU         ";
      Src1CtrlEnum_PC_INCREMENT : _zz_execute_SRC1_CTRL_string = "PC_INCREMENT";
      Src1CtrlEnum_URS1 : _zz_execute_SRC1_CTRL_string = "URS1        ";
      default : _zz_execute_SRC1_CTRL_string = "????????????";
    endcase
  end
  always @(*) begin
    case(execute_ALU_CTRL)
      AluCtrlEnum_ADD_SUB : execute_ALU_CTRL_string = "ADD_SUB ";
      AluCtrlEnum_SLT_SLTU : execute_ALU_CTRL_string = "SLT_SLTU";
      AluCtrlEnum_BITWISE : execute_ALU_CTRL_string = "BITWISE ";
      default : execute_ALU_CTRL_string = "????????";
    endcase
  end
  always @(*) begin
    case(_zz_execute_ALU_CTRL)
      AluCtrlEnum_ADD_SUB : _zz_execute_ALU_CTRL_string = "ADD_SUB ";
      AluCtrlEnum_SLT_SLTU : _zz_execute_ALU_CTRL_string = "SLT_SLTU";
      AluCtrlEnum_BITWISE : _zz_execute_ALU_CTRL_string = "BITWISE ";
      default : _zz_execute_ALU_CTRL_string = "????????";
    endcase
  end
  always @(*) begin
    case(execute_ALU_BITWISE_CTRL)
      AluBitwiseCtrlEnum_XOR_1 : execute_ALU_BITWISE_CTRL_string = "XOR_1";
      AluBitwiseCtrlEnum_OR_1 : execute_ALU_BITWISE_CTRL_string = "OR_1 ";
      AluBitwiseCtrlEnum_AND_1 : execute_ALU_BITWISE_CTRL_string = "AND_1";
      default : execute_ALU_BITWISE_CTRL_string = "?????";
    endcase
  end
  always @(*) begin
    case(_zz_execute_ALU_BITWISE_CTRL)
      AluBitwiseCtrlEnum_XOR_1 : _zz_execute_ALU_BITWISE_CTRL_string = "XOR_1";
      AluBitwiseCtrlEnum_OR_1 : _zz_execute_ALU_BITWISE_CTRL_string = "OR_1 ";
      AluBitwiseCtrlEnum_AND_1 : _zz_execute_ALU_BITWISE_CTRL_string = "AND_1";
      default : _zz_execute_ALU_BITWISE_CTRL_string = "?????";
    endcase
  end
  always @(*) begin
    case(_zz_decode_BRANCH_CTRL_1)
      BranchCtrlEnum_INC : _zz_decode_BRANCH_CTRL_1_string = "INC ";
      BranchCtrlEnum_B : _zz_decode_BRANCH_CTRL_1_string = "B   ";
      BranchCtrlEnum_JAL : _zz_decode_BRANCH_CTRL_1_string = "JAL ";
      BranchCtrlEnum_JALR : _zz_decode_BRANCH_CTRL_1_string = "JALR";
      default : _zz_decode_BRANCH_CTRL_1_string = "????";
    endcase
  end
  always @(*) begin
    case(_zz_decode_SHIFT_CTRL_1)
      ShiftCtrlEnum_DISABLE_1 : _zz_decode_SHIFT_CTRL_1_string = "DISABLE_1";
      ShiftCtrlEnum_SLL_1 : _zz_decode_SHIFT_CTRL_1_string = "SLL_1    ";
      ShiftCtrlEnum_SRL_1 : _zz_decode_SHIFT_CTRL_1_string = "SRL_1    ";
      ShiftCtrlEnum_SRA_1 : _zz_decode_SHIFT_CTRL_1_string = "SRA_1    ";
      default : _zz_decode_SHIFT_CTRL_1_string = "?????????";
    endcase
  end
  always @(*) begin
    case(_zz_decode_ALU_BITWISE_CTRL_1)
      AluBitwiseCtrlEnum_XOR_1 : _zz_decode_ALU_BITWISE_CTRL_1_string = "XOR_1";
      AluBitwiseCtrlEnum_OR_1 : _zz_decode_ALU_BITWISE_CTRL_1_string = "OR_1 ";
      AluBitwiseCtrlEnum_AND_1 : _zz_decode_ALU_BITWISE_CTRL_1_string = "AND_1";
      default : _zz_decode_ALU_BITWISE_CTRL_1_string = "?????";
    endcase
  end
  always @(*) begin
    case(_zz_decode_ALU_CTRL_1)
      AluCtrlEnum_ADD_SUB : _zz_decode_ALU_CTRL_1_string = "ADD_SUB ";
      AluCtrlEnum_SLT_SLTU : _zz_decode_ALU_CTRL_1_string = "SLT_SLTU";
      AluCtrlEnum_BITWISE : _zz_decode_ALU_CTRL_1_string = "BITWISE ";
      default : _zz_decode_ALU_CTRL_1_string = "????????";
    endcase
  end
  always @(*) begin
    case(_zz_decode_ENV_CTRL_1)
      EnvCtrlEnum_NONE : _zz_decode_ENV_CTRL_1_string = "NONE";
      EnvCtrlEnum_XRET : _zz_decode_ENV_CTRL_1_string = "XRET";
      default : _zz_decode_ENV_CTRL_1_string = "????";
    endcase
  end
  always @(*) begin
    case(_zz_decode_SRC2_CTRL_1)
      Src2CtrlEnum_RS : _zz_decode_SRC2_CTRL_1_string = "RS ";
      Src2CtrlEnum_IMI : _zz_decode_SRC2_CTRL_1_string = "IMI";
      Src2CtrlEnum_IMS : _zz_decode_SRC2_CTRL_1_string = "IMS";
      Src2CtrlEnum_PC : _zz_decode_SRC2_CTRL_1_string = "PC ";
      default : _zz_decode_SRC2_CTRL_1_string = "???";
    endcase
  end
  always @(*) begin
    case(_zz_decode_SRC1_CTRL_1)
      Src1CtrlEnum_RS : _zz_decode_SRC1_CTRL_1_string = "RS          ";
      Src1CtrlEnum_IMU : _zz_decode_SRC1_CTRL_1_string = "IMU         ";
      Src1CtrlEnum_PC_INCREMENT : _zz_decode_SRC1_CTRL_1_string = "PC_INCREMENT";
      Src1CtrlEnum_URS1 : _zz_decode_SRC1_CTRL_1_string = "URS1        ";
      default : _zz_decode_SRC1_CTRL_1_string = "????????????";
    endcase
  end
  always @(*) begin
    case(memory_ENV_CTRL)
      EnvCtrlEnum_NONE : memory_ENV_CTRL_string = "NONE";
      EnvCtrlEnum_XRET : memory_ENV_CTRL_string = "XRET";
      default : memory_ENV_CTRL_string = "????";
    endcase
  end
  always @(*) begin
    case(_zz_memory_ENV_CTRL)
      EnvCtrlEnum_NONE : _zz_memory_ENV_CTRL_string = "NONE";
      EnvCtrlEnum_XRET : _zz_memory_ENV_CTRL_string = "XRET";
      default : _zz_memory_ENV_CTRL_string = "????";
    endcase
  end
  always @(*) begin
    case(execute_ENV_CTRL)
      EnvCtrlEnum_NONE : execute_ENV_CTRL_string = "NONE";
      EnvCtrlEnum_XRET : execute_ENV_CTRL_string = "XRET";
      default : execute_ENV_CTRL_string = "????";
    endcase
  end
  always @(*) begin
    case(_zz_execute_ENV_CTRL)
      EnvCtrlEnum_NONE : _zz_execute_ENV_CTRL_string = "NONE";
      EnvCtrlEnum_XRET : _zz_execute_ENV_CTRL_string = "XRET";
      default : _zz_execute_ENV_CTRL_string = "????";
    endcase
  end
  always @(*) begin
    case(writeBack_ENV_CTRL)
      EnvCtrlEnum_NONE : writeBack_ENV_CTRL_string = "NONE";
      EnvCtrlEnum_XRET : writeBack_ENV_CTRL_string = "XRET";
      default : writeBack_ENV_CTRL_string = "????";
    endcase
  end
  always @(*) begin
    case(_zz_writeBack_ENV_CTRL)
      EnvCtrlEnum_NONE : _zz_writeBack_ENV_CTRL_string = "NONE";
      EnvCtrlEnum_XRET : _zz_writeBack_ENV_CTRL_string = "XRET";
      default : _zz_writeBack_ENV_CTRL_string = "????";
    endcase
  end
  always @(*) begin
    case(_zz_decode_SRC1_CTRL_2)
      Src1CtrlEnum_RS : _zz_decode_SRC1_CTRL_2_string = "RS          ";
      Src1CtrlEnum_IMU : _zz_decode_SRC1_CTRL_2_string = "IMU         ";
      Src1CtrlEnum_PC_INCREMENT : _zz_decode_SRC1_CTRL_2_string = "PC_INCREMENT";
      Src1CtrlEnum_URS1 : _zz_decode_SRC1_CTRL_2_string = "URS1        ";
      default : _zz_decode_SRC1_CTRL_2_string = "????????????";
    endcase
  end
  always @(*) begin
    case(_zz_decode_SRC2_CTRL_2)
      Src2CtrlEnum_RS : _zz_decode_SRC2_CTRL_2_string = "RS ";
      Src2CtrlEnum_IMI : _zz_decode_SRC2_CTRL_2_string = "IMI";
      Src2CtrlEnum_IMS : _zz_decode_SRC2_CTRL_2_string = "IMS";
      Src2CtrlEnum_PC : _zz_decode_SRC2_CTRL_2_string = "PC ";
      default : _zz_decode_SRC2_CTRL_2_string = "???";
    endcase
  end
  always @(*) begin
    case(_zz_decode_ENV_CTRL_2)
      EnvCtrlEnum_NONE : _zz_decode_ENV_CTRL_2_string = "NONE";
      EnvCtrlEnum_XRET : _zz_decode_ENV_CTRL_2_string = "XRET";
      default : _zz_decode_ENV_CTRL_2_string = "????";
    endcase
  end
  always @(*) begin
    case(_zz_decode_ALU_CTRL_2)
      AluCtrlEnum_ADD_SUB : _zz_decode_ALU_CTRL_2_string = "ADD_SUB ";
      AluCtrlEnum_SLT_SLTU : _zz_decode_ALU_CTRL_2_string = "SLT_SLTU";
      AluCtrlEnum_BITWISE : _zz_decode_ALU_CTRL_2_string = "BITWISE ";
      default : _zz_decode_ALU_CTRL_2_string = "????????";
    endcase
  end
  always @(*) begin
    case(_zz_decode_ALU_BITWISE_CTRL_2)
      AluBitwiseCtrlEnum_XOR_1 : _zz_decode_ALU_BITWISE_CTRL_2_string = "XOR_1";
      AluBitwiseCtrlEnum_OR_1 : _zz_decode_ALU_BITWISE_CTRL_2_string = "OR_1 ";
      AluBitwiseCtrlEnum_AND_1 : _zz_decode_ALU_BITWISE_CTRL_2_string = "AND_1";
      default : _zz_decode_ALU_BITWISE_CTRL_2_string = "?????";
    endcase
  end
  always @(*) begin
    case(_zz_decode_SHIFT_CTRL_2)
      ShiftCtrlEnum_DISABLE_1 : _zz_decode_SHIFT_CTRL_2_string = "DISABLE_1";
      ShiftCtrlEnum_SLL_1 : _zz_decode_SHIFT_CTRL_2_string = "SLL_1    ";
      ShiftCtrlEnum_SRL_1 : _zz_decode_SHIFT_CTRL_2_string = "SRL_1    ";
      ShiftCtrlEnum_SRA_1 : _zz_decode_SHIFT_CTRL_2_string = "SRA_1    ";
      default : _zz_decode_SHIFT_CTRL_2_string = "?????????";
    endcase
  end
  always @(*) begin
    case(_zz_decode_BRANCH_CTRL_2)
      BranchCtrlEnum_INC : _zz_decode_BRANCH_CTRL_2_string = "INC ";
      BranchCtrlEnum_B : _zz_decode_BRANCH_CTRL_2_string = "B   ";
      BranchCtrlEnum_JAL : _zz_decode_BRANCH_CTRL_2_string = "JAL ";
      BranchCtrlEnum_JALR : _zz_decode_BRANCH_CTRL_2_string = "JALR";
      default : _zz_decode_BRANCH_CTRL_2_string = "????";
    endcase
  end
  always @(*) begin
    case(decode_to_execute_SRC1_CTRL)
      Src1CtrlEnum_RS : decode_to_execute_SRC1_CTRL_string = "RS          ";
      Src1CtrlEnum_IMU : decode_to_execute_SRC1_CTRL_string = "IMU         ";
      Src1CtrlEnum_PC_INCREMENT : decode_to_execute_SRC1_CTRL_string = "PC_INCREMENT";
      Src1CtrlEnum_URS1 : decode_to_execute_SRC1_CTRL_string = "URS1        ";
      default : decode_to_execute_SRC1_CTRL_string = "????????????";
    endcase
  end
  always @(*) begin
    case(decode_to_execute_SRC2_CTRL)
      Src2CtrlEnum_RS : decode_to_execute_SRC2_CTRL_string = "RS ";
      Src2CtrlEnum_IMI : decode_to_execute_SRC2_CTRL_string = "IMI";
      Src2CtrlEnum_IMS : decode_to_execute_SRC2_CTRL_string = "IMS";
      Src2CtrlEnum_PC : decode_to_execute_SRC2_CTRL_string = "PC ";
      default : decode_to_execute_SRC2_CTRL_string = "???";
    endcase
  end
  always @(*) begin
    case(decode_to_execute_ENV_CTRL)
      EnvCtrlEnum_NONE : decode_to_execute_ENV_CTRL_string = "NONE";
      EnvCtrlEnum_XRET : decode_to_execute_ENV_CTRL_string = "XRET";
      default : decode_to_execute_ENV_CTRL_string = "????";
    endcase
  end
  always @(*) begin
    case(execute_to_memory_ENV_CTRL)
      EnvCtrlEnum_NONE : execute_to_memory_ENV_CTRL_string = "NONE";
      EnvCtrlEnum_XRET : execute_to_memory_ENV_CTRL_string = "XRET";
      default : execute_to_memory_ENV_CTRL_string = "????";
    endcase
  end
  always @(*) begin
    case(memory_to_writeBack_ENV_CTRL)
      EnvCtrlEnum_NONE : memory_to_writeBack_ENV_CTRL_string = "NONE";
      EnvCtrlEnum_XRET : memory_to_writeBack_ENV_CTRL_string = "XRET";
      default : memory_to_writeBack_ENV_CTRL_string = "????";
    endcase
  end
  always @(*) begin
    case(decode_to_execute_ALU_CTRL)
      AluCtrlEnum_ADD_SUB : decode_to_execute_ALU_CTRL_string = "ADD_SUB ";
      AluCtrlEnum_SLT_SLTU : decode_to_execute_ALU_CTRL_string = "SLT_SLTU";
      AluCtrlEnum_BITWISE : decode_to_execute_ALU_CTRL_string = "BITWISE ";
      default : decode_to_execute_ALU_CTRL_string = "????????";
    endcase
  end
  always @(*) begin
    case(decode_to_execute_ALU_BITWISE_CTRL)
      AluBitwiseCtrlEnum_XOR_1 : decode_to_execute_ALU_BITWISE_CTRL_string = "XOR_1";
      AluBitwiseCtrlEnum_OR_1 : decode_to_execute_ALU_BITWISE_CTRL_string = "OR_1 ";
      AluBitwiseCtrlEnum_AND_1 : decode_to_execute_ALU_BITWISE_CTRL_string = "AND_1";
      default : decode_to_execute_ALU_BITWISE_CTRL_string = "?????";
    endcase
  end
  always @(*) begin
    case(decode_to_execute_SHIFT_CTRL)
      ShiftCtrlEnum_DISABLE_1 : decode_to_execute_SHIFT_CTRL_string = "DISABLE_1";
      ShiftCtrlEnum_SLL_1 : decode_to_execute_SHIFT_CTRL_string = "SLL_1    ";
      ShiftCtrlEnum_SRL_1 : decode_to_execute_SHIFT_CTRL_string = "SRL_1    ";
      ShiftCtrlEnum_SRA_1 : decode_to_execute_SHIFT_CTRL_string = "SRA_1    ";
      default : decode_to_execute_SHIFT_CTRL_string = "?????????";
    endcase
  end
  always @(*) begin
    case(decode_to_execute_BRANCH_CTRL)
      BranchCtrlEnum_INC : decode_to_execute_BRANCH_CTRL_string = "INC ";
      BranchCtrlEnum_B : decode_to_execute_BRANCH_CTRL_string = "B   ";
      BranchCtrlEnum_JAL : decode_to_execute_BRANCH_CTRL_string = "JAL ";
      BranchCtrlEnum_JALR : decode_to_execute_BRANCH_CTRL_string = "JALR";
      default : decode_to_execute_BRANCH_CTRL_string = "????";
    endcase
  end
  `endif

  assign memory_MEMORY_READ_DATA = dBus_rsp_data;
  assign execute_BRANCH_CALC = {execute_BranchPlugin_branchAdder[31 : 1],1'b0};
  assign execute_BRANCH_DO = _zz_execute_BRANCH_DO_1;
  assign writeBack_REGFILE_WRITE_DATA = memory_to_writeBack_REGFILE_WRITE_DATA;
  assign execute_REGFILE_WRITE_DATA = _zz_execute_REGFILE_WRITE_DATA;
  assign memory_MEMORY_ADDRESS_LOW = execute_to_memory_MEMORY_ADDRESS_LOW;
  assign execute_MEMORY_ADDRESS_LOW = dBus_cmd_payload_address[1 : 0];
  assign decode_SRC2_FORCE_ZERO = (decode_SRC_ADD_ZERO && (! decode_SRC_USE_SUB_LESS));
  assign decode_BRANCH_CTRL = _zz_decode_BRANCH_CTRL;
  assign _zz_decode_to_execute_BRANCH_CTRL = _zz_decode_to_execute_BRANCH_CTRL_1;
  assign decode_SHIFT_CTRL = _zz_decode_SHIFT_CTRL;
  assign _zz_decode_to_execute_SHIFT_CTRL = _zz_decode_to_execute_SHIFT_CTRL_1;
  assign decode_ALU_BITWISE_CTRL = _zz_decode_ALU_BITWISE_CTRL;
  assign _zz_decode_to_execute_ALU_BITWISE_CTRL = _zz_decode_to_execute_ALU_BITWISE_CTRL_1;
  assign decode_SRC_LESS_UNSIGNED = _zz_decode_SRC_LESS_UNSIGNED[17];
  assign decode_ALU_CTRL = _zz_decode_ALU_CTRL;
  assign _zz_decode_to_execute_ALU_CTRL = _zz_decode_to_execute_ALU_CTRL_1;
  assign _zz_memory_to_writeBack_ENV_CTRL = _zz_memory_to_writeBack_ENV_CTRL_1;
  assign _zz_execute_to_memory_ENV_CTRL = _zz_execute_to_memory_ENV_CTRL_1;
  assign decode_ENV_CTRL = _zz_decode_ENV_CTRL;
  assign _zz_decode_to_execute_ENV_CTRL = _zz_decode_to_execute_ENV_CTRL_1;
  assign decode_IS_CSR = _zz_decode_SRC_LESS_UNSIGNED[13];
  assign decode_MEMORY_STORE = _zz_decode_SRC_LESS_UNSIGNED[10];
  assign execute_BYPASSABLE_MEMORY_STAGE = decode_to_execute_BYPASSABLE_MEMORY_STAGE;
  assign decode_BYPASSABLE_MEMORY_STAGE = _zz_decode_SRC_LESS_UNSIGNED[9];
  assign decode_BYPASSABLE_EXECUTE_STAGE = _zz_decode_SRC_LESS_UNSIGNED[8];
  assign decode_SRC2_CTRL = _zz_decode_SRC2_CTRL;
  assign _zz_decode_to_execute_SRC2_CTRL = _zz_decode_to_execute_SRC2_CTRL_1;
  assign decode_MEMORY_ENABLE = _zz_decode_SRC_LESS_UNSIGNED[3];
  assign decode_SRC1_CTRL = _zz_decode_SRC1_CTRL;
  assign _zz_decode_to_execute_SRC1_CTRL = _zz_decode_to_execute_SRC1_CTRL_1;
  assign decode_CSR_READ_OPCODE = (decode_INSTRUCTION[13 : 7] != 7'h20);
  assign decode_CSR_WRITE_OPCODE = (! (((decode_INSTRUCTION[14 : 13] == 2'b01) && (decode_INSTRUCTION[19 : 15] == 5'h0)) || ((decode_INSTRUCTION[14 : 13] == 2'b11) && (decode_INSTRUCTION[19 : 15] == 5'h0))));
  assign writeBack_FORMAL_PC_NEXT = memory_to_writeBack_FORMAL_PC_NEXT;
  assign memory_FORMAL_PC_NEXT = execute_to_memory_FORMAL_PC_NEXT;
  assign execute_FORMAL_PC_NEXT = decode_to_execute_FORMAL_PC_NEXT;
  assign decode_FORMAL_PC_NEXT = (decode_PC + 32'h00000004);
  assign memory_PC = execute_to_memory_PC;
  assign memory_BRANCH_CALC = execute_to_memory_BRANCH_CALC;
  assign memory_BRANCH_DO = execute_to_memory_BRANCH_DO;
  assign execute_PC = decode_to_execute_PC;
  assign execute_RS1 = decode_to_execute_RS1;
  assign execute_BRANCH_CTRL = _zz_execute_BRANCH_CTRL;
  assign decode_RS2_USE = _zz_decode_SRC_LESS_UNSIGNED[12];
  assign decode_RS1_USE = _zz_decode_SRC_LESS_UNSIGNED[4];
  assign execute_REGFILE_WRITE_VALID = decode_to_execute_REGFILE_WRITE_VALID;
  assign execute_BYPASSABLE_EXECUTE_STAGE = decode_to_execute_BYPASSABLE_EXECUTE_STAGE;
  assign _zz_decode_RS2 = memory_REGFILE_WRITE_DATA;
  assign memory_REGFILE_WRITE_VALID = execute_to_memory_REGFILE_WRITE_VALID;
  assign memory_INSTRUCTION = execute_to_memory_INSTRUCTION;
  assign memory_BYPASSABLE_MEMORY_STAGE = execute_to_memory_BYPASSABLE_MEMORY_STAGE;
  assign writeBack_REGFILE_WRITE_VALID = memory_to_writeBack_REGFILE_WRITE_VALID;
  always @(*) begin
    decode_RS2 = decode_RegFilePlugin_rs2Data;
    if(HazardSimplePlugin_writeBackBuffer_valid) begin
      if(HazardSimplePlugin_addr1Match) begin
        decode_RS2 = HazardSimplePlugin_writeBackBuffer_payload_data;
      end
    end
    if(when_HazardSimplePlugin_l45) begin
      if(when_HazardSimplePlugin_l47) begin
        if(when_HazardSimplePlugin_l51) begin
          decode_RS2 = _zz_decode_RS2_2;
        end
      end
    end
    if(when_HazardSimplePlugin_l45_1) begin
      if(memory_BYPASSABLE_MEMORY_STAGE) begin
        if(when_HazardSimplePlugin_l51_1) begin
          decode_RS2 = _zz_decode_RS2;
        end
      end
    end
    if(when_HazardSimplePlugin_l45_2) begin
      if(execute_BYPASSABLE_EXECUTE_STAGE) begin
        if(when_HazardSimplePlugin_l51_2) begin
          decode_RS2 = _zz_decode_RS2_1;
        end
      end
    end
  end

  always @(*) begin
    decode_RS1 = decode_RegFilePlugin_rs1Data;
    if(HazardSimplePlugin_writeBackBuffer_valid) begin
      if(HazardSimplePlugin_addr0Match) begin
        decode_RS1 = HazardSimplePlugin_writeBackBuffer_payload_data;
      end
    end
    if(when_HazardSimplePlugin_l45) begin
      if(when_HazardSimplePlugin_l47) begin
        if(when_HazardSimplePlugin_l48) begin
          decode_RS1 = _zz_decode_RS2_2;
        end
      end
    end
    if(when_HazardSimplePlugin_l45_1) begin
      if(memory_BYPASSABLE_MEMORY_STAGE) begin
        if(when_HazardSimplePlugin_l48_1) begin
          decode_RS1 = _zz_decode_RS2;
        end
      end
    end
    if(when_HazardSimplePlugin_l45_2) begin
      if(execute_BYPASSABLE_EXECUTE_STAGE) begin
        if(when_HazardSimplePlugin_l48_2) begin
          decode_RS1 = _zz_decode_RS2_1;
        end
      end
    end
  end

  assign memory_REGFILE_WRITE_DATA = execute_to_memory_REGFILE_WRITE_DATA;
  assign execute_SHIFT_CTRL = _zz_execute_SHIFT_CTRL;
  assign execute_SRC_LESS_UNSIGNED = decode_to_execute_SRC_LESS_UNSIGNED;
  assign execute_SRC2_FORCE_ZERO = decode_to_execute_SRC2_FORCE_ZERO;
  assign execute_SRC_USE_SUB_LESS = decode_to_execute_SRC_USE_SUB_LESS;
  assign _zz_execute_to_memory_PC = execute_PC;
  assign execute_SRC2_CTRL = _zz_execute_SRC2_CTRL;
  assign execute_SRC1_CTRL = _zz_execute_SRC1_CTRL;
  assign decode_SRC_USE_SUB_LESS = _zz_decode_SRC_LESS_UNSIGNED[2];
  assign decode_SRC_ADD_ZERO = _zz_decode_SRC_LESS_UNSIGNED[20];
  assign execute_SRC_ADD_SUB = execute_SrcPlugin_addSub;
  assign execute_SRC_LESS = execute_SrcPlugin_less;
  assign execute_ALU_CTRL = _zz_execute_ALU_CTRL;
  assign execute_SRC2 = _zz_execute_SRC2_4;
  assign execute_ALU_BITWISE_CTRL = _zz_execute_ALU_BITWISE_CTRL;
  assign _zz_lastStageRegFileWrite_payload_address = writeBack_INSTRUCTION;
  assign _zz_lastStageRegFileWrite_valid = writeBack_REGFILE_WRITE_VALID;
  always @(*) begin
    _zz_1 = 1'b0;
    if(lastStageRegFileWrite_valid) begin
      _zz_1 = 1'b1;
    end
  end

  assign decode_INSTRUCTION_ANTICIPATED = (decode_arbitration_isStuck ? decode_INSTRUCTION : IBusSimplePlugin_iBusRsp_output_payload_rsp_inst);
  always @(*) begin
    decode_REGFILE_WRITE_VALID = _zz_decode_SRC_LESS_UNSIGNED[7];
    if(when_RegFilePlugin_l63) begin
      decode_REGFILE_WRITE_VALID = 1'b0;
    end
  end

  always @(*) begin
    _zz_decode_RS2_1 = execute_REGFILE_WRITE_DATA;
    if(when_CsrPlugin_l1587) begin
      _zz_decode_RS2_1 = CsrPlugin_csrMapping_readDataSignal;
    end
    if(when_ShiftPlugins_l169) begin
      _zz_decode_RS2_1 = _zz_decode_RS2_3;
    end
  end

  assign execute_SRC1 = _zz_execute_SRC1;
  assign execute_CSR_READ_OPCODE = decode_to_execute_CSR_READ_OPCODE;
  assign execute_CSR_WRITE_OPCODE = decode_to_execute_CSR_WRITE_OPCODE;
  assign execute_IS_CSR = decode_to_execute_IS_CSR;
  assign memory_ENV_CTRL = _zz_memory_ENV_CTRL;
  assign execute_ENV_CTRL = _zz_execute_ENV_CTRL;
  assign writeBack_ENV_CTRL = _zz_writeBack_ENV_CTRL;
  always @(*) begin
    _zz_decode_RS2_2 = writeBack_REGFILE_WRITE_DATA;
    if(when_DBusSimplePlugin_l566) begin
      _zz_decode_RS2_2 = writeBack_DBusSimplePlugin_rspFormated;
    end
  end

  assign writeBack_MEMORY_ENABLE = memory_to_writeBack_MEMORY_ENABLE;
  assign writeBack_MEMORY_ADDRESS_LOW = memory_to_writeBack_MEMORY_ADDRESS_LOW;
  assign writeBack_MEMORY_READ_DATA = memory_to_writeBack_MEMORY_READ_DATA;
  assign memory_MEMORY_STORE = execute_to_memory_MEMORY_STORE;
  assign memory_MEMORY_ENABLE = execute_to_memory_MEMORY_ENABLE;
  assign execute_SRC_ADD = execute_SrcPlugin_addSub;
  assign execute_RS2 = decode_to_execute_RS2;
  assign execute_INSTRUCTION = decode_to_execute_INSTRUCTION;
  assign execute_MEMORY_STORE = decode_to_execute_MEMORY_STORE;
  assign execute_MEMORY_ENABLE = decode_to_execute_MEMORY_ENABLE;
  assign execute_ALIGNEMENT_FAULT = 1'b0;
  always @(*) begin
    _zz_memory_to_writeBack_FORMAL_PC_NEXT = memory_FORMAL_PC_NEXT;
    if(BranchPlugin_jumpInterface_valid) begin
      _zz_memory_to_writeBack_FORMAL_PC_NEXT = BranchPlugin_jumpInterface_payload;
    end
  end

  assign decode_PC = IBusSimplePlugin_injector_decodeInput_payload_pc;
  assign decode_INSTRUCTION = IBusSimplePlugin_injector_decodeInput_payload_rsp_inst;
  assign writeBack_PC = memory_to_writeBack_PC;
  assign writeBack_INSTRUCTION = memory_to_writeBack_INSTRUCTION;
  assign decode_arbitration_haltItself = 1'b0;
  always @(*) begin
    decode_arbitration_haltByOther = 1'b0;
    if(CsrPlugin_pipelineLiberator_active) begin
      decode_arbitration_haltByOther = 1'b1;
    end
    if(when_CsrPlugin_l1527) begin
      decode_arbitration_haltByOther = 1'b1;
    end
    if(when_HazardSimplePlugin_l113) begin
      decode_arbitration_haltByOther = 1'b1;
    end
  end

  always @(*) begin
    decode_arbitration_removeIt = 1'b0;
    if(decode_arbitration_isFlushed) begin
      decode_arbitration_removeIt = 1'b1;
    end
  end

  assign decode_arbitration_flushIt = 1'b0;
  assign decode_arbitration_flushNext = 1'b0;
  always @(*) begin
    execute_arbitration_haltItself = 1'b0;
    if(when_DBusSimplePlugin_l435) begin
      execute_arbitration_haltItself = 1'b1;
    end
    if(when_CsrPlugin_l1591) begin
      if(execute_CsrPlugin_blockedBySideEffects) begin
        execute_arbitration_haltItself = 1'b1;
      end
    end
    if(when_ShiftPlugins_l169) begin
      if(when_ShiftPlugins_l184) begin
        execute_arbitration_haltItself = 1'b1;
      end
    end
  end

  assign execute_arbitration_haltByOther = 1'b0;
  always @(*) begin
    execute_arbitration_removeIt = 1'b0;
    if(execute_arbitration_isFlushed) begin
      execute_arbitration_removeIt = 1'b1;
    end
  end

  assign execute_arbitration_flushIt = 1'b0;
  assign execute_arbitration_flushNext = 1'b0;
  always @(*) begin
    memory_arbitration_haltItself = 1'b0;
    if(when_DBusSimplePlugin_l490) begin
      memory_arbitration_haltItself = 1'b1;
    end
  end

  assign memory_arbitration_haltByOther = 1'b0;
  always @(*) begin
    memory_arbitration_removeIt = 1'b0;
    if(memory_arbitration_isFlushed) begin
      memory_arbitration_removeIt = 1'b1;
    end
  end

  assign memory_arbitration_flushIt = 1'b0;
  always @(*) begin
    memory_arbitration_flushNext = 1'b0;
    if(BranchPlugin_jumpInterface_valid) begin
      memory_arbitration_flushNext = 1'b1;
    end
  end

  assign writeBack_arbitration_haltItself = 1'b0;
  assign writeBack_arbitration_haltByOther = 1'b0;
  always @(*) begin
    writeBack_arbitration_removeIt = 1'b0;
    if(writeBack_arbitration_isFlushed) begin
      writeBack_arbitration_removeIt = 1'b1;
    end
  end

  assign writeBack_arbitration_flushIt = 1'b0;
  always @(*) begin
    writeBack_arbitration_flushNext = 1'b0;
    if(when_CsrPlugin_l1390) begin
      writeBack_arbitration_flushNext = 1'b1;
    end
    if(when_CsrPlugin_l1456) begin
      writeBack_arbitration_flushNext = 1'b1;
    end
  end

  assign lastStageInstruction = writeBack_INSTRUCTION;
  assign lastStagePc = writeBack_PC;
  assign lastStageIsValid = writeBack_arbitration_isValid;
  assign lastStageIsFiring = writeBack_arbitration_isFiring;
  always @(*) begin
    IBusSimplePlugin_fetcherHalt = 1'b0;
    if(when_CsrPlugin_l1390) begin
      IBusSimplePlugin_fetcherHalt = 1'b1;
    end
    if(when_CsrPlugin_l1456) begin
      IBusSimplePlugin_fetcherHalt = 1'b1;
    end
  end

  assign IBusSimplePlugin_forceNoDecodeCond = 1'b0;
  always @(*) begin
    IBusSimplePlugin_incomingInstruction = 1'b0;
    if(IBusSimplePlugin_iBusRsp_stages_1_input_valid) begin
      IBusSimplePlugin_incomingInstruction = 1'b1;
    end
    if(IBusSimplePlugin_injector_decodeInput_valid) begin
      IBusSimplePlugin_incomingInstruction = 1'b1;
    end
  end

  always @(*) begin
    CsrPlugin_csrMapping_allowCsrSignal = 1'b0;
    if(when_CsrPlugin_l1702) begin
      CsrPlugin_csrMapping_allowCsrSignal = 1'b1;
    end
    if(when_CsrPlugin_l1709) begin
      CsrPlugin_csrMapping_allowCsrSignal = 1'b1;
    end
  end

  assign CsrPlugin_csrMapping_doForceFailCsr = 1'b0;
  assign CsrPlugin_csrMapping_readDataSignal = CsrPlugin_csrMapping_readDataInit;
  assign CsrPlugin_inWfi = 1'b0;
  assign CsrPlugin_thirdPartyWake = 1'b0;
  always @(*) begin
    CsrPlugin_jumpInterface_valid = 1'b0;
    if(when_CsrPlugin_l1390) begin
      CsrPlugin_jumpInterface_valid = 1'b1;
    end
    if(when_CsrPlugin_l1456) begin
      CsrPlugin_jumpInterface_valid = 1'b1;
    end
  end

  always @(*) begin
    CsrPlugin_jumpInterface_payload = 32'bxxxxxxxxxxxxxxxxxxxxxxxxxxxxxxxx;
    if(when_CsrPlugin_l1390) begin
      CsrPlugin_jumpInterface_payload = {CsrPlugin_xtvec_base,2'b00};
    end
    if(when_CsrPlugin_l1456) begin
      case(switch_CsrPlugin_l1460)
        2'b11 : begin
          CsrPlugin_jumpInterface_payload = CsrPlugin_mepc;
        end
        default : begin
        end
      endcase
    end
  end

  assign CsrPlugin_forceMachineWire = 1'b0;
  assign CsrPlugin_allowInterrupts = 1'b1;
  assign CsrPlugin_allowException = 1'b1;
  assign CsrPlugin_allowEbreakException = 1'b1;
  assign CsrPlugin_xretAwayFromMachine = 1'b0;
  assign BranchPlugin_inDebugNoFetchFlag = 1'b0;
  assign IBusSimplePlugin_externalFlush = (|{writeBack_arbitration_flushNext,{memory_arbitration_flushNext,{execute_arbitration_flushNext,decode_arbitration_flushNext}}});
  assign IBusSimplePlugin_jump_pcLoad_valid = (|{BranchPlugin_jumpInterface_valid,CsrPlugin_jumpInterface_valid});
  assign _zz_IBusSimplePlugin_jump_pcLoad_payload = {BranchPlugin_jumpInterface_valid,CsrPlugin_jumpInterface_valid};
  assign IBusSimplePlugin_jump_pcLoad_payload = (_zz_IBusSimplePlugin_jump_pcLoad_payload_1[0] ? CsrPlugin_jumpInterface_payload : BranchPlugin_jumpInterface_payload);
  always @(*) begin
    IBusSimplePlugin_fetchPc_correction = 1'b0;
    if(IBusSimplePlugin_jump_pcLoad_valid) begin
      IBusSimplePlugin_fetchPc_correction = 1'b1;
    end
  end

  assign IBusSimplePlugin_fetchPc_output_fire = (IBusSimplePlugin_fetchPc_output_valid && IBusSimplePlugin_fetchPc_output_ready);
  assign IBusSimplePlugin_fetchPc_corrected = (IBusSimplePlugin_fetchPc_correction || IBusSimplePlugin_fetchPc_correctionReg);
  always @(*) begin
    IBusSimplePlugin_fetchPc_pcRegPropagate = 1'b0;
    if(IBusSimplePlugin_iBusRsp_stages_1_input_ready) begin
      IBusSimplePlugin_fetchPc_pcRegPropagate = 1'b1;
    end
  end

  assign when_Fetcher_l133 = (IBusSimplePlugin_fetchPc_correction || IBusSimplePlugin_fetchPc_pcRegPropagate);
  assign when_Fetcher_l133_1 = ((! IBusSimplePlugin_fetchPc_output_valid) && IBusSimplePlugin_fetchPc_output_ready);
  always @(*) begin
    IBusSimplePlugin_fetchPc_pc = (IBusSimplePlugin_fetchPc_pcReg + _zz_IBusSimplePlugin_fetchPc_pc);
    if(IBusSimplePlugin_jump_pcLoad_valid) begin
      IBusSimplePlugin_fetchPc_pc = IBusSimplePlugin_jump_pcLoad_payload;
    end
    IBusSimplePlugin_fetchPc_pc[0] = 1'b0;
    IBusSimplePlugin_fetchPc_pc[1] = 1'b0;
  end

  always @(*) begin
    IBusSimplePlugin_fetchPc_flushed = 1'b0;
    if(IBusSimplePlugin_jump_pcLoad_valid) begin
      IBusSimplePlugin_fetchPc_flushed = 1'b1;
    end
  end

  assign when_Fetcher_l160 = (IBusSimplePlugin_fetchPc_booted && ((IBusSimplePlugin_fetchPc_output_ready || IBusSimplePlugin_fetchPc_correction) || IBusSimplePlugin_fetchPc_pcRegPropagate));
  assign IBusSimplePlugin_fetchPc_output_valid = ((! IBusSimplePlugin_fetcherHalt) && IBusSimplePlugin_fetchPc_booted);
  assign IBusSimplePlugin_fetchPc_output_payload = IBusSimplePlugin_fetchPc_pc;
  assign IBusSimplePlugin_iBusRsp_redoFetch = 1'b0;
  assign IBusSimplePlugin_iBusRsp_stages_0_input_valid = IBusSimplePlugin_fetchPc_output_valid;
  assign IBusSimplePlugin_fetchPc_output_ready = IBusSimplePlugin_iBusRsp_stages_0_input_ready;
  assign IBusSimplePlugin_iBusRsp_stages_0_input_payload = IBusSimplePlugin_fetchPc_output_payload;
  always @(*) begin
    IBusSimplePlugin_iBusRsp_stages_0_halt = 1'b0;
    if(when_IBusSimplePlugin_l306) begin
      IBusSimplePlugin_iBusRsp_stages_0_halt = 1'b1;
    end
  end

  assign _zz_IBusSimplePlugin_iBusRsp_stages_0_input_ready = (! IBusSimplePlugin_iBusRsp_stages_0_halt);
  assign IBusSimplePlugin_iBusRsp_stages_0_input_haltWhen_valid = (IBusSimplePlugin_iBusRsp_stages_0_input_valid && _zz_IBusSimplePlugin_iBusRsp_stages_0_input_ready);
  assign IBusSimplePlugin_iBusRsp_stages_0_input_ready = (IBusSimplePlugin_iBusRsp_stages_0_input_haltWhen_ready && _zz_IBusSimplePlugin_iBusRsp_stages_0_input_ready);
  assign IBusSimplePlugin_iBusRsp_stages_0_input_haltWhen_payload = IBusSimplePlugin_iBusRsp_stages_0_input_payload;
  assign IBusSimplePlugin_iBusRsp_stages_0_output_valid = IBusSimplePlugin_iBusRsp_stages_0_input_haltWhen_valid;
  assign IBusSimplePlugin_iBusRsp_stages_0_input_haltWhen_ready = IBusSimplePlugin_iBusRsp_stages_0_output_ready;
  assign IBusSimplePlugin_iBusRsp_stages_0_output_payload = IBusSimplePlugin_iBusRsp_stages_0_input_haltWhen_payload;
  assign IBusSimplePlugin_iBusRsp_stages_1_halt = 1'b0;
  assign _zz_IBusSimplePlugin_iBusRsp_stages_1_input_ready = (! IBusSimplePlugin_iBusRsp_stages_1_halt);
  assign IBusSimplePlugin_iBusRsp_stages_1_input_haltWhen_valid = (IBusSimplePlugin_iBusRsp_stages_1_input_valid && _zz_IBusSimplePlugin_iBusRsp_stages_1_input_ready);
  assign IBusSimplePlugin_iBusRsp_stages_1_input_ready = (IBusSimplePlugin_iBusRsp_stages_1_input_haltWhen_ready && _zz_IBusSimplePlugin_iBusRsp_stages_1_input_ready);
  assign IBusSimplePlugin_iBusRsp_stages_1_input_haltWhen_payload = IBusSimplePlugin_iBusRsp_stages_1_input_payload;
  assign IBusSimplePlugin_iBusRsp_stages_1_output_valid = IBusSimplePlugin_iBusRsp_stages_1_input_haltWhen_valid;
  assign IBusSimplePlugin_iBusRsp_stages_1_input_haltWhen_ready = IBusSimplePlugin_iBusRsp_stages_1_output_ready;
  assign IBusSimplePlugin_iBusRsp_stages_1_output_payload = IBusSimplePlugin_iBusRsp_stages_1_input_haltWhen_payload;
  assign IBusSimplePlugin_iBusRsp_flush = (IBusSimplePlugin_externalFlush || IBusSimplePlugin_iBusRsp_redoFetch);
  assign IBusSimplePlugin_iBusRsp_stages_0_output_toEvent_valid = IBusSimplePlugin_iBusRsp_stages_0_output_valid;
  assign IBusSimplePlugin_iBusRsp_stages_0_output_ready = IBusSimplePlugin_iBusRsp_stages_0_output_toEvent_ready;
  assign IBusSimplePlugin_iBusRsp_stages_0_output_toEvent_ready = ((1'b0 && (! IBusSimplePlugin_iBusRsp_stages_0_output_toEvent_m2sPipe_valid)) || IBusSimplePlugin_iBusRsp_stages_0_output_toEvent_m2sPipe_ready);
  assign IBusSimplePlugin_iBusRsp_stages_0_output_toEvent_m2sPipe_valid = _zz_IBusSimplePlugin_iBusRsp_stages_0_output_toEvent_m2sPipe_valid;
  assign IBusSimplePlugin_iBusRsp_stages_1_input_valid = IBusSimplePlugin_iBusRsp_stages_0_output_toEvent_m2sPipe_valid;
  assign IBusSimplePlugin_iBusRsp_stages_0_output_toEvent_m2sPipe_ready = IBusSimplePlugin_iBusRsp_stages_1_input_ready;
  assign IBusSimplePlugin_iBusRsp_stages_1_input_payload = IBusSimplePlugin_fetchPc_pcReg;
  always @(*) begin
    IBusSimplePlugin_iBusRsp_readyForError = 1'b1;
    if(IBusSimplePlugin_injector_decodeInput_valid) begin
      IBusSimplePlugin_iBusRsp_readyForError = 1'b0;
    end
    if(when_Fetcher_l322) begin
      IBusSimplePlugin_iBusRsp_readyForError = 1'b0;
    end
  end

  assign IBusSimplePlugin_iBusRsp_output_ready = ((1'b0 && (! IBusSimplePlugin_injector_decodeInput_valid)) || IBusSimplePlugin_injector_decodeInput_ready);
  assign IBusSimplePlugin_injector_decodeInput_valid = _zz_IBusSimplePlugin_injector_decodeInput_valid;
  assign IBusSimplePlugin_injector_decodeInput_payload_pc = _zz_IBusSimplePlugin_injector_decodeInput_payload_pc;
  assign IBusSimplePlugin_injector_decodeInput_payload_rsp_error = _zz_IBusSimplePlugin_injector_decodeInput_payload_rsp_error;
  assign IBusSimplePlugin_injector_decodeInput_payload_rsp_inst = _zz_IBusSimplePlugin_injector_decodeInput_payload_rsp_inst;
  assign IBusSimplePlugin_injector_decodeInput_payload_isRvc = _zz_IBusSimplePlugin_injector_decodeInput_payload_isRvc;
  assign when_Fetcher_l322 = (! IBusSimplePlugin_pcValids_0);
  assign when_Fetcher_l331 = (! (! IBusSimplePlugin_iBusRsp_stages_1_input_ready));
  assign when_Fetcher_l331_1 = (! (! IBusSimplePlugin_injector_decodeInput_ready));
  assign when_Fetcher_l331_2 = (! execute_arbitration_isStuck);
  assign when_Fetcher_l331_3 = (! memory_arbitration_isStuck);
  assign when_Fetcher_l331_4 = (! writeBack_arbitration_isStuck);
  assign IBusSimplePlugin_pcValids_0 = IBusSimplePlugin_injector_nextPcCalc_valids_1;
  assign IBusSimplePlugin_pcValids_1 = IBusSimplePlugin_injector_nextPcCalc_valids_2;
  assign IBusSimplePlugin_pcValids_2 = IBusSimplePlugin_injector_nextPcCalc_valids_3;
  assign IBusSimplePlugin_pcValids_3 = IBusSimplePlugin_injector_nextPcCalc_valids_4;
  assign IBusSimplePlugin_injector_decodeInput_ready = (! decode_arbitration_isStuck);
  always @(*) begin
    decode_arbitration_isValid = IBusSimplePlugin_injector_decodeInput_valid;
    if(IBusSimplePlugin_forceNoDecodeCond) begin
      decode_arbitration_isValid = 1'b0;
    end
  end

  assign iBus_cmd_valid = IBusSimplePlugin_cmd_valid;
  assign IBusSimplePlugin_cmd_ready = iBus_cmd_ready;
  assign iBus_cmd_payload_pc = IBusSimplePlugin_cmd_payload_pc;
  assign IBusSimplePlugin_pending_next = (_zz_IBusSimplePlugin_pending_next - _zz_IBusSimplePlugin_pending_next_3);
  assign IBusSimplePlugin_cmdFork_canEmit = (IBusSimplePlugin_iBusRsp_stages_0_output_ready && (IBusSimplePlugin_pending_value != 3'b111));
  assign when_IBusSimplePlugin_l306 = (IBusSimplePlugin_iBusRsp_stages_0_input_valid && ((! IBusSimplePlugin_cmdFork_canEmit) || (! IBusSimplePlugin_cmd_ready)));
  assign IBusSimplePlugin_cmd_valid = (IBusSimplePlugin_iBusRsp_stages_0_input_valid && IBusSimplePlugin_cmdFork_canEmit);
  assign IBusSimplePlugin_cmd_fire = (IBusSimplePlugin_cmd_valid && IBusSimplePlugin_cmd_ready);
  assign IBusSimplePlugin_pending_inc = IBusSimplePlugin_cmd_fire;
  assign IBusSimplePlugin_cmd_payload_pc = {IBusSimplePlugin_iBusRsp_stages_0_input_payload[31 : 2],2'b00};
  assign iBus_rsp_toStream_valid = iBus_rsp_valid;
  assign iBus_rsp_toStream_payload_error = iBus_rsp_payload_error;
  assign iBus_rsp_toStream_payload_inst = iBus_rsp_payload_inst;
  assign iBus_rsp_toStream_ready = IBusSimplePlugin_rspJoin_rspBuffer_c_io_push_ready;
  assign IBusSimplePlugin_rspJoin_rspBuffer_flush = ((IBusSimplePlugin_rspJoin_rspBuffer_discardCounter != 3'b000) || IBusSimplePlugin_iBusRsp_flush);
  assign IBusSimplePlugin_rspJoin_rspBuffer_output_valid = (IBusSimplePlugin_rspJoin_rspBuffer_c_io_pop_valid && (IBusSimplePlugin_rspJoin_rspBuffer_discardCounter == 3'b000));
  assign IBusSimplePlugin_rspJoin_rspBuffer_output_payload_error = IBusSimplePlugin_rspJoin_rspBuffer_c_io_pop_payload_error;
  assign IBusSimplePlugin_rspJoin_rspBuffer_output_payload_inst = IBusSimplePlugin_rspJoin_rspBuffer_c_io_pop_payload_inst;
  assign IBusSimplePlugin_rspJoin_rspBuffer_c_io_pop_ready = (IBusSimplePlugin_rspJoin_rspBuffer_output_ready || IBusSimplePlugin_rspJoin_rspBuffer_flush);
  assign io_pop_fire = (IBusSimplePlugin_rspJoin_rspBuffer_c_io_pop_valid && IBusSimplePlugin_rspJoin_rspBuffer_c_io_pop_ready);
  assign IBusSimplePlugin_pending_dec = io_pop_fire;
  assign IBusSimplePlugin_rspJoin_fetchRsp_isRvc = 1'b0;
  assign IBusSimplePlugin_rspJoin_fetchRsp_pc = IBusSimplePlugin_iBusRsp_stages_1_output_payload;
  always @(*) begin
    IBusSimplePlugin_rspJoin_fetchRsp_rsp_error = IBusSimplePlugin_rspJoin_rspBuffer_output_payload_error;
    if(when_IBusSimplePlugin_l378) begin
      IBusSimplePlugin_rspJoin_fetchRsp_rsp_error = 1'b0;
    end
  end

  assign IBusSimplePlugin_rspJoin_fetchRsp_rsp_inst = IBusSimplePlugin_rspJoin_rspBuffer_output_payload_inst;
  assign when_IBusSimplePlugin_l378 = (! IBusSimplePlugin_rspJoin_rspBuffer_output_valid);
  assign IBusSimplePlugin_rspJoin_exceptionDetected = 1'b0;
  assign IBusSimplePlugin_rspJoin_join_valid = (IBusSimplePlugin_iBusRsp_stages_1_output_valid && IBusSimplePlugin_rspJoin_rspBuffer_output_valid);
  assign IBusSimplePlugin_rspJoin_join_payload_pc = IBusSimplePlugin_rspJoin_fetchRsp_pc;
  assign IBusSimplePlugin_rspJoin_join_payload_rsp_error = IBusSimplePlugin_rspJoin_fetchRsp_rsp_error;
  assign IBusSimplePlugin_rspJoin_join_payload_rsp_inst = IBusSimplePlugin_rspJoin_fetchRsp_rsp_inst;
  assign IBusSimplePlugin_rspJoin_join_payload_isRvc = IBusSimplePlugin_rspJoin_fetchRsp_isRvc;
  assign IBusSimplePlugin_rspJoin_join_fire = (IBusSimplePlugin_rspJoin_join_valid && IBusSimplePlugin_rspJoin_join_ready);
  assign IBusSimplePlugin_iBusRsp_stages_1_output_ready = (IBusSimplePlugin_iBusRsp_stages_1_output_valid ? IBusSimplePlugin_rspJoin_join_fire : IBusSimplePlugin_rspJoin_join_ready);
  assign IBusSimplePlugin_rspJoin_rspBuffer_output_ready = IBusSimplePlugin_rspJoin_join_fire;
  assign _zz_IBusSimplePlugin_rspJoin_join_ready = (! IBusSimplePlugin_rspJoin_exceptionDetected);
  assign IBusSimplePlugin_rspJoin_join_haltWhen_valid = (IBusSimplePlugin_rspJoin_join_valid && _zz_IBusSimplePlugin_rspJoin_join_ready);
  assign IBusSimplePlugin_rspJoin_join_ready = (IBusSimplePlugin_rspJoin_join_haltWhen_ready && _zz_IBusSimplePlugin_rspJoin_join_ready);
  assign IBusSimplePlugin_rspJoin_join_haltWhen_payload_pc = IBusSimplePlugin_rspJoin_join_payload_pc;
  assign IBusSimplePlugin_rspJoin_join_haltWhen_payload_rsp_error = IBusSimplePlugin_rspJoin_join_payload_rsp_error;
  assign IBusSimplePlugin_rspJoin_join_haltWhen_payload_rsp_inst = IBusSimplePlugin_rspJoin_join_payload_rsp_inst;
  assign IBusSimplePlugin_rspJoin_join_haltWhen_payload_isRvc = IBusSimplePlugin_rspJoin_join_payload_isRvc;
  assign IBusSimplePlugin_iBusRsp_output_valid = IBusSimplePlugin_rspJoin_join_haltWhen_valid;
  assign IBusSimplePlugin_rspJoin_join_haltWhen_ready = IBusSimplePlugin_iBusRsp_output_ready;
  assign IBusSimplePlugin_iBusRsp_output_payload_pc = IBusSimplePlugin_rspJoin_join_haltWhen_payload_pc;
  assign IBusSimplePlugin_iBusRsp_output_payload_rsp_error = IBusSimplePlugin_rspJoin_join_haltWhen_payload_rsp_error;
  assign IBusSimplePlugin_iBusRsp_output_payload_rsp_inst = IBusSimplePlugin_rspJoin_join_haltWhen_payload_rsp_inst;
  assign IBusSimplePlugin_iBusRsp_output_payload_isRvc = IBusSimplePlugin_rspJoin_join_haltWhen_payload_isRvc;
  assign _zz_dBus_cmd_valid = 1'b0;
  always @(*) begin
    execute_DBusSimplePlugin_skipCmd = 1'b0;
    if(execute_ALIGNEMENT_FAULT) begin
      execute_DBusSimplePlugin_skipCmd = 1'b1;
    end
  end

  assign dBus_cmd_valid = (((((execute_arbitration_isValid && execute_MEMORY_ENABLE) && (! execute_arbitration_isStuckByOthers)) && (! execute_arbitration_isFlushed)) && (! execute_DBusSimplePlugin_skipCmd)) && (! _zz_dBus_cmd_valid));
  assign dBus_cmd_payload_wr = execute_MEMORY_STORE;
  assign dBus_cmd_payload_size = execute_INSTRUCTION[13 : 12];
  always @(*) begin
    case(dBus_cmd_payload_size)
      2'b00 : begin
        _zz_dBus_cmd_payload_data = {{{execute_RS2[7 : 0],execute_RS2[7 : 0]},execute_RS2[7 : 0]},execute_RS2[7 : 0]};
      end
      2'b01 : begin
        _zz_dBus_cmd_payload_data = {execute_RS2[15 : 0],execute_RS2[15 : 0]};
      end
      default : begin
        _zz_dBus_cmd_payload_data = execute_RS2[31 : 0];
      end
    endcase
  end

  assign dBus_cmd_payload_data = _zz_dBus_cmd_payload_data;
  assign when_DBusSimplePlugin_l435 = ((((execute_arbitration_isValid && execute_MEMORY_ENABLE) && (! dBus_cmd_ready)) && (! execute_DBusSimplePlugin_skipCmd)) && (! _zz_dBus_cmd_valid));
  always @(*) begin
    case(dBus_cmd_payload_size)
      2'b00 : begin
        _zz_execute_DBusSimplePlugin_formalMask = 4'b0001;
      end
      2'b01 : begin
        _zz_execute_DBusSimplePlugin_formalMask = 4'b0011;
      end
      default : begin
        _zz_execute_DBusSimplePlugin_formalMask = 4'b1111;
      end
    endcase
  end

  assign execute_DBusSimplePlugin_formalMask = (_zz_execute_DBusSimplePlugin_formalMask <<< dBus_cmd_payload_address[1 : 0]);
  assign dBus_cmd_payload_mask = execute_DBusSimplePlugin_formalMask;
  assign dBus_cmd_payload_address = execute_SRC_ADD;
  assign when_DBusSimplePlugin_l490 = (((memory_arbitration_isValid && memory_MEMORY_ENABLE) && (! memory_MEMORY_STORE)) && ((! dBus_rsp_ready) || 1'b0));
  always @(*) begin
    writeBack_DBusSimplePlugin_rspShifted = writeBack_MEMORY_READ_DATA;
    case(writeBack_MEMORY_ADDRESS_LOW)
      2'b01 : begin
        writeBack_DBusSimplePlugin_rspShifted[7 : 0] = writeBack_MEMORY_READ_DATA[15 : 8];
      end
      2'b10 : begin
        writeBack_DBusSimplePlugin_rspShifted[15 : 0] = writeBack_MEMORY_READ_DATA[31 : 16];
      end
      2'b11 : begin
        writeBack_DBusSimplePlugin_rspShifted[7 : 0] = writeBack_MEMORY_READ_DATA[31 : 24];
      end
      default : begin
      end
    endcase
  end

  assign switch_Misc_l245 = writeBack_INSTRUCTION[13 : 12];
  assign _zz_writeBack_DBusSimplePlugin_rspFormated = (writeBack_DBusSimplePlugin_rspShifted[7] && (! writeBack_INSTRUCTION[14]));
  always @(*) begin
    _zz_writeBack_DBusSimplePlugin_rspFormated_1[31] = _zz_writeBack_DBusSimplePlugin_rspFormated;
    _zz_writeBack_DBusSimplePlugin_rspFormated_1[30] = _zz_writeBack_DBusSimplePlugin_rspFormated;
    _zz_writeBack_DBusSimplePlugin_rspFormated_1[29] = _zz_writeBack_DBusSimplePlugin_rspFormated;
    _zz_writeBack_DBusSimplePlugin_rspFormated_1[28] = _zz_writeBack_DBusSimplePlugin_rspFormated;
    _zz_writeBack_DBusSimplePlugin_rspFormated_1[27] = _zz_writeBack_DBusSimplePlugin_rspFormated;
    _zz_writeBack_DBusSimplePlugin_rspFormated_1[26] = _zz_writeBack_DBusSimplePlugin_rspFormated;
    _zz_writeBack_DBusSimplePlugin_rspFormated_1[25] = _zz_writeBack_DBusSimplePlugin_rspFormated;
    _zz_writeBack_DBusSimplePlugin_rspFormated_1[24] = _zz_writeBack_DBusSimplePlugin_rspFormated;
    _zz_writeBack_DBusSimplePlugin_rspFormated_1[23] = _zz_writeBack_DBusSimplePlugin_rspFormated;
    _zz_writeBack_DBusSimplePlugin_rspFormated_1[22] = _zz_writeBack_DBusSimplePlugin_rspFormated;
    _zz_writeBack_DBusSimplePlugin_rspFormated_1[21] = _zz_writeBack_DBusSimplePlugin_rspFormated;
    _zz_writeBack_DBusSimplePlugin_rspFormated_1[20] = _zz_writeBack_DBusSimplePlugin_rspFormated;
    _zz_writeBack_DBusSimplePlugin_rspFormated_1[19] = _zz_writeBack_DBusSimplePlugin_rspFormated;
    _zz_writeBack_DBusSimplePlugin_rspFormated_1[18] = _zz_writeBack_DBusSimplePlugin_rspFormated;
    _zz_writeBack_DBusSimplePlugin_rspFormated_1[17] = _zz_writeBack_DBusSimplePlugin_rspFormated;
    _zz_writeBack_DBusSimplePlugin_rspFormated_1[16] = _zz_writeBack_DBusSimplePlugin_rspFormated;
    _zz_writeBack_DBusSimplePlugin_rspFormated_1[15] = _zz_writeBack_DBusSimplePlugin_rspFormated;
    _zz_writeBack_DBusSimplePlugin_rspFormated_1[14] = _zz_writeBack_DBusSimplePlugin_rspFormated;
    _zz_writeBack_DBusSimplePlugin_rspFormated_1[13] = _zz_writeBack_DBusSimplePlugin_rspFormated;
    _zz_writeBack_DBusSimplePlugin_rspFormated_1[12] = _zz_writeBack_DBusSimplePlugin_rspFormated;
    _zz_writeBack_DBusSimplePlugin_rspFormated_1[11] = _zz_writeBack_DBusSimplePlugin_rspFormated;
    _zz_writeBack_DBusSimplePlugin_rspFormated_1[10] = _zz_writeBack_DBusSimplePlugin_rspFormated;
    _zz_writeBack_DBusSimplePlugin_rspFormated_1[9] = _zz_writeBack_DBusSimplePlugin_rspFormated;
    _zz_writeBack_DBusSimplePlugin_rspFormated_1[8] = _zz_writeBack_DBusSimplePlugin_rspFormated;
    _zz_writeBack_DBusSimplePlugin_rspFormated_1[7 : 0] = writeBack_DBusSimplePlugin_rspShifted[7 : 0];
  end
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
