feaksel/5level-inverter/02-embedded/stm32-fpga-hybrid/stm32/Core/Inc/main.h

/**
 * @file main.h
 * @brief Main header file for STM32F401RE + FPGA Hybrid System
 *
 * @author 5-Level Inverter Project
 * @date 2025-12-02
 */

#ifndef MAIN_H
#define MAIN_H

#ifdef __cplusplus
extern "C" {
#endif

#include "stm32f4xx_hal.h"

//==========================================================================
// Function Prototypes
//==========================================================================

void Error_Handler(void);

#ifdef __cplusplus
}
#endif

#endif /* MAIN_H */
