feaksel/5level-inverter/02-embedded/stm32f303re/Core/Inc/main.h

/**
 * @file main.h
 * @brief Header for main.c - STM32F303RE Implementation
 */

#ifndef __MAIN_H
#define __MAIN_H

#ifdef __cplusplus
extern "C" {
#endif

#include "stm32f3xx_hal.h"

void Error_Handler(void);

#ifdef __cplusplus
}
#endif

#endif /* __MAIN_H */
